Joshua203-byte/Pcb/Guía_del_Estado_del_Arte_Infografía.png

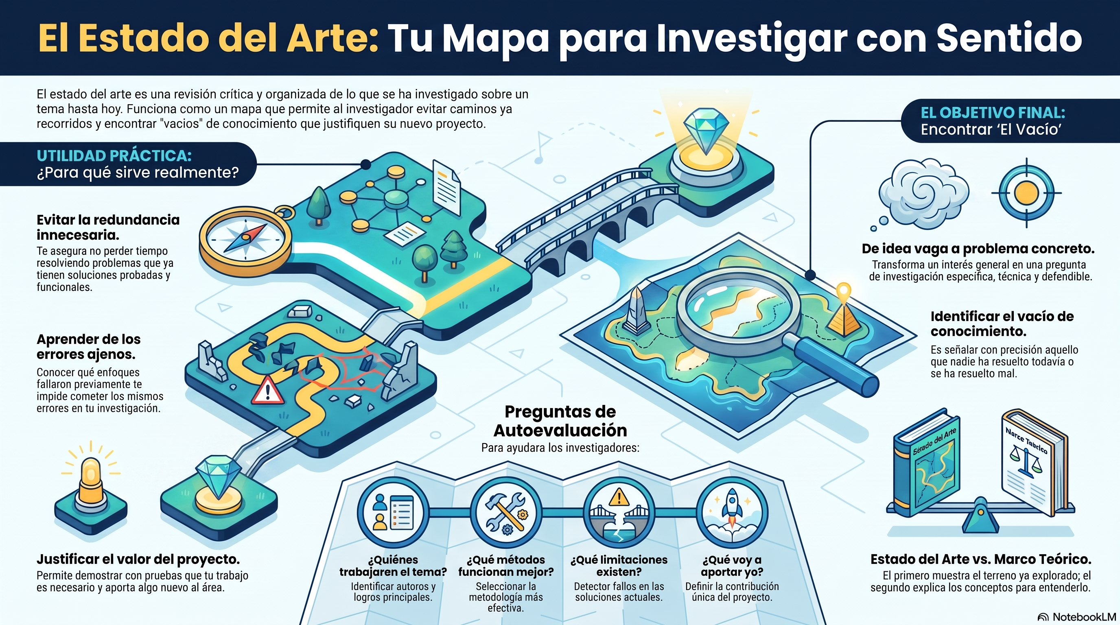
Guía_del_Estado_del_Arte_Infografía.png
