Joshua203-byte/Pcb/Avance2_secciones.pdf

UNIVERSIDAD — ASIGNATURA DE SEMICONDUCTORES Aprendizaje Basado en Proyectos

# Sistema de monitoreo electrónico y modelo predictivo de mantenimiento de un panel solar

Segundo avance del proyecto

Fase 3 — Diseño del circuito de adquisición Secciones: componentes, esquemático, dashboard, muestreo, alimentación, transmisión y montaje

INTEGRANTES

Joshua Garcilazo
Daniel Salguero
Alfredo Cortez

DOCENTE

Karen Pimentel

12 de octubre de 2026

## Índice

I | Introducción | 3
II | Microcontrolador y acondicionamiento de señal | 3
III | Alimentación del circuito | 5
IV | Transmisión y registro de datos | 5
V | Estrategia de muestreo | 7
VI | Decisión de montaje del módulo | 7
VII | Esquemático y lista de componentes | 9
VIII Diseño del dashboard | 9
IX | Simulación o pruebas físicas | 11
X | Limitaciones y ajustes pendientes | 15
Referencias | 16
Anexo A. Esquemático completo (A3) | 18

# Sistema de monitoreo electrónico y modelo predictivo de mantenimiento de un panel solar

Segundo avance — componentes, esquemático, dashboard y simulación

Joshua Garcilazo, Daniel Salguero y Alfredo Cortez Asignatura de Semiconductores — Aprendizaje Basado en Proyectos Docente: Karen Pimentel
12 de octubre de 2026

Resumen—Se presenta el diseño del sistema de adquisición del segundo avance. Con un voltaje de circuito abierto de 9 V, el ESP32 y el ADS1115 se dimensionan con un divisor de 4.3:1 y la escala de ±4.096 V (cuenta de 0.54 mV en el módulo), y la corriente se mide sobre derivaciones de 1 Ω. El circuito se alimenta con una batería externa de 10 000 mAh (consumo medio de 164 mA a 5 V con Wi-Fi, unas 27 h de autonomía) y el ESP32 envía cada barrido por Wi-Fi a un servidor local, que lo guarda en CSV y alimenta un dashboard donde el índice de rendimiento diario, corregido por temperatura, activa una alerta de mantenimiento. Se incluyen el esquemático, la lista de materiales (USD 32.57), la estrategia de muestreo (barrido de

### 23 puntos de unos 2 min, con descarte por irradiancia inestable)

y la decisión de montaje: a partir de la literatura y de una simulación de cielo despejado para el sitio (13.67° N) se adopta un módulo fijo a 30° al sur, que en noviembre y diciembre rinde 9 % más que a 14° y conserva la comparabilidad del índice. La simulación del circuito completo (ngspice) confirma que las lecturas de V, I, temperatura e irradiancia quedan dentro de rango en escenarios de 200 a 1 100 W/m²
y de 15 a 65 °C, con
una diferencia de −0.4 % en la potencia máxima frente a la teoría a 1 000 W/m²

Palabras clave—ADS1115, acondicionamiento de señal, curva I-V, dashboard, índice de rendimiento, Wi-Fi, alimentación por batería, montaje fijo.

I. INTRODUCCIÓN

Este documento presenta el segundo avance del proyecto: la selección de componentes (microcontrolador, acondicionamiento de señal, alimentación y medio de transmisión), el esquemático con su lista de materiales, el diseño del dashboard, la estrategia de muestreo y la decisión de montaje del módulo. Completa el diseño del primer avance [1], que fijó los sensores (ADS1115, derivaciones de 1 Ω, divisor 33 kΩ/10 kΩ, DS18B20), el banco de ocho resistencias conmutadas por relés y el protocolo pulsado de medición. La sección de simulación se integra cuando se reciban sus resultados.
El criterio que gobierna las decisiones es el mismo del primer avance: el sistema debe distinguir entre pérdidas reversibles y degradación permanente, y por eso se prioriza la repetibilidad entre sesiones sobre la ganancia energética absoluta. El cambio más importante respecto del primer avance es el voltaje de circuito abierto del módulo: las pruebas del equipo indican 9 V y no los 6.0 a 6.5 V supuestos, lo que obliga a cambiar la escala del canal de voltaje (sección II).

TABLA 1
ALTERNATIVAS DE MICROCONTROLADOR (DATOS DE LAS HOJAS DE DATOS DE CADA FABRICANTE)
Opción | Lógica | Wi-Fi | GPIO | Decisión
ESP32- WROOM-32 [22] | 3.3 V | 802.11 b/g/n | hasta 32 | Elegido
Arduino | Uno
(ATmega328P)
[23]
5 V | No | 14 digitales
y | 6
analógicas

Descartado:
requiere | adaptar
niveles | y | un
módulo Wi-Fi
Raspberry Pi
Pico W [24]

3.3 V 802.11n (2.4
GHz)
26 | Viable; | se
mantiene el ESP32
por | continuidad
con | el | primer
avance

II. MICROCONTROLADOR Y ACONDICIONAMIENTO DE SEÑAL

A. Microcontrolador
Se mantiene el ESP32-WROOM-32 del primer avance [1]. Cumple los requisitos del diseño: su lógica es de 3.3 V, igual que la del ADS1115 y la de las entradas ópticas del módulo de relés [26]; tiene bus I²C por hardware (SDA en GPIO21 y SCL en GPIO22) y 1-Wire por software (GPIO4); y trae radio Wi-Fi integrada para la transmisión de la sección IV, sin módulos adicionales. Las ocho salidas hacia los relés usan GPIO13, 14, 16, 17, 18, 19, 23 y 25, que evitan los pines de arranque (GPIO0, 2, 12 y 15, entre otros) cuyo nivel al encender condiciona el modo de arranque del chip. El convertidor interno no se usa para medir, así que el ADC2 y el Wi-Fi no entran en conflicto.
La Tabla 1 compara el ESP32 con las otras opciones razonables del curso. El criterio decisivo es que el sistema necesita Wi-Fi, lógica de 3.3 V compatible con el ADS1115 y suficientes salidas digitales, sin módulos extra.
B. Convertidor analógico-digital
La Tabla 2 justifica el uso de un convertidor externo. Con 9 V y unos 0.2 A, la señal útil es pequeña frente al error del ADC interno del ESP32, cuya característica es no lineal y exige calibración por unidad [22]. El ADS1115 ofrece 16 bits, entrada diferencial (necesaria para leer la derivación sin referenciarla a tierra) y amplificador de ganancia programable [15], con el cual la cuenta es de 125 µV en ±4.096V y de 15.6 µV en ±0.512V.

TABLA 2
ALTERNATIVAS DE CONVERSIÓN ANALÓGICA-DIGITAL
Opción | Bits | Cuenta | Observación

ADC interno del
ESP32
12 | 0.8 mV (3.3 V) | No | lineal; | sin
entrada diferencial
MCP3008 [25] | 10 | 3.2 mV (3.3 V) | Pseudodiferencial,
sin | PGA: | la
derivación | (0.2
a 0.3 V) daría pocas
cuentas
ADS1115 [15] | 16 | 125 a 15.6 µV | Elegido: | PGA
y | entradas
diferenciales

TABLA 3
ESCALAS DEL CANAL DE VOLTAJE (DIVISOR 4.3:1, ESCALA DE ±4.096V)
Condición | Módulo (V) | En A0 (V) | Cuentas
Voc de las pruebas | 9.0 | 2.09 | 16 744
Voc con carga (práctica 3) | 9.09 | 2.11 | 16 912
Máximo de diseño | 11 | 2.56 | 20 465
Límite de la escala de ±2.048 V | 8.8 | 2.05 | —
Límite práctico (VDD = 3.3 V) | 14.2 | 3.30 | 26 400
Límite absoluto (VDD +0.3 V) | 15.5 | 3.60 | —
C. Canal de voltaje
El voltaje del módulo se mide en A0 con el divisor R1 = 33 kΩ y R2 = 10 kΩ:

VADC = Vmod

R2
R1 +R2

=

Vmod
4.3
. | (1)

El primer avance supuso un voltaje de circuito abierto de 6.0 a 6.5 V [1]; las pruebas del equipo indican en cambio 9 V (en la práctica 3 se midieron 9.09 V con carga [13], de modo que el valor real es igual o mayor). Con ese dato el divisor entrega 2.09 V, por encima de la escala de ±2.048V del primer avance, que se saturaría desde los 8.8 V del módulo. Por eso el canal se opera en la escala de ±4.096V (Tabla 3), con una cuenta de 125 µV, es decir 0.54 mV en el módulo. Se toma 11 V como máximo de diseño, para dejar margen por irradiancia alta y temperatura baja.
El divisor consume 9 V/43 kΩ ≈ 0.21mA (0.1 % de la corriente nominal), que se descuenta en el cálculo de la corriente. El filtro R3 = 1 kΩ y C1 = 0.1µF (corte de unos 1.6 kHz) limita el ruido sin afectar el asentamiento (sección V). La impedancia de entrada del ADS1115 es de varios megaohmios [15], por lo que el error de carga sobre el divisor (unos 7.7 kΩ equivalentes) es del orden de 0.1 %, y se corrige en la calibración.
D. Canal de corriente
La corriente del módulo se mide como la caída en una derivación de 1 Ω y 1 W, con lectura diferencial entre A2 y A3 (R_sh1 en el esquemático); la corriente de la celda de referencia se mide con otra derivación igual en A1. Con la escala de ±0.512V la cuenta es de 15.6 µV, o 15.6 µA sobre 1 Ω. Con 1.5 W y 9 V la corriente de cortocircuito esperada es de unos 0.21 A (hasta 0.33 A según el primer avance), es decir de 0.21 a 0.33 V sobre la derivación: entre 41 y 64 % de la escala, con un margen de 1.6 veces. La potencia disipada es I

2R ≤ 0.11W, muy por debajo de 1 W. Como el voltaje se toma en los terminales del módulo, la caída en la derivación no sesga la lectura de V; solo desplaza ligeramente el punto de operación.

E. Canal de temperatura
El DS18B20 se lee por 1-Wire en GPIO4, con una resistencia de subida de 4.7 kΩ (R4) a 3.3 V y un capacitor de desacople de 0.1 µF (C3). Su exactitud es de ±0.5

◦C entre −10 ◦C y 85 ◦C y
su resolución de 0.0625 ◦C a 12 bits [16]. Se fija al respaldo del módulo con cinta de aluminio, para que mida la temperatura de la celda y no la del aire.
F. Canal de irradiancia
La irradiancia se mide con una celda de referencia: otro módulo igual (J4) en el mismo plano que el de prueba, en cortocircuito a través de una derivación de 1 Ω (R_sh2, entrada A1, escala de ±0.512 V). La corriente de cortocircuito de una celda de silicio es proporcional a la irradiancia, y al ser del mismo material y de la misma ventana que el módulo medido, tiene su misma respuesta espectral y angular, lo que no ocurre con un fotorresistor (LDR), cuya respuesta es no lineal, lenta y con tolerancias de decenas de por ciento, ni con un fotodiodo suelto. Un piranómetro de termopila sería más exacto, pero cuesta mucho más que todo el proyecto. Con la Isc supuesta de 0.212 A a 1 000 W/m²
la señal es de 42 a 233 mV para 200 a 1 100 W/m²

(resolución de 0.07 W/m² por cuenta, 2.2 veces de margen en el máximo). La relación entre tensión e irradiancia debe calibrarse con una referencia o con los datos de la celda, y por eso la incertidumbre de G (supuesta de 3 a 5 % sin calibrar) domina la del índice de rendimiento.

G. Protección de entradas
Las entradas del ADS1115 admiten de −0.3 V aVDD+0.3 V (3.6 V con 3.3 V) [15]. En A0 el divisor mantiene la entrada bajo ese límite hasta 15.5 V en el módulo, y en caso de una sobretensión (por ejemplo 20 V, que da 4.65 V en A0) los diodos internos de la entrada limitarían con una corriente menor de 0.1 mA, pues la resistencia en serie es de unos 8.7 kΩ (el equivalente del divisor más R3), corriente muy pequeña para los diodos de protección de la entrada (la hoja de datos fija el límite de VDD + 0.3 V); R3 y C1 filtran además los transitorios. En las derivaciones la señal máxima es de 0.23 V, con modo común cercano a tierra (derivación en el lado de baja), de modo que no hay riesgo con el módulo conectado de forma normal. No se agregan diodos TVS ni zener porque el módulo no puede entregar más de unos 10 V y la corriente de cortocircuito es de 0.2 A.
H. Presupuesto de error
La Tabla 4 resume los errores máximos de cada canal, sin calibrar y con la calibración propuesta. Las tolerancias de las resistencias son de 1 % (película metálica), la ganancia del ADS1115 se toma del orden de 0.15 % máximo [15] y la cuantización (125 µV en A0 y 15.6 µV en la derivación) es despreciable frente a las demás (menos de 0.01 % en el punto de máxima potencia). El efecto de carga del ADS1115 sobre el divisor (0.17 %) proviene de la simulación (sección IX).
Los 3.0 % de la potencia sin calibrar son menores que el umbral de 10 % del indicador de mantenimiento, de modo que el

TABLA 4
ERRORES MÁXIMOS ESTIMADOS EN EL PUNTO DE MÁXIMA POTENCIA
Fuente | Sin calibrar | Con calibración
Divisor R1–R2 (1 %) | 1.5 % en V | ajustable
Derivación (1 %) | 1.0 % en I | ajustable
Ganancia del ADS1115 | 0.15 % | —
Carga del ADS1115 | 0.17 % en V | corregible
Cuantización | < 0.01 % | < 0.01 %
Voltaje (suma lineal) | 1.8 % | exactitud | del
| | multímetro
Corriente (suma lineal) | 1.2 % | exactitud | del
| | multímetro
Potencia | ≈ 3.0 % | ≈ la del multímetro
Temperatura (DS18B20) | ±0.5 °C | 0.2 % en la potencia

TABLA 5
PRESUPUESTO DE CONSUMO A 5 V
Elemento | Corriente (mA)
ESP32 (placa, Wi-Fi conectado), valor de diseño | 130
ADS1115, típico [15] | 0.15
DS18B20, activo [16] | 1.5
Reposo (sin relés cerrados) | 131.7
Relé por canal (bobina 71 [26] + optoacoplador 5), supuesto | 76
Ocho canales cerrados (pico del barrido) | 608
Pico total | 740
Promedio de relés con ciclo de trabajo 5.4 % | 32.8
Promedio total | 164

sistema distingue la suciedad sin calibración fina; la calibración contra el multímetro (exactitud típica de 0.5 a 1 %) reduce el error a ese orden y se hará con las pruebas físicas.

III. ALIMENTACIÓN DEL CIRCUITO

A. Presupuesto de consumo
Los ensayos serán de varias horas a la intemperie y sin toma de corriente cercana. El consumo se estimó con los valores de la Tabla 5. El ESP32 se opera con la conexión Wi-Fi activa (sección IV); se toma 130 mA como valor de diseño promedio, entre el reposo de radio (25 a 35 mA) y la transmisión (250 a 280 mA) medidos en una placa de desarrollo [14]. El valor incluye el convertidor USB–UART y el LED de la placa y se verificará con el montaje real. Para los relés se supone una bobina de 5 V y unos 71 mA por canal, más unos 5 mA de optoacoplador y LED; es un supuesto a confirmar con la hoja del módulo adquirido. El ciclo de trabajo de los relés se calcula como

D =

ton

tint

=

0.27 s
5 s = 5.4%, | (2)

donde ton = 0.20 s de asentamiento más unos 0.07 s de lectura (sección V). El promedio de 164 mA a 5 V equivale a 0.82 W y, en una sesión de 6 h, a 4.9 Wh. Los picos de transmisión del Wi-Fi (250 a 280 mA) no coinciden con los de los relés, porque el firmware no transmite mientras haya relés cerrados.

B. Alternativas
Se adopta una batería externa USB (power bank). La Tabla 6 resume la comparación. Con una capacidad nominal de 10 000 mAh a 3.7 V (37 Wh) y un factor de aprovechamiento de 60 % a

TABLA 6
ALTERNATIVAS DE ALIMENTACIÓN
Alternativa | Ventaja | Riesgo o costo
Red de 115 V con adaptador de 5 V y extensión | Sin límite de autonomía | Requiere toma y extensión a la intemperie (riesgo eléctrico y de lluvia); adaptador conmutado
USB de la laptop (todo) | Sin componentes adicionales | Límite de 500 mA en USB 2.0 (900 mA en USB 3.x) frente a un pico de 740 mA

Batería de 9 V con regulador

7805 | — | Descartada en el primer avance: costo recurrente y caída de tensión
Batería externa USB | Independiente de la red; capacidad sobrada; sin cambios en el circuito | Algunos modelos se apagan con corrientes bajas

5 V por las pérdidas de conversión (supuesto), la autonomía es

taut =

ηu Enom

Pprom

=

0.6×37 Wh
0.82 W
≈ 27 h, | (3)

unas 4.5 veces la sesión de 6 h de la prueba de estrés prevista en el plan de trabajo. Tanto el adaptador como la batería incluyen un convertidor conmutado; el ruido de alimentación se mitiga con la referencia interna del ADS1115 y el filtrado descritos en el primer avance [1], y se verificará en las pruebas.

C. Arquitectura adoptada y precauciones
Como se ve en la Fig. 1, la batería externa alimenta al ESP32 (por el pin VIN) y a las bobinas del módulo de relés, y la laptop recibe los datos por Wi-Fi. Se descartó dejar las bobinas solas en la batería porque su consumo medio sería de unos 33 mA y muchas baterías se apagan con corrientes bajas; con el ESP32 en el mismo circuito la carga mínima es de unos 130 mA. Las precauciones son:
- Una sola fuente de 5 V. El cable USB solo se conecta para programar o depurar y con la batería desconectada, para evitar dos fuentes de 5 V en paralelo. Con el Wi-Fi, durante los ensayos no hace falta ningún cable entre la placa y la laptop.
- Picos. El pico de 740 mA ocurre solo con todos los relés cerrados y dura menos de 0.3 s; está dentro de la capacidad de la batería.
- Apagado automático. Se probará la batería elegida con la carga real antes de cada sesión de varias horas.

IV. TRANSMISIÓN Y REGISTRO DE DATOS

A. Medio de transmisión
Los datos se envían del ESP32 a la laptop por Wi-Fi (2.4 GHz) mediante una petición HTTP POST con contenido JSON a un servidor que se ejecuta en la laptop. El ESP32 no puede usar la dirección localhost, que en el ESP32 se refiere a sí mismo; debe usar la dirección IP de la laptop en la red local. La red puede ser la de un enrutador o un punto de acceso creado por la propia laptop o por un teléfono, siempre en 2.4 GHz, que es la única banda del ESP32; con un punto de acceso propio no se depende del alcance de la red doméstica y la dirección de la laptop es fija. Frente al USB, el Wi-Fi elimina el cable entre

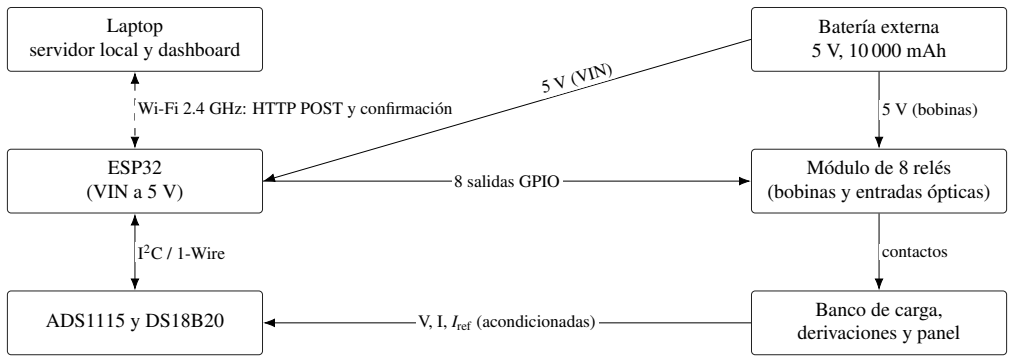
[picture p2: figure]
Laptop servidor local y dashboard; Batería externa 5 V, 10 000 mAh; ESP32 (VIN a 5 V); Módulo de 8 relés (bobinas y entradas ópticas); ADS1115 y DS18B20; Banco de carga,; derivaciones y panel; Wi-Fi 2.4 GHz: HTTP POST y confirmación; 5 V (VIN); 5 V (bobinas); 8 salidas GPIO; 2C / 1-Wire; contactos; V, I, Iref (acondicionadas)

Fig. 1. Arquitectura de alimentación y datos. La batería es la única fuente de 5 V: alimenta al ESP32 y a las bobinas de los relés. La laptop se comunica con el ESP32 solo por Wi-Fi (línea discontinua). La referencia de tierra es común a los bloques conectados por cable.

TABLA 7
ALTERNATIVAS DE MEDIO DE TRANSMISIÓN
Medio | Hardware extra | Ventajas y desventajas
USB serie | Ninguno (cable) | Sin pérdidas, pero ata la placa a
la laptop y mezcla alimentación y datos
Bluetooth LE Ninguno
(integrado)

Bajo consumo; requiere un
puente para el servidor y el alcance es corto
LoRa | Módulos | en
ambos extremos

Alcance innecesario aquí; mayor costo y complejidad
Wi-Fi 2.4
GHz

Ninguno
(integrado)
Elegido: | compatible | con
HTTP/JSON y con el dashboard; mayor consumo

la placa y la laptop y la posible alimentación en paralelo de la placa, y permite ver el dashboard desde otro dispositivo de la misma red.
El costo es energético y de ruido: la transmisión eleva el consumo del ESP32 a unos 250 a 280 mA [14] y es una fuente de radiofrecuencia y de caída de tensión cerca de las entradas analógicas. Por eso el firmware sigue la regla medir, luego transmitir: las lecturas del ADS1115 se hacen siempre fuera de las ráfagas de transmisión, y no se transmite mientras haya relés cerrados. El ESP32 no emplea su convertidor interno, de modo que no hay conflicto con el uso del Wi-Fi. El puerto USB se conserva como respaldo y para depuración, con las mismas líneas CSV.
La Tabla 7 resume por qué se eligió Wi-Fi frente a las otras opciones.
B. Servidor local y confiabilidad
En la laptop se ejecuta un servidor sencillo (Python) con tres funciones: recibir los datos y confirmarlos, guardarlos en un archivo CSV y servir el dashboard. Para no perder datos si la conexión se interrumpe:
- El ESP32 reúne los puntos de un barrido y los envía en una sola petición al terminar (unos 2.5 kB en JSON), y las lecturas ligeras en peticiones breves. Los barridos no confirmados se conservan en la memoria flash y se reenvían.
- Cada barrido lleva su sweep_id; el servidor descarta duplicados y responde con una confirmación que incluye la hora del servidor, con la que el ESP32 sincroniza su reloj sin

necesitar internet.
- Si el servidor no responde, la lectura se marca y se conserva; no se interpola ni se descarta (sección E).
- Los datos de la red (nombre y contraseña) se guardan en un archivo de configuración fuera del repositorio de código.
C. Formato del dato
Cada punto se registra como un objeto JSON en la transmisión y como una línea de un archivo CSV en la laptop, con las columnas de la Tabla 8. Se guardan los conteos crudos del convertidor además de los valores en unidades físicas, de modo que la calibración (valores reales de resistencias, factor del divisor) pueda reaplicarse después sin perder información. Las magnitudes derivadas (potencia, eficiencia, potencia a 25 °C e índice de rendimiento) se calculan en la laptop.
D. Cadencia
Durante una sesión de ensayo (varias horas) la celda de referencia permanece descubierta, y se cubre al terminar, como establece el protocolo del primer avance. Se propone: una lectura ligera cada 30 s (voltaje de circuito abierto, corriente de la celda de referencia y temperatura) y un barrido completo de la curva cada 10 min. Un barrido de 23 puntos genera unos 1.6 kB en CSV, es decir, unos 10 kB por hora; el almacenamiento no es una restricción. Las lecturas ligeras se transmiten tras cada medición y el barrido, al terminar. La cadencia se ajustará con los resultados de las pruebas.
E. Política de datos faltantes
La cantidad de datos faltantes afecta fuertemente la tasa de degradación estimada, y filtrar los datos corruptos mejora la exactitud de todas las técnicas evaluadas [18]; la guía de trabajo del curso resume del mismo estudio desviaciones de 0.07 a 0.2 %/año con 10 % de datos faltantes y de más de 0.6 %/año con 50 % en valores mensuales [19]. En consecuencia: (i) nunca se interpolan datos; una lectura inválida se marca con flag ̸= 0 y se conserva; (ii) se reporta el porcentaje de barridos válidos de cada sesión; y (iii) una sesión con menos de 90 % de barridos válidos se repite. El umbral de 90 % corresponde al nivel de datos faltantes de 10 % del estudio citado.

TABLA 8
FORMATO DEL ARCHIVO CSV
Columna | Unidad | Descripción
timestamp_pc | ISO 8601 | Hora de la laptop (UTC−6) al recibir el dato.
t_ms | ms | Tiempo del ESP32 desde el arranque, para medir intervalos dentro de un barrido.
sweep_id | — | Número consecutivo del barrido.
pt | — | Índice del punto (0 corresponde a circuito abierto, todos los relés abiertos).
mask | hex | Máscara de 8 bits de los relés cerrados.
raw_v, raw_i, raw_ref | cuentas | Lecturas crudas promediadas del ADS1115 (voltaje, corriente del panel, corriente de la celda de referencia).
v_mod | V | Voltaje en los terminales del módulo, con la relación real del divisor.
i_mod | A | Corriente del módulo, con el valor real de la derivación y la corrección de la corriente del divisor.
i_ref | A | Corriente de cortocircuito de la celda de referencia (medida relativa de irradiancia).
t_cell | °C | Temperatura posterior del módulo; se registra al inicio y al final del barrido.
flag | — | 0: válido; 1: irradiancia inestable; 2: error de lectura o saturación.
V. ESTRATEGIA DE MUESTREO
A. Configuración del convertidor
El ADS1115 se opera en modo de disparo único a 475 muestras por segundo (2.1 ms por conversión) [15]. Se leen tres canales por punto: el voltaje en A0 a través del divisor, la corriente del panel de forma diferencial entre A2 y A3 y la corriente de la celda de referencia en A1. En los canales de corriente se usa la escala de ±0.512 V, que da 15.6 µV por cuenta y, sobre la derivación de 1 Ω, 15.6 µA [1]. Tras cada cambio de canal se descarta la primera conversión y se promedian las ocho siguientes; si el ruido aleatorio no está correlacionado, el promedio lo reduce en
√
8 ≈ 2.8 veces. El promedio no corrige errores sistemáticos ni deriva, que son competencia de la calibración. La escala del canal de voltaje es de ±4.096 V (sección II).
B. Secuencia de un punto
Para cada punto de la curva: (1) se cierra la combinación de relés; (2) se esperan 200 ms de asentamiento, que superan por amplio margen al filtro de entrada (la constante del divisor con el filtro RC es de unos 0.87 ms, y asentar a una cuenta de 16 bits requiere unas 11 constantes de tiempo, es decir, unos 10 ms); (3) se leen los tres canales en orden corriente, voltaje y referencia, en unos 70 ms; y (4) se abre la combinación. El desfase entre la corriente y el voltaje de un mismo punto es de unas decenas de milisegundos, frente a los minutos que separaron las dos lecturas en la práctica 3 [13], donde la irradiancia cambiaba entre ambas.
C. Duración del barrido y criterio de validez
Con N = 23 puntos, seleccionados entre las 256 combinaciones siguiendo [17], y un intervalo de tint = 5 s entre puntos, la duración del barrido es

Tb = N tint +2tT ≈ 23×5 s+2×0.75 s ≈ 117 s, (4)

donde tT = 0.75 s es el tiempo máximo de conversión del DS18B20 a 12 bits [16]; la temperatura se lee al inicio y al final y no en cada punto. Si el intervalo se redujera a 2 s, el barrido duraría unos 47 s y el ciclo de trabajo subiría a 13.5 %, con una potencia media de unos 0.19 W en la resistencia de 22 Ω (unos 1.4 W cerrada, según el primer avance), todavía lejos de los 2 W nominales; esa opción se evaluará después de verificar la temperatura de las resistencias en las pruebas.

TABLA 9
PARÁMETROS DE MUESTREO
Parámetro | Valor
Velocidad del ADS1115 | 475 SPS
Muestras promediadas por canal | 8 (más 1 descartada)
Escala de los canales de corriente | ±0.512 V
Asentamiento tras cerrar el relé | 200 ms
Lectura de los tres canales | ≈ 70 ms
Ciclo de trabajo (tint = 5 s) | 5.4 %
Puntos por barrido | 23
Duración del barrido | ≈ 117 s
Umbral de descarte ρmax | 2 % (inicial)
Barridos válidos requeridos por sesión | ≥ 90 %

Como el barrido dura minutos y la irradiancia cambia (práctica 3), la celda de referencia se lee en cada punto. Un barrido se descarta si

ρ =

max(Iref)−min(Iref)

Iref

> ρmax, | (5)

con ρmax = 2% como valor inicial, que se ajustará con la dispersión medida en cielo estable. Los barridos aceptados pueden normalizarse a una irradiancia común escalando la corriente de cada punto con Iref; ese procedimiento debe validarse antes de emplearse en el modelo.

VI. DECISIÓN DE MONTAJE DEL MÓDULO

A. Alternativas consideradas
Se compararon tres configuraciones, todas para el módulo bajo prueba y su celda de referencia, que deben conservar el mismo plano:
1) Montaje fijo: inclinación y orientación constantes, sin actuadores.
2) Giro de base (acimut): eje vertical que gira el conjunto para seguir el acimut del Sol, con inclinación fija.
3) Inclinación variable: eje horizontal orientado norte–sur que inclina el panel de este a oeste siguiendo el recorrido diario del Sol, con la base fija.
B. Evidencia de la literatura
La Tabla 10 resume los estudios consultados. Las cifras provienen de los resúmenes publicados; no se revisaron los

TABLA 10
GANANCIA DE ENERGÍA DE LOS SEGUIDORES FRENTE A UN MONTAJE FIJO
Ref. | Sitio | Resultado
[2] 217 sitios de
| EE. UU. (templados) | Acimut: +29 %; dos ejes: +34 % frente a fijo con inclinación óptima.
[3] | Europa y África | Dos ejes: +17.7 a +31.2 % sobre fijo óptimo;
| | la diferencia entre un eje y dos ejes varía de 0.42 a 23.4 % según la latitud.
[4] | Quito (ecuatorial) | El eje horizontal es la opción más ventajosa; dos ejes superan a un eje solo marginalmente.
[5] Zona tórrida
| latinoamericana | Un eje: hasta +23 %; el segundo eje agrega como máximo 4 %.
[6] | Revisión (PVsyst) | Ganancias de 10 a 50 %; el eje horizontal rinde mejor cerca del ecuador.
[7] Mediterráneo, 15
| días | Un eje: +24.4 %; dos ejes: +32.2 %.
[8] Kocaeli, un año,
| 2.7 kWp | Un eje: +28.7 % anual; LCOE 12.2 % menor.

TABLA 11
ENERGÍA ANUAL INCIDENTE SIMULADA (CIELO DESPEJADO)
Configuración | kWh/m² | vs 14° S (%) | vs 30° S (%)
Fijo, 14° al sur | 2 578 | 0 | +3.7
Fijo, 30° al sur (adoptado) | 2 487 | −3.5 | 0
Fijo, 30° al este o al oeste | 2 280 | −11.6 | −8.3
Fijo, 30° al norte | 1 976 | −23.4 | −20.5
Giro | de | base | (acimut),
inclinación 14°
2 956 | +14.6 | +18.9
Giro | de | base | (acimut),
inclinación 30°
3 267 | +26.7 | +31.3

Inclinación este–oeste (eje
horizontal N–S)
3 339 | +29.5 | +34.2
Dos ejes (referencia) | 3 527 | +36.8 | +41.8

textos completos.
En latitudes medias las ganancias se concentran entre 24 y 34 %. Cerca del ecuador, donde el Sol pasa próximo al cenit, la literatura coincide en que el eje horizontal es la mejor opción de un eje y en que el segundo eje agrega poco [4, 5, 6]. Esto es relevante porque el giro de base conserva una inclinación fija, y a baja latitud el acimut cambia mucho pero la geometría respecto del Sol cambia poco.
C. Simulación para el sitio
Para evaluar las tres alternativas en las condiciones de este proyecto se simuló un año completo de irradiancia en el plano del módulo para Antiguo Cuscatlán (13.67° N, 89.25° O, 920 m
s. n. m.). Se empleó la biblioteca pvlib [10], el modelo de cielo despejado de Ineichen y Perez [11], la transposición de Hay y Davies [12], albedo de 0.2 y paso de 5 min. Los seguidores se modelaron ideales, sin error de seguimiento ni consumo del actuador. La simulación es de cielo despejado y por tanto no incluye nubosidad.
Los resultados (Tabla 11, Fig. 2) son coherentes con la literatura: la inclinación este–oeste (+34 %) supera ligeramente al giro de base con inclinación de 30° (+31 %), y el giro de base con la inclinación igual a la latitud (14°) gana solo 19 %. También muestran que la orientación importa: a 30° de inclinación, un panel al este o al oeste rinde 8.3 % menos que
−20 | 0 | 20 | 40
Energía anual frente al fijo 30° sur (%)

Fijo 30° sur (adoptado)

Giro de base, inclin. 30°

Inclinación este–oeste

Dos ejes (referencia)

Fijo 30° este u oeste

Fijo 30° norte

0 %

+31 %

+34 %

+42 %

-8 %

-21 %

Fig. 2. Energía anual de cada alternativa frente al montaje fijo a 30° al sur (simulación de cielo despejado, 13.67° N).

E | F M A M | J | J | A | S | O N D

160

180

200

220

240
Energía incidente (kWh/m²·mes)

ventana de
ensayos
14° al sur | 30° al sur

Fig. 3. Energía mensual incidente con inclinación de 14° y de 30°, ambas al sur (simulación de cielo despejado). La zona sombreada indica los meses de los ensayos.

uno al sur, y uno al norte, 20.5 % menos.
Respecto de la inclinación fija, 14° (cercana a la latitud) maximiza la energía anual, pero a lo largo del año el óptimo cambia (Fig. 3). En noviembre y diciembre, que son los meses de los ensayos, 30° entrega 9.1 % más que 14° (446 frente a 409 kWh/m²
), mientras que en el año completo entrega 3.5 % menos. Esto concuerda con la regla de la práctica de laboratorio 3 [13], según la cual el ángulo conveniente en diciembre es del orden de ϕ +15◦ ≈ 29◦
D. Energía a escala del módulo y consumo del actuador
Con el área total de 0.01035 m² y la eficiencia aparente de 14.5 % del primer avance [1], el módulo produciría en promedio unos 10.2 Wh/día a 30° al sur en cielo despejado, y la inclinación este–oeste lo elevaría a unos 13.7 Wh/día: una ganancia de unos 3.5 Wh/día. Es una estimación idealizada, pero basta para el argumento de escala.
La ganancia es comparable con el consumo posible del actuador. En un experimento de aficionado con un seguidor pequeño [9], el motor con sus devanados energizados consumía unos 170 mA, es decir, unos 11 Wh/día de operar de forma continua frente a unos 4 Wh/día de ganancia; solo resultaba rentable con un ciclo de trabajo muy bajo (unos 2 s de cada 360 s). La fuente no está revisada por pares y no se presenta como evidencia cuantitativa general, sino como una ilustración del orden de magnitud. En un módulo de 1.5 W, un motor paso a paso de mayor tamaño exigiría además un controlador y una fuente propios, de modo que el seguimiento solo tendría ganancia neta con una gestión cuidadosa de la energía del actuador.
E. Efecto sobre la medición
El objetivo del proyecto es detectar degradación, no maximizar la energía. Un módulo móvil agrega fuentes de variación que el sistema fijo no tiene:
- Ángulo de incidencia variable. El índice de rendimiento (ec. 3 del primer avance) usa la corriente de la celda de referencia como medida de irradiancia; esto solo es válido si ambos módulos comparten plano y ángulo. Con un montaje fijo, esa condición se cumple por construcción.
- Error de seguimiento. En [9] se midió un desalineamiento de 12° a 16° con el seguidor en operación.
- Ruido eléctrico del actuador. Las corrientes de interés son de decenas de miliamperios con resolución de 15.6 µA; un motor y su controlador en la misma alimentación son una fuente de perturbación que habría que caracterizar.
- Cableado móvil y fatiga mecánica. Aumenta el riesgo de contactos intermitentes, que se confundirían con aumento de resistencia serie, el mismo mecanismo que se desea diagnosticar.
Con un montaje fijo, un error geométrico constante se cancela en el índice, que se normaliza contra el estado inicial del propio módulo (ec. 3 de [1]), de modo que la diferencia de 3.5 % anual respecto del óptimo geométrico no afecta la detección de tendencias.
F. Comparación y configuración adoptada
La Tabla 12 resume la comparación. Se adopta el montaje fijo con inclinación de 30° y orientación al sur geográfico (azimut de 180°), por cuatro razones: (i) en la ventana de ensayos rinde 9 % más que a 14° (Fig. 3); (ii) en la práctica 3 la potencia varió menos de 7 % entre 0° y 60° de inclinación y se recomendó 30° con orientación al sur [13]; (iii) preserva la comparabilidad del índice de rendimiento y de la celda de referencia; y (iv) no añade consumo, componentes ni riesgo de plazo. La inclinación y el azimut se fijarán con nivel y brújula y se documentarán fotográficamente. El seguimiento queda como trabajo futuro, con la comparación de este apartado como punto de partida.

VII. ESQUEMÁTICO Y LISTA DE COMPONENTES

A. Esquemático del circuito de adquisición
El esquemático (Fig. 4; completo, en tamaño A3, en el Anexo A) reúne el ESP32 (U1), el ADS1115 (U2), el DS18B20 (U3), el panel de prueba (J1) y el de referencia (J4), las dos derivaciones de 1 Ω (R_sh1 y R_sh2), el divisor R1–R2 con el filtro R3–C1, y el banco de ocho relés (K1 a K8) con sus resistencias de carga RL1 a RL8, gobernados desde el conector J2 del módulo de relés. La hoja incluye también la alimentación (batería externa J5 de 5 V, con el capacitor C4 de 10 µF, hacia VIN del ESP32 y hacia la alimentación del módulo de relés), las resistencias de subida R6 y R7 (4.7 kΩ) del bus I²C, y el modelo del módulo (fuente de corriente V1 de 0.212 A con el diodo D1) usado en la simulación. La Tabla 13 resume las conexiones y la Tabla 14, los componentes y su costo.
B. Lista de componentes y costo
La Tabla 14 reproduce la lista del primer avance [1], con los precios de las cotizaciones de Casa Rivas (CR; con 25 % de descuento estudiantil y IVA) y de Steren (con IVA), y la referencia de cada componente en el esquemático. El total a adquirir es de USD 32.57. La batería externa ya era propiedad del equipo y no se compró para este proyecto; se incluye con un valor de referencia de USD 20.00, de modo que el costo total del proyecto es de USD 52.57.

VIII. DISEÑO DEL DASHBOARD

A. Objetivo y usuario
El dashboard es la interfaz de quien opera la instalación y debe decidir si limpiar o revisar el módulo. Por eso se ordena de lo urgente a lo detallado: arriba, el estado de mantenimiento; después, las magnitudes del último barrido en tarjetas con unidades; luego las curvas I-V y P-V con la curva esperada de un módulo nuevo; y al final, la evolución del día y el histórico de 30 días (Figs. 5 y 6). Es una sola página HTML sin dependencias, que se abre en el navegador de la laptop, con tema claro y oscuro y exportación del barrido a CSV.
B. Datos y funcionamiento
Recibe los datos del servidor local (sección IV) como mensajes JSON por WebSocket o por consulta HTTP: inicio de barrido, puntos de tensión y corriente, y fin de barrido con la temperatura y la irradiancia. De los puntos de cada barrido calcula la potencia máxima, Voc, Isc y el factor de forma, y de ahí las magnitudes derivadas de la Tabla 15. Mientras no esté el hardware, un modo de simulación genera barridos con un modelo de diodo único (15 celdas en serie, Voc = 9 V a 25 °C y 1000 W/m²
, 1.5 W) y
cinco escenarios: panel limpio, suciedad moderada, suciedad severa, nube pasajera y día caluroso. Todas las cifras de las figuras provienen de esa simulación y no son mediciones.
C. Alerta de mantenimiento
El PR diario se calcula como cociente de sumas,

PRd =

∑Pmax
∑Pnom (G/1000)[1+γ(T −25)], | (6)

solo con los barridos de G ≥ 200W/m²
, como en la norma
IEC 61724-1. El estado es normal sobre el umbral, vigilar con uno o dos días seguidos bajo el umbral, y mantenimiento recomendado con tres. Exigir tres días evita alertar por jornadas nubladas aisladas. El umbral inicial es de 90 % y es editable: la degradación permanente descrita en el primer avance es de menos de 1 % al año [1], de modo que una caída de 10 % en pocas semanas apunta a causas reversibles, sobre todo suciedad. La alerta incluye un diagnóstico probable a partir de la última curva: si Isc cae más de 7 % respecto de lo esperado con el factor de forma normal, se sugiere suciedad o sombreado parcial;

TABLA 12
COMPARACIÓN DE LAS ALTERNATIVAS DE MONTAJE
Criterio | Fijo | Giro de base (acimut) | Inclinación este–oeste
Ganancia anual frente al fijo 30° S (simulada) | Referencia | +31 % (inclinación de 30°) | +34 %
Consumo del actuador | Ninguno | Motor y controlador | Motor y controlador
Ganancia neta tras el actuador | — | Positiva solo con ciclo de trabajo muy bajo [9] | Ídem
Elementos adicionales | Ninguno | Motor, controlador, fuente, base giratoria y referencia de posición | Motor, controlador, fuente, eje y referencia de posición
Complejidad mecánica | Baja | Alta (eje vertical con panel inclinado, carga de viento) | Media–alta
Complejidad de firmware | Ninguna | Control de posición y cálculo solar | Ídem
Efecto sobre la medición | Plano y ángulo constantes; referencia coplanar | Ángulo variable, error de seguimiento,
| | cableado móvil, ruido del actuador | Ídem
Fiabilidad a la intemperie | Alta | Media | Media
Riesgo de plazo (prototipo funcional: 26 a 30 de octubre) | Ninguno | Alto | Alto

AB

C

V1

212m

GND

R3
1K

PWR_FLAG GND

C3

100nF + | VSWEEP1
0 | GND

1 DQ 2

VDD 3 U3 DS18B20 R_sh2
1

1
2

# J1 Panel_prueba GND

GND

1
2
J4 PANEL_REFERENCIA | D1 D

C2
100nF

I1
300m

C1
0.1µF

R1
33K

R2

10K | + | V2

3.3 R5
0.1

ADDR 1

ALERT/RDY 2 GND

3

AIN0 4
AIN1 5
AIN2 6
AIN3 7 | VDD

8

SDA 9

# SCL 10 U2

ADS1115IDGS +3.3V

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
# J2MODULO_8_RELES R4

4.7K

R_sh1
1

3V3 1
EN 2 GPIO36 3 GPIO39 4 GPIO34 5 GPIO35 6 GPIO32 7 GPIO33 8 GPIO25 9 GPIO26 10 GPIO27 11 GPIO14 12 GPIO12 13 GND 14 GPIO13 15 GPIO9_/_SO2 16 GPIO10__/_S03 17 GPIO11_/_CMD 18
V5 19 | GPIO6_/_CLK 20 GPIO7__/_SD0 21 GPIO8__/_SD1 22 GPIO15 23 GPIO2 24 GPIO0 25 GPIO4 26 GPIO16 27 GPIO17 28 GPIO5 29 GPIO18 30 GPIO19 31 GND 32 GPIO21 33 GPIO3_/_RXD 34 GPIO1_/_TXD 35 GPIO22 36 GPIO23 37 GND 38 U1

ESP32-WROOM-32 GND

# RELAY_IN4 RELAY_IN2 RELAY_IN3 RELAY_IN1GND

RELAY_IN5

I2C_SDA RELAY_IN5 RELAY_IN4 RELAY_IN6 RELAY_IN3 | +5V
I2C_SCL RELAY_IN8 REF_AIN1 | RELAY_IN7

RELAY_IN7

RELAY_IN8 RELAY_IN6 +5V RELAY_IN2 RELAY_IN1 PWR_FLAG GND

GND

R1
33K

R2
10K

V2
3.3 | U2
| ADS1115IDGS

ADDR 1

ALERT/RDY 2 GND

3

AIN0 4
AIN1 5
AIN2 6
AIN3 7 | VDD

8

SDA 9

SCL 10 +3.3V D1 D GND

J1 Panel_prueba 1

2 | U3 DS18B20 | GND

1 DQ 2

VDD 3 C3

100nF C1
0.1µF GND

Fig. 4. Esquemático del circuito de adquisición (detalle del acondicionamiento de señal, el ESP32 y los sensores; el banco de relés y cargas se muestra completo en el Anexo A). Generado en KiCad.

si el factor de forma cae más de 8 %, resistencia serie alta
o conexiones deterioradas; y en otro caso, pérdida repartida compatible con envejecimiento. Estas reglas y el umbral son valores iniciales, que se calibrarán con la línea base del módulo limpio.
D. Interpretación del prototipo
En el escenario de suciedad moderada, el barrido de las 14:50 (irradiancia de 664 W/m²
, temperatura de celda de 46.3 °C) entrega 0.79 W frente a 0.89 W esperados (−11.2 %). La pérdida se concentra en la corriente (Isc de −11.0 %) y no en el voltaje

(Voc de 0.0 %) ni en la forma de la curva (factor de forma de −0.2 %). La eficiencia es de 11.5 % frente a 14.5 % nominal, el PR diario es de 88.2 % y el histórico lleva seis días bajo el umbral, por lo que se activa la alerta y el diagnóstico apunta a suciedad. Como la degradación del escenario está programada en la simulación, este resultado solo comprueba que los indicadores distinguen la causa; no valida el modelo con datos reales.

E. Alcance actual
El dashboard funciona con datos simulados. Falta conectarlo al servidor local con barridos reales del ESP32 y calibrar las reglas

TABLA 13
CONEXIONES DEL CIRCUITO DE ADQUISICIÓN
Función | Nodo del esquemático | Conexión
Bus I²C | U2: SDA (pin 9), SCL (pin 10) | GPIO21 (SDA) y GPIO22 (SCL); ADDR a GND
Voltaje del módulo | U2: AIN0 | Divisor R1 (33 kΩ) y R2 (10 kΩ), con filtro R3 (1 kΩ) y C1 (0.1 µF)
Corriente de la celda de referencia | U2: AIN1 | Derivación R_sh2 (1 Ω), panel de referencia J4
Corriente del módulo | U2: AIN2–AIN3 (diferencial) | Derivación R_sh1 (1 Ω) en serie con la carga, panel de prueba J1
Temperatura | U3: DQ | GPIO4, con resistencia de subida R4 (4.7 kΩ) a 3.3 V y C3 (0.1 µF)
Control de relés | J2: RELAY_IN1 a IN8 | GPIO13, 14, 16, 17, 18, 19, 23 y 25, respectivamente
Cargas | K1 a K8 con RL1 a RL8 | 2.2, 4.7, 10, 22, 47, 100, 220 y 470 Ω
Desacople | C2 | 0.1 µF en la alimentación (VDD) de U2
Alimentación | J5 (batería 5 V), C4 | +5 V a VIN de U1 y a la alimentación de J2 (pines 9 y 10); +3.3 V del regulador de U1 a U2, R4,
| | R6 y R7
Pull-ups I²C | R6, R7 | 4.7 kΩ de SDA y SCL a +3.3 V

TABLA 14
LISTA DE COMPONENTES Y COSTO
Ref. | Componente | Cant. | P. unit. (USD) | Subtotal (USD) | Fuente
J1, J4 | Módulo fotovoltaico 5 V / 1.5 W, AR-3302PANEL5V (prueba y referencia) | 2 | 6.95 | 13.90 | CR
U2 | Convertidor ADS1115, AR-ADS1115 | 1 | 3.71 | 3.71 | CR
U3 | Sonda DS18B20, AR-DS18B20A | 1 | 2.06 | 2.06 | CR
J2, K1–K8 | Módulo de 8 relés optoacoplado | 1 | 4.50 | 4.50 | Steren
R_sh1, R_sh2 | Derivación 1 Ω / 1 W, película metálica | 2 | 0.60 | 1.20 | Steren
R1 | Resistencia 33 kΩ (divisor) | 1 | 0.30 | 0.30 | Steren
R2 | Resistencia 10 kΩ, KD10N0.5 (divisor) | 1 | 0.15 | 0.15 | CR
R4, R6, R7 | Resistencia 4.7 kΩ (1-Wire y subida de I²C) | 3 | 0.30 | 0.90 | Steren
R3 | Resistencia 1 kΩ (filtro RC) | 1 | 0.30 | 0.30 | Steren
C1–C3 | Capacitor cerámico 0.1 µF | 3 | 0.10 | 0.30 | Steren
C4 | Capacitor 10 µF (alimentación de 5 V) | 1 | 0.25 | 0.25 | CR
RL1–RL6 | Banco de carga 2 W: 2.2, 4.7, 10, 22, 47 y 100 Ω | 6 | 0.40 | 2.40 | Steren
RL7, RL8 | Banco de carga 1/2 W: 220 y 470 Ω | 2 | 0.30 | 0.60 | Steren
— | Cinta de aluminio (fijación térmica) | 1 | 2.00 | 2.00 | Steren
Total a adquirir | | | | 32.57
U1 | ESP32-WROOM-32 | 1 | — | — | Disponible
— | Protoboard, conductores, multímetro y cautín | — | — | — | Disponible
J5 | Batería externa 5 V, 10 000 mAh (sección III); ya era propiedad del equipo, valor
| de referencia | 1 | 20.00 | 20.00 | Disponible
Costo total del proyecto (con el valor de la batería) | 52.57

de alerta con la línea base del módulo limpio.

IX. SIMULACIÓN O PRUEBAS FÍSICAS

Esta sección presenta la simulación del circuito de adquisición. Primero se resumen los valores teóricos de referencia (Tabla 16), que resultan de los divisores y escalas de la sección II, y luego se contrastan con los resultados simulados.

A. Modelo y método
La simulación se ejecutó con ngspice (el motor del simulador de KiCad 10) sobre el circuito de adquisición de la sección VII: el divisor R1 (33 kΩ) y R2 (10 kΩ), el filtro R3 (1 kΩ) y C1 (0.1 µF) hacia A0, la derivación R_sh1 de 1 Ω hacia A2–A3 y el banco de cargas de 2.2 a 470 Ω, con cada relé modelado como un interruptor con resistencia de contacto de 50 mΩ. El módulo se modeló como una fuente de corriente (fotocorriente de 0.212 A) en paralelo con un diodo (corriente de saturación de 3.74 nA y factor N = 19.5, es decir, 15 celdas en serie con factor de idealidad de 1.3), lo que da Voc = 9.0 V, Isc = 0.212 A y Pmax = 1.51 W a 7.6 V y 0.199 A (factor de forma de 0.79). Las entradas del ADS1115 se modelaron como 5 MΩ a tierra (valor supuesto, del orden de lo que indica la hoja de datos [15]). Estos parámetros del módulo son estimaciones coherentes con 1.5 W y con el Voc de 9 V, no mediciones. Las lecturas del ADS1115 se obtuvieron redondeando a la cuenta más cercana (125 µV en A0 y 15.625 µV en A2–A3).
Se simularon cinco cosas: (i) la curva I-V y P-V del módulo; (ii) el barrido de 23 puntos con el circuito completo, con las 255 combinaciones de relés disponibles y la selección descrita abajo; (iii) el transitorio al cerrar un relé; (iv) el mismo barrido con una pérdida de 11 % en la fotocorriente, que emula suciedad; y (v) escenarios de irradiancia y temperatura (subsección siguiente a los resultados).

TABLA 15
INDICADORES DEL DASHBOARD Y SU JUSTIFICACIÓN
Indicador | Cálculo | Por qué se muestra

V, I y P en el punto de
máxima potencia
Del barrido de 23 puntos; P = V I | Variables primarias; muestran el punto de operación y alimentan todo lo demás
Temperatura de celda | DS18B20 sobre el módulo | La potencia cae unos 0.4 %/°C; separa la pérdida térmica reversible de la
degradación
Irradiancia G | Celda de referencia coplanar (corriente de
cortocircuito relativa)

Normaliza la potencia; sin ella no se distingue una nube de suciedad

Eficiencia | real | contra
nominal

η = P/(GA), con A = 0.01035 m² ; nominal 14.5
% (1.5 W en 1000 W/m²
)

Compara el rendimiento del módulo con su placa

Índice de rendimiento (PR) corregido por temperatura

PR = P/[Pnom(G/1000)(1+γ(T −25))] | Índice de la norma IEC 61724-1 independiente del clima; es la señal central del
modelo de degradación
Potencia | a | STC | y
degradación

PSTC = P/[(G/1000)(1 + γ∆T)]; D = (Pnom −
PSTC)/Pnom

Estimación en porcentaje, comparable con la placa

Factor de forma, Voc e Isc contra lo esperado

FF = P/(VocIsc); desviación respecto de la curva de un módulo nuevo en las mismas G y T

La degradación afecta distinto a cada parámetro (en el primer avance, el factor de forma cae más que Isc y casi no cambia Voc) [1]; permite diagnosticar la causa
Curvas I-V y P-V | Puntos medidos y modelo de diodo | Evidencia visual del barrido y del punto de máxima potencia
PR diario (30 días) y umbral | Cociente de sumas diarias, solo con G ≥ 200
W/m²

Tendencia de largo plazo que filtra el ruido de las nubes

Alerta de mantenimiento | Regla de la subsección C | Convierte la tendencia en una acción para el usuario

TABLA 16
VALORES TEÓRICOS DE REFERENCIA PARA LA SIMULACIÓN
Magnitud | Valor | Tensión en el ADC | Cuentas
Voc | 9.0 V | 2.093 V (A0) | 16 744
Vmp | 7.5 V | 1.744 V (A0) | 13 954
Isc | 0.212 A | 0.212 V (A2–A3) | 13 568
Imp | 0.200 A | 0.200 V (A2–A3) | 12 800

Escalas de ±4.096 V (cuenta de 125 µV) en A0 y de ±0.512 V (15.625 µV) en A2–A3. Isc, Vmp e Imp son estimaciones coherentes con 1.5 W.

B. Selección de los 23 puntos
Con las 255 combinaciones de cargas en paralelo se calculó el punto de operación de cada una. Para repartir los puntos de forma pareja a lo largo de la curva se tomó el circuito abierto y, de las demás combinaciones, las 22 más próximas a puntos equidistantes en longitud de arco de la curva I-V normalizada (V/Voc, I/Isc). Las máscaras resultantes (en hexadecimal, con el bit 0 en RL1 y el bit 7 en RL8) son, de menor a mayor voltaje: 01, 3C, A4, 78, E8, C8, 08, F0, 70, B0, 30, D0, 50, 90, 10, E0, 60, A0, 20, C0, 40, 80 y 00 (circuito abierto). Esta selección es una propuesta de la simulación y debe confirmarse con el módulo real, cuya curva puede diferir.
C. Resultados
La Fig. 7 muestra que los 23 puntos caen sobre la curva del módulo y cubren tanto la zona plana como el codo. La Tabla 17 resume algunos puntos. Los resultados son:
- Escalas. En circuito abierto A0 recibe 2.090 V (16 723 cuentas), 0.1 % por debajo de los 2.093 V teóricos de la Tabla 16; la diferencia la explica el efecto de carga de la entrada del ADS1115. Con 11 V (máximo de diseño) serían 2.56 V, lejos de los 4.096 V de la escala. En la derivación, la corriente de cortocircuito produce 0.212 V (13 567 cuentas), 41 % de la escala de 0.512 V, con un margen de 2.4 veces.
- Punto de máxima potencia. El barrido encuentra 1.5075 W con la combinación de 35.8 Ω (máscara D0), frente a 1.512 W de la curva exacta (diferencia de 0.3 %). Tras convertir

TABLA 17
PUNTOS DEL BARRIDO SIMULADO (VALORES DE A0 Y A2–A3 CON SUS CUENTAS)
Req (Ω) | Máscara | V (V) | A0 (V) | Derivación (mV) | P (W)
∞ | 00 | 9.00 | 2.090 (16 723) | 0.0 (0) | 0.000
2.2 | 01 | 0.69 | 0.160 (1 280) | 212.0 (13 567) | 0.146
8.9 | A4 | 2.11 | 0.490 (3 920) | 212.0 (13 565) | 0.447
22.0 | 08 | 4.88 | 1.134 (9 068) | 211.8 (13 557) | 1.034
32.0 | 30 | 6.89 | 1.599 (12 789) | 208.7 (13 354) | 1.437
35.8 | D0 | 7.45 | 1.729 (13 835) | 202.4 (12 952) | 1.507
42.7 | 90 | 8.00 | 1.858 (14 861) | 182.8 (11 700) | 1.463
68.8 | 60 | 8.57 | 1.989 (15 911) | 122.8 (7 858) | 1.052
149.9 | C0 | 8.84 | 2.053 (16 420) | 58.6 (3 750) | 0.518
470.0 | 80 | 8.96 | 2.080 (16 638) | 19.0 (1 217) | 0.170

las cuentas a voltios y amperios, la potencia estimada es de 1.5049 W, un error de −0.17 % que proviene de la carga de la entrada del ADS1115 sobre el divisor y que se corrige con la calibración.
- Corriente del divisor. El divisor consume V/43 kΩ (≈ 0.2 mA en circuito abierto), que no pasa por la derivación; la corriente del módulo es la de la derivación más esa corriente, una diferencia de 0.1 % que el cálculo debe incluir.
- Suciedad. Con 11 % menos de fotocorriente, la potencia máxima del barrido cae a 1.333 W (−11.6 %), la corriente de cortocircuito en la derivación baja de 212 a 189 mV y el voltaje de circuito abierto casi no cambia (8.945 V frente a 9.004 V). Es el patrón que el dashboard usa para sugerir suciedad.
D. Escenarios de irradiancia y temperatura
Para el rubro de escenarios se repitió el barrido de 23 puntos con el circuito completo variando la irradiancia G (200 a 1 100 W/m² a 25 °C) y la temperatura del módulo (15, 45 y 65 °C a 1 000 W/m²
, más dos combinaciones intermedias). La fotocorriente se escaló como Iph = 0.212(G/1000)[1 + 0.0005(T − 25)] (coeficiente de Isc de +0.05 %/°C, valor típico del silicio,

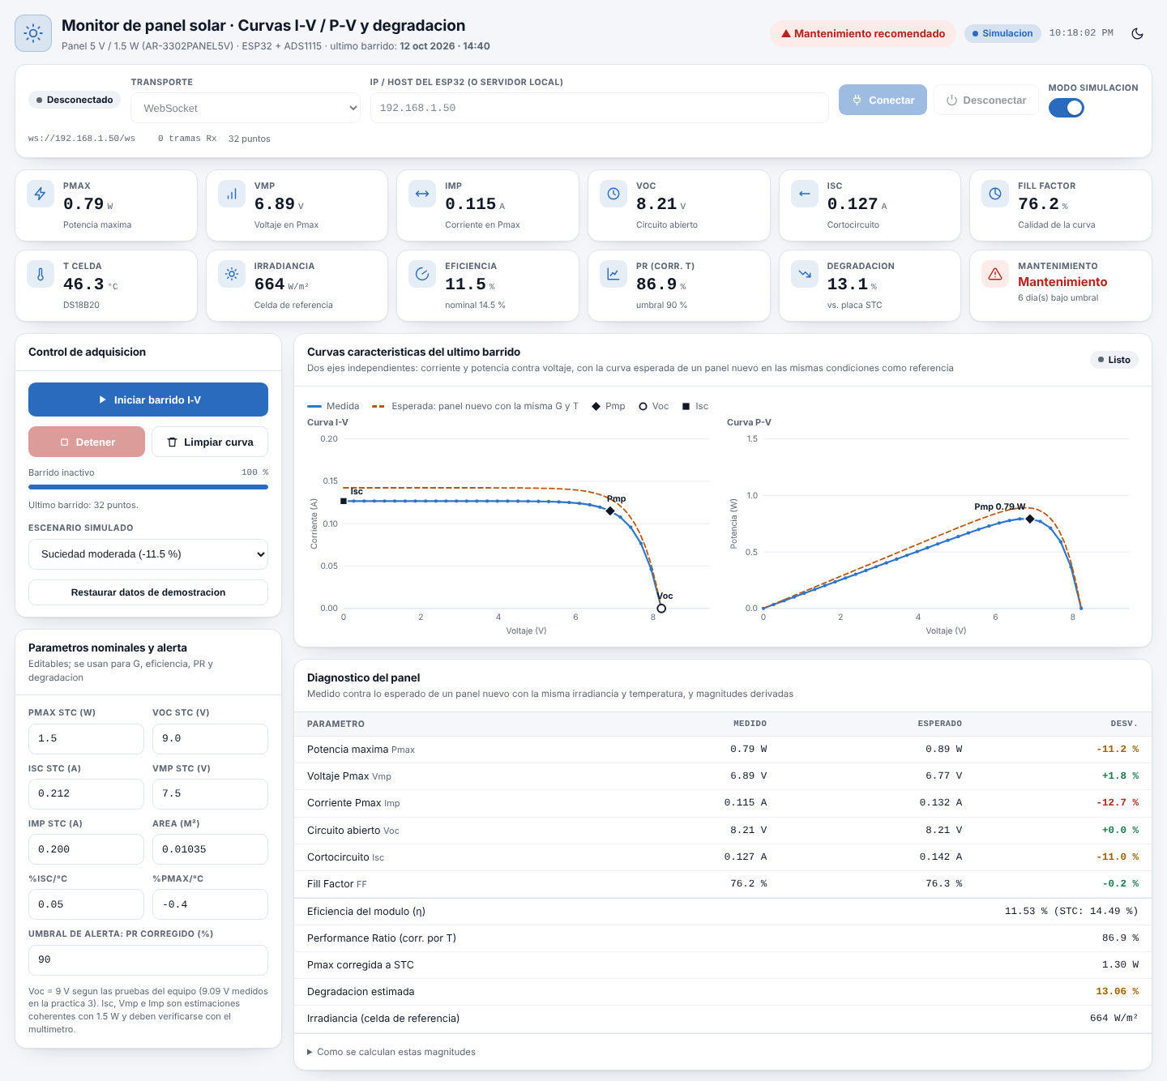
[picture p3: figure]

Fig. 5. Prototipo del dashboard, parte superior: estado de mantenimiento, magnitudes del último barrido, curvas I-V y P-V medidas frente a las esperadas, y diagnóstico del panel. Escenario de suciedad moderada con datos simulados.

supuesto) y la dependencia del diodo con la temperatura la
calcula ngspice con Eg de 15 celdas (16.8 eV); la corriente de saturación se recalibró (3.32 nA a 25 °C) para que Voc sea 9.0 V a 1 000 W/m² y 25 °C. Con ese modelo Pmax cae 0.40 %/°C y Voc unos 30 mV/°C, órdenes de magnitud típicos de un módulo de silicio cristalino, pero siguen siendo supuestos hasta medir el módulo. La Tabla 18 y la Fig. 8 resumen los resultados.
- Rangos. En todos los escenarios A0 queda entre 1.8 y 2.2 V (límite de 4.096 V) y la derivación entre 42 y 233 mV (límite de 0.512 V), es decir, las lecturas de V e I quedan dentro de rango y sin saturar; con 15 °C y 1 100 W/m²
(el caso extremo
del sitio) el máximo de A0 sería de unos 2.2 V.
- Irradiancia. La celda de referencia (A1, derivación de 1 Ω y escala de ±0.512 V) entrega 42 a 233 mV si se supone una celda con la misma Isc que el módulo, con un margen de 2.2 veces en el máximo y una resolución de 15.6 µV, equivalente a 0.07 W/m²
; el valor real depende de la celda que se adquiera y la relación G–tensión debe calibrarse con un piranómetro o con la hoja del fabricante.
- Temperatura. El sensor DS18B20 [16] cubre de −55 a 125 °C, con ±0.5 °C entre −10 y 85 °C, de modo que los 15 a 65 °C simulados quedan dentro de su rango y de su zona de mejor exactitud; con el coeficiente de −0.40 %/°C, un error de 0.5 °C equivale a 0.2 % en la potencia corregida.

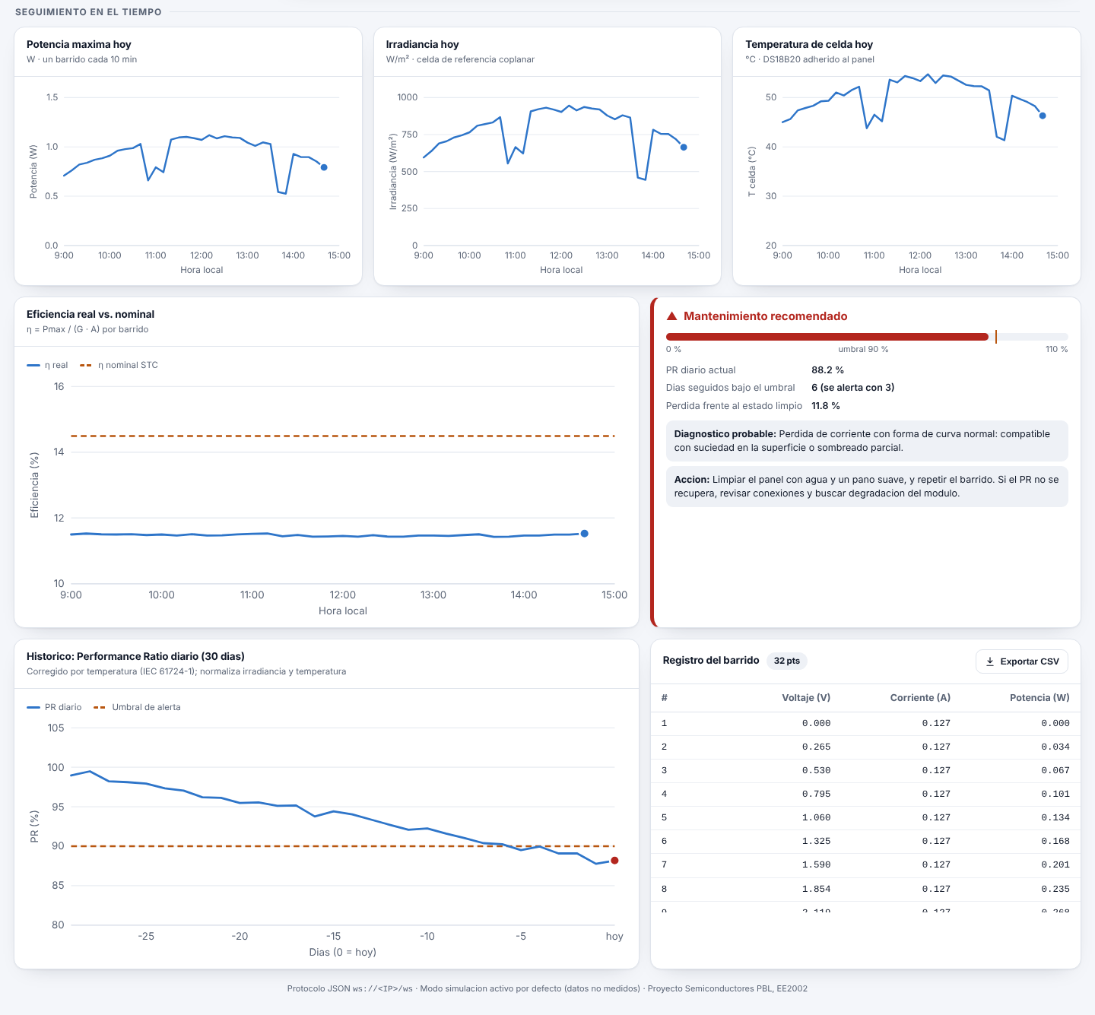
[picture p4: figure]

Fig. 6. Prototipo del dashboard, parte inferior: potencia, irradiancia y temperatura del día; eficiencia real contra nominal; alerta de mantenimiento; PR diario de 30 días con el umbral; y registro del barrido. Datos simulados.

- Contraste con la teoría. A 1 000 W/m²
la potencia del barrido
difiere de la teórica en −0.4 % (25 °C) y −0.3 a −0.6 % (15 a 65 °C), dentro de la incertidumbre esperada; la diferencia crece al bajar la irradiancia, hasta −5 % a 200 W/m²
, porque
los 23 puntos se eligieron para la curva de 1 000 W/m² y con poca luz el codo se desplaza y queda entre dos puntos.
E. Ajustes de diseño derivados de la simulación
- Con 400 W/m² o menos el error del barrido supera 1.5 %; el firmware debe refinar el barrido alrededor del máximo (agregar combinaciones de relés cercanas al punto de mayor potencia) o descartar esas mediciones para el índice de rendimiento. Se adopta lo segundo como regla por defecto: el índice solo se calcula con G ≥ 600 W/m²
- El error de −0.17 % por la carga de la entrada del ADS1115 se corrige con una calibración de la ganancia del divisor medida con el multímetro.
- La derivación de 1 Ω usa solo el 41 % de su escala a 1 000 W/m²
, por lo que se mantiene la escala de ±0.512 V; usar una derivación mayor mejoraría la resolución, pero la caída de 0.2 V sobre ella reduciría la potencia del módulo medida.
- Se mantiene el tiempo de espera de 200 ms por punto, y se agrega una lectura de A1 y de temperatura antes y después de cada barrido para descartar los barridos con irradiancia

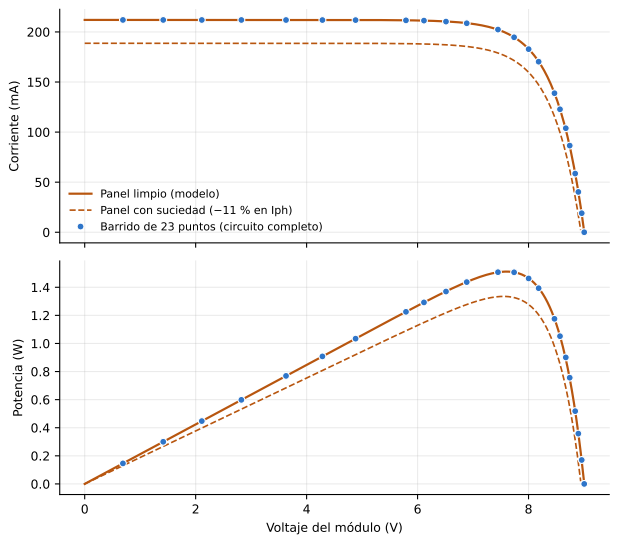
[picture p5: figure]
Corriente (mA); Panel limpio (modelo) Panel con suciedad (−11 % en Iph); Voltaje del módulo (V); Potencia (W)

Barrido de 23 puntos (circuito completo)

Fig. 7. Curvas I-V y P-V simuladas del módulo (línea continua: limpio; discontinua: con 11 % menos de fotocorriente) y los 23 puntos del barrido con el circuito completo (círculos).

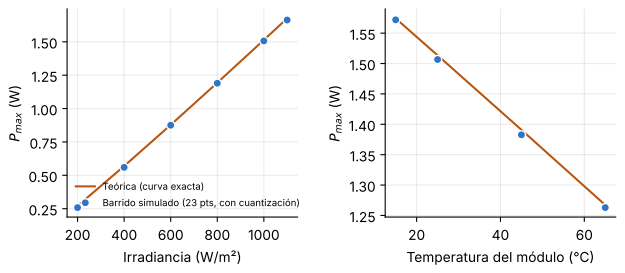
[picture p6: figure]
200 400 600 800 1000 Irradiancia (W/m²); max (W); Teórica (curva exacta); Temperatura del módulo (°C)

Barrido simulado (23 pts, con cuantización)

Fig. 8. Potencia máxima teórica (curva exacta del modelo) y obtenida con el barrido de 23 puntos tras la cuantización, en función de la irradiancia (izquierda, 25 °C) y de la temperatura (derecha, 1 000 W/m²
).

inestable.

F. Asentamiento
Al cerrar el relé de 22 Ω, A0 pasa de 2.090 a 1.134 V y se asienta a una cuenta (125 µV) en unos 6.7 ms (Fig. 9), coherente con la constante de unos 0.87 ms de la sección V. La espera de 200 ms de la secuencia de medición deja un margen de unas 30 veces; ese margen también cubre el rebote del contacto del relé, que la simulación no modela.
G. Alcance y límites
La simulación comprueba que las escalas son adecuadas, que el barrido de 23 puntos recorre toda la curva y que el circuito distingue una pérdida de corriente. No valida la curva real del módulo, el ruido, la activación de los relés con 3.3 V ni la comunicación I²C; esos puntos se cubrirán con las pruebas físicas, que sustituirán los parámetros del modelo del módulo (y los coeficientes de temperatura supuestos) por los medidos. Los archivos de la simulación (lista de conexiones, scripts y los 23 puntos) se entregan junto con este documento.

TABLA 18
ESCENARIOS SIMULADOS: TEORÍA (CURVA EXACTA DEL MODELO) FRENTE AL BARRIDO CON EL CIRCUITO COMPLETO Y LAS LECTURAS MÁXIMAS EN

LOS CANALES

G | T | Voc | Isc | Pteo | Pmed | Dif. A0 máx. Deriv. máx.
(W/m²
) (°C) | (V) (mA) | (W) | (W) (%) | (V) | (mV)
200 | 25 8.20 | 42 0.271 0.258 -4.7 | 1.90 | 42
400 | 25 8.54 | 85 0.569 0.559 -1.7 | 1.98 | 85
600 | 25 8.74 | 127 0.878 0.875 -0.3 | 2.03 | 127
800 | 25 8.89 | 170 1.193 1.190 -0.3 | 2.06 | 170
1000 | 25 9.00 | 212 1.513 1.507 -0.5 | 2.09 | 212
1100 | 25 9.05 | 233 1.675 1.663 -0.7 | 2.10 | 233
1000 | 15 9.30 | 211 1.574 1.572 -0.1 | 2.16 | 211
1000 | 45 8.40 | 214 1.391 1.383 -0.6 | 1.95 | 214

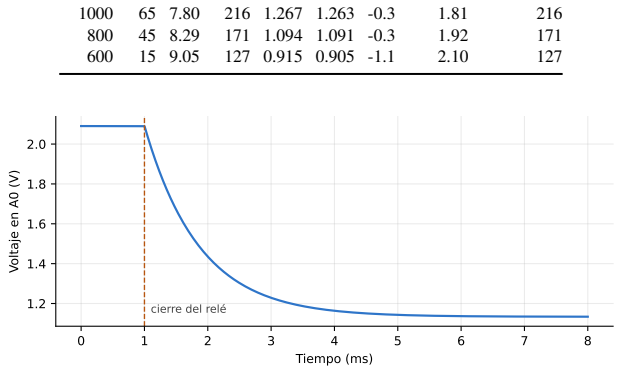
[picture p7: figure]
Tiempo (ms); Voltaje en A0 (V); cierre del relé

Fig. 9. Voltaje en A0 al cerrar el relé de 22 Ω (el panel pasa de circuito abierto a carga). El valor final es 1.134 V.

X. LIMITACIONES Y AJUSTES PENDIENTES
- Voltaje de circuito abierto. El diseño usa 9 V según las pruebas del equipo. En la práctica 3 se midieron 9.09 V con una carga de 220 Ω (relación V/I de 223 Ω), de modo que el valor real es igual o mayor, y se tomó 11 V como máximo de diseño. No se encontró una hoja de datos del módulo AR-3302PANEL5V [20]; un panel análogo de 1.5 W declara 8.2 V y hasta 10 V a pleno sol [21]. Queda pendiente medir el voltaje de circuito abierto y la corriente de cortocircuito con multímetro al sol. Los valores de Isc (0.212 A), Vmp (7.5 V) e Imp (0.200 A) del dashboard son estimaciones coherentes con 1.5 W y difieren de los supuestos del primer avance (Isc de 315 a 330 mA); se corregirán con la medición.
- Práctica 3. Se midió con cielo nublado, con V e I en tandas distintas y sin temperatura; sus datos orientan los rangos pero no representan sol pleno.
- Simulación de montaje. Es de cielo despejado, con seguidores ideales y sin consumo del actuador; con nubosidad la ganancia de un seguidor es menor, lo que refuerza la decisión adoptada.
- Consumo. Los valores de los relés (71 mA y 5 mA por canal) y del ESP32 (130 mA) son supuestos de diseño; se medirán con el montaje real, y se probará el apagado automático de la batería.
- Parámetros del barrido. Los 23 puntos propuestos por la simulación (sección IX), el intervalo de 5 s y el umbral ρmax se validarán con el módulo real.
- Wi-Fi. El alcance, la estabilidad de la conexión y el efecto de la transmisión sobre las lecturas del ADS1115 no se han medido; se verificarán comparando lecturas con el Wi-Fi activo e inactivo. El consumo de 130 mA es un valor de diseño.
- Ajustes pendientes del esquemático. La hoja ya incluye la alimentación (J5, C4), las resistencias de subida del bus I²C (R6 y R7), el modelo del módulo y la derivación R_sh2 de 1 Ω. Quedan por confirmar con el hardware: que las entradas ópticas del módulo de relés se activen con 3.3 V (si no, se usará un transistor por canal), el modelo exacto del relé del módulo, y si el módulo ADS1115 adquirido ya trae resistencias de subida (en ese caso se retiran R6 y R7). Se dibuja un solo filtro RC (R3 y C1) en el canal de voltaje, y los capacitores C2 y C3 son de desacople.
- Dashboard. Funciona con datos simulados y aún no está conectado al servidor local. El umbral de 90 %, la regla de tres días y el filtro de 200 W/m²
son valores iniciales, que se calibrarán con la línea base del módulo limpio.
- Simulación del circuito. Los relés se modelan como interruptores ideales con 50 mΩ de resistencia y sin rebote, y la entrada del ADS1115 como 5 MΩ (supuesto). Los parámetros del módulo (0.212 A, 9 V, diodo con N = 19.5) y los coeficientes de temperatura (0.05 %/°C en Isc, −0.4 %/°C en la potencia) son estimaciones, no mediciones, y se sustituirán con las pruebas físicas. Con menos de 600 W/m² el barrido de 23 puntos, calculado para 1 000 W/m²
| , pierde
precisión (hasta −5 % a 200 W/m²
| ), por lo que el índice solo
usa barridos de 600 W/m² o más, o se refina el barrido en el firmware.
- Montaje. La inclinación y la orientación se verificarán en sitio con nivel y brújula.

REFERENCIAS

[1] J. Garcilazo, D. Salguero y A. Cortez, «Sistema de monitoreo electrónico y modelo predictivo de mantenimiento de un panel solar: primer avance», Semiconductores, 15 de septiembre de 2026.
[2] W. D. Lubitz, «Effect of manual tilt adjustments on incident irradiance on fixed and tracking solar panels», Applied Energy, vol. 88, n.º 5, pp. 1710–1719, 2011.
[3] A. Bahrami, C. O. Okoye y U. Atikol, «The effect of latitude on the performance of different solar trackers in Europe and Africa», Applied Energy, vol. 177, pp. 896–906, 2016. DOI: 10.1016/j.apenergy.2016.05.103.
[4] F. Ordóñez, J. López-Villada, S. Vaca y C. Morales, «Assessment of the energy gain of photovoltaic systems by using solar tracking in equatorial regions», 2018. [En línea]. Disponible: https://redi.cedia.edu.ec/document/60717
[5] G. Serrano Cabarcas, «Análisis del efecto de la aplicación de seguidores solares de uno y dos ejes en sistemas fotovoltaicos dentro de la zona tórrida latinoamericana», Generación Creativa, vol. 5, n.º 5, pp. 168–171, oct. 2016.
[6] A. Mermoud y B. Wittmer, «Simulation of tracking PV installations with PVsyst», 9th PV Performance Modeling and Monitoring Workshop (PVPMC), Weihai, China, 2017.
[7] T. Demirdelen, H. Alici, B. Esenboga y M. Guldurek, «Performance and economic analysis of designed different solar tracking systems for Mediterranean climate», Energies, vol. 16, n.º 10, 2023.
[8] A. Kibar et al., «Comparative performance analysis for solar tracking systems in mid-latitude climates: Insights from a one-year experimental study», Proc. Inst. Mech. Eng. C J. Mech. Eng. Sci., 2026. DOI: 10.1177/09544062261470274.
[9] SwitchDoc Labs, «Sun tracking for solar power – Part 3 – The results», 2016. [En línea]. Disponible: https://www.switchdoc.com/2016/05/sun-tracking-solar-power-part-3-results/
[10] W. F. Holmgren, C. W. Hansen y M. A. Mikofski, «pvlib python: A python package for modeling solar energy systems», J. Open Source Softw., vol. 3, n.º 29, art. 884, 2018.
[11] P. Ineichen y R. Perez, «A new airmass independent formulation for the Linke turbidity coefficient», Solar Energy, vol. 73, n.º 3, pp. 151–157, 2002.
[12] J. E. Hay y J. A. Davies, «Calculation of the solar radiation incident on an inclined surface», en Proc. First Canadian Solar Radiation Data Workshop, 1980, pp. 59–72.
[13] J. Garcilazo, D. Salguero y A. Cortez, «Influencia del ángulo de inclinación y la orientación de un panel solar en la producción de energía», Práctica de laboratorio 3, Semiconductores, oct. 2026.
[14] Hubble, | «ESP32 power consumption: | Datasheet vs.
reality», guía de la comunidad. [En línea]. Disponible: https://hubble.com/community/guides/esp32-power-consumption-datasheet-vs-reality/
[15] Texas Instruments, «ADS1113, ADS1114, ADS1115: Ultra-small, low-power, 16-bit analog-to-digital converter with internal reference», hoja de datos SBAS444.
[16] Analog Devices (Maxim Integrated), «DS18B20: Programmable resolution 1-Wire digital thermometer», hoja de datos 19-7487.
[17] P. L. O. Machado et al., «A low-cost Arduino-based I–V curve tracer with automated load switching for PV panel characterization», Applied Sciences, vol. 15, n.º 15, art. 8186, 2025. DOI: 10.3390/app15158186.
[18] I. Romero-Fiances et al., «Impact of duration and missing data on the long-term photovoltaic degradation rate estimation», Renewable Energy, vol. 181, pp. 738–748, 2022. DOI: 10.1016/j.renene.2021.09.078.
[19] Docente de la asignatura, «Guía de trabajo — Persona B: Electrónica de adquisición de datos», Semiconductores EE2002, 14 de agosto de 2026.
[20] Casa Rivas, S.A. de C.V., etiqueta de producto AR-3302PANEL5V, código interno 32436.
[21] Seeed | Studio, | «1.5W | Solar | Panel | 81X137», | hoja
de | datos, | SKU | 313070002. | [En | línea]. | Disponible:
https://cdn.eicom.ru/media/PDF/5095340.pdf

[22] Espressif Systems, «ESP32-WROOM-32 datasheet». [En línea]. Disponible: https://www.espressif.com/sites/default/files/documentation/esp32-wroom-32_datasheet_en.pdf (https://www.espressif.com/sites/default/files/documentation/esp32-wroom-32_datasheet_en.pdf)
[23] Microchip | Technology, | «ATmega328P: | 8-bit | AVR
microcontroller», hoja de datos.
[24] Raspberry Pi Ltd, «Raspberry Pi Pico W datasheet».
[25] Microchip Technology, «MCP3004/3008: 2.7 V 4-channel/8-channel 10-bit A/D converters with SPI serial interface», hoja de datos.
[26] Ningbo Songle Relay, «SRD-05VDC-SL-C: relé de potencia, bobina de 5 V (70 Ω, 360 mW)», hoja de datos. [En línea]. Disponible: https://www.lcsc.com/datasheet/C35449. pdf (https://www.lcsc.com/datasheet/C35449.pdf)

# J1 Panel_prueba GND

# SCL 10 U2

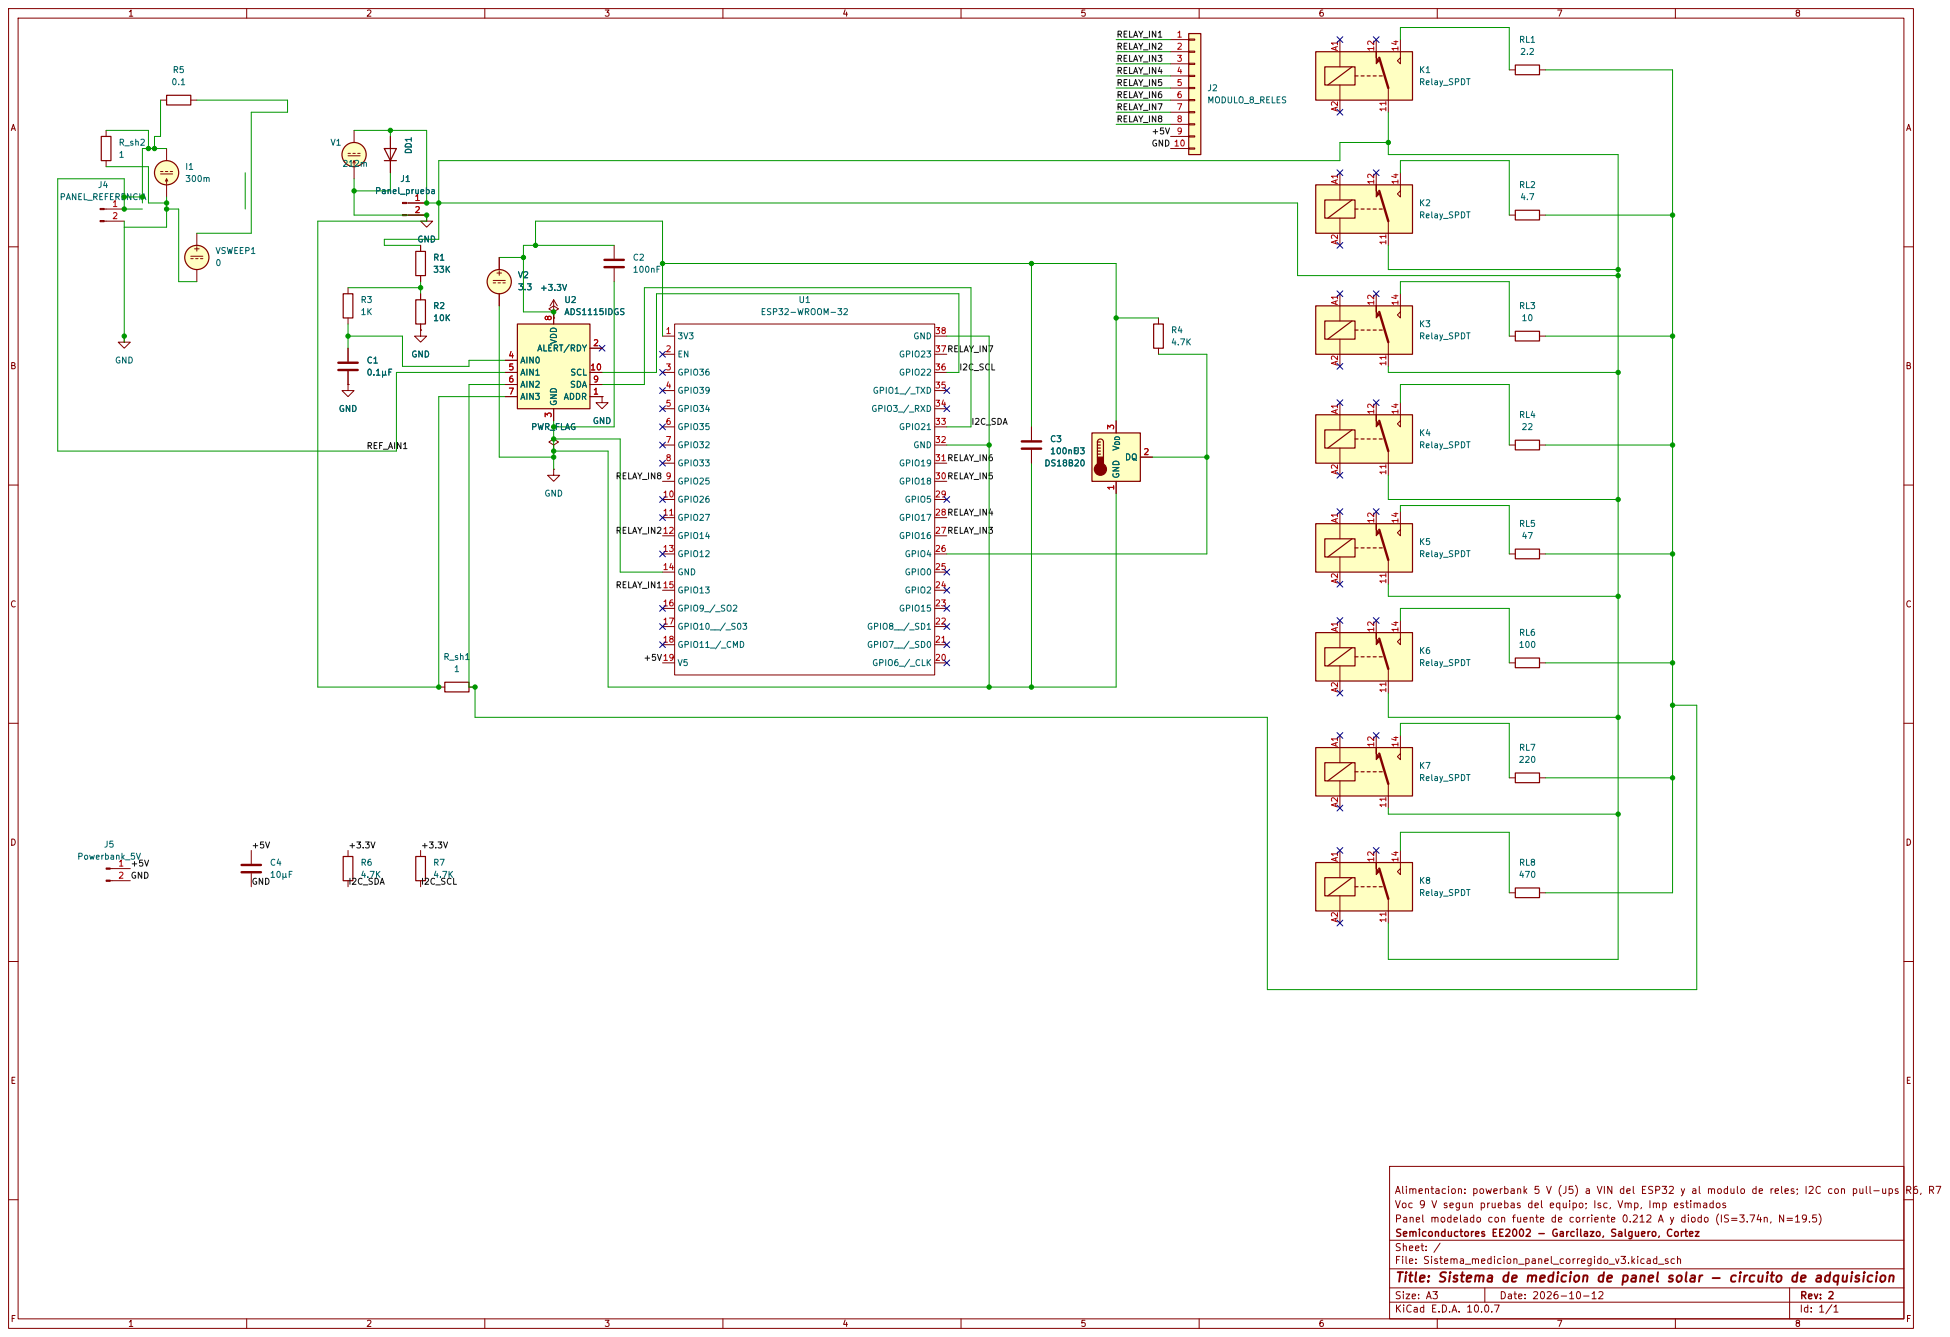
[picture p8: page 18]

Alimentacion: powerbank 5 V (J5) a VIN del ESP32 y al modulo de reles; I2C con pull-ups R6, R7
Voc 9 V segun pruebas del equipo; Isc, Vmp, Imp estimados
Panel modelado con fuente de corriente 0.212 A y diodo (IS=3.74n, N=19.5)
Semiconductores EE2002 - Garcilazo, Salguero, Cortez
Sheet: /
File: Sistema_medicion_panel_corregido_v3.kicad_sch
Title: Sistema de medicion de panel solar - circuito de adquisicion
KiCad E.D.A. 10.0.7
