Joshua203-byte/Pcb/Simulacion/fig_sim_esc.pdf

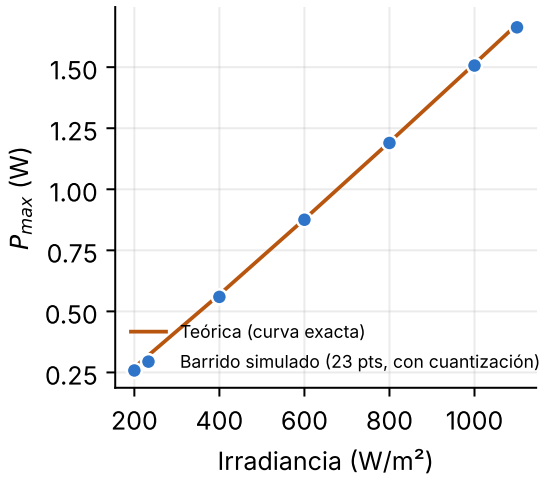
[picture p12: figure]
200 400 600 800 1000 Irradiancia (W/m²); max (W); Teórica (curva exacta)
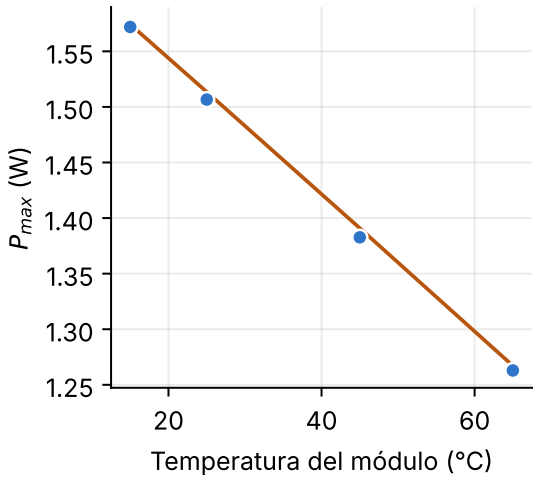
[picture p13: figure]
Temperatura del módulo (°C); max (W)

Barrido simulado (23 pts, con cuantización)
