Joshua203-byte/Pcb/Simulacion/fig_sim_tr.pdf

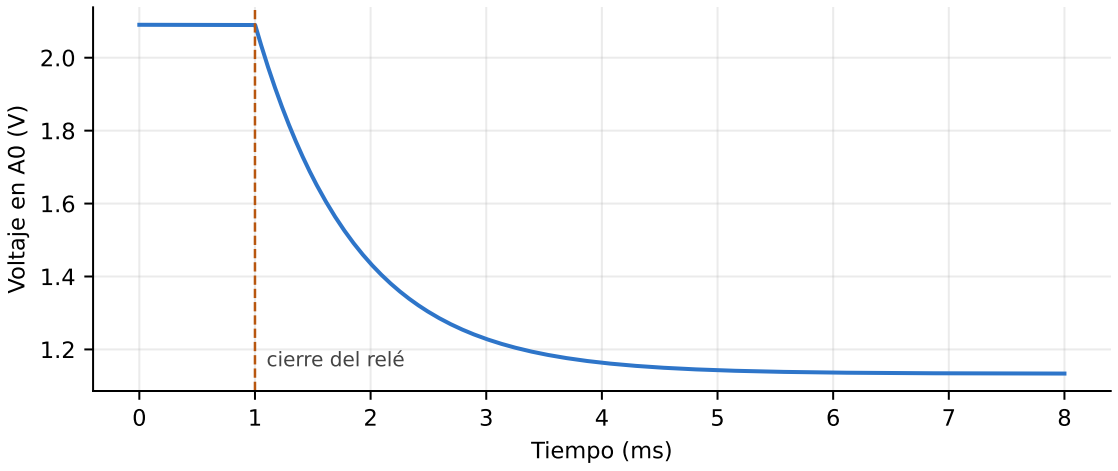
[picture p14: figure]
Tiempo (ms); Voltaje en A0 (V); cierre del relé
