Joshua203-byte/Pcb/Guia_Herramientas_Busqueda_Cientifica.pdf

# GUÍA DE HERRAMIENTAS

## para la búsqueda de artículos y papers científicos

## 1. Introducción

Esta guía reúne las principales herramientas para buscar, filtrar y comprender artículos científicos (papers). El objetivo es que puedas elegir la herramienta correcta según tu necesidad: encontrar bibliografía confiable, revisar el estado del arte de un tema, o comprender rápidamente un artículo técnico.
Las herramientas se organizan en cuatro categorías:
- Bases de datos y buscadores académicos generales
- Bases de datos especializadas / por suscripción institucional
- Asistentes de búsqueda con inteligencia artificial
- Repositorios de acceso abierto y gestores de referencias

## 2. Buscadores académicos generales

Punto de partida recomendado para cualquier búsqueda: son gratuitos, amplios y fáciles de usar.

Herramienta | Tipo | Cobertura / enfoque | Para qué usarla
Google Scholar | Buscador general de literatura académica | Multidisciplinario, incluye citas, patentes y tesis | Primera búsqueda exploratoria; ver quién cita un artículo
Semantic Scholar | Buscador académico con IA (Allen Institute) | Ciencias, con mapas de citación e influencia | Ver relación entre papers y resúmenes generados por IA
BASE (Bielefeld) | Motor de búsqueda de acceso abierto | Más de 300 millones de documentos, multidisciplinario | Encontrar versiones de acceso abierto de un artículo

## 3. Bases de datos especializadas (suscripción institucional)

Suelen requerir acceso mediante la universidad (usuario institucional, VPN o proxy). Ofrecen mayor rigor editorial y métricas de impacto.

Herramienta | Tipo | Cobertura / enfoque | Para qué usarla
IEEE Xplore | Base de datos técnica | Ingeniería eléctrica, electrónica, informática, telecomunicaciones | Buscar papers, estándares y actas de conferencias IEEE

Herramienta | Tipo | Cobertura / enfoque | Para qué usarla
Scopus | Base de datos y de citas (Elsevier) | Multidisciplinario, con métricas de autor y revista | Análisis bibliométrico y revisiones sistemáticas
Web of Science | Base de datos y de citas (Clarivate) | Ciencias, ciencias sociales y humanidades | Índice de citas de alto prestigio académico
ScienceDirect | Editorial (Elsevier) | Ciencia, tecnología y medicina | Acceso a revistas y libros de Elsevier
SpringerLink | Editorial (Springer) | Multidisciplinario | Acceso a revistas, libros y capítulos Springer
ACM Digital Library | Base de datos técnica | Ciencias de la computación | Papers de conferencias y revistas de ACM

Consejo: si tu universidad tiene convenio con alguna de estas plataformas, ingresa desde la biblioteca virtual institucional para tener acceso al texto completo sin costo.

## 4. Asistentes de búsqueda con inteligencia artificial

Estas herramientas usan IA para resumir, explicar y encontrar papers relevantes a partir de preguntas en lenguaje natural. Son un excelente complemento, no un sustituto, de las bases de datos anteriores.

Herramienta | Tipo | Cobertura / enfoque | Para qué usarla
SciSpace (typeset.io) | Asistente de IA para investigación | Más de 280 millones de papers | Chatear con un PDF, generar revisiones de literatura y citas
Consensus | Buscador de IA basado en evidencia | Extrae hallazgos de estudios revisados por pares | Responder preguntas de investigación con evidencia citada
Elicit | Asistente de investigación con IA | Extracción y comparación de datos entre papers | Automatizar parte de una revisión sistemática
Connected Papers | Visualización de relaciones entre papers | Mapas visuales de similitud y citación | Explorar visualmente el árbol bibliográfico de un tema
Scite.ai | Análisis de citas con IA | Indica si una cita apoya, contradice o menciona un estudio | Evaluar la solidez de la evidencia de un artículo

## 5. Repositorios de acceso abierto y gestores de referencias

Herramienta | Tipo | Cobertura / enfoque | Para qué usarla
arXiv | Repositorio de preprints | Física, matemáticas, ciencias de la computación, IA | Artículos recientes aún no publicados formalmente
DOAJ | Directorio de revistas de acceso abierto | Multidisciplinario, revistas revisadas por pares | Verificar si una revista es de acceso abierto legítimo
CORE | Agregador de acceso abierto | Más de 200 millones de documentos | Buscar copias gratuitas de artículos de pago
Zotero / Mendeley | Gestores de referencias bibliográficas | Organización y citación (APA, IEEE, etc.) | Guardar, organizar y citar automáticamente las fuentes

## 6. Cómo elegir la herramienta adecuada

Según la etapa de tu investigación
- Exploración inicial de un tema → Google Scholar, Semantic Scholar o Consensus
- Búsqueda técnica especializada (ingeniería/computación) → IEEE Xplore o ACM Digital Library
- Comprender un artículo difícil → SciSpace (chat con el PDF) o Scholarcy
- Revisión sistemática o comparación de estudios → Elicit, Scopus o Web of Science
- No tienes acceso institucional → BASE, CORE, DOAJ o arXiv (versiones abiertas)
- Organizar y citar tus fuentes → Zotero o Mendeley desde el inicio del trabajo

Buenas prácticas de búsqueda
- Usa palabras clave en inglés además de español: amplía muchísimo los resultados en la mayoría de las bases de datos.
- Combina términos con operadores booleanos (AND, OR, "comillas para frases exactas").
- Filtra por año de publicación para priorizar literatura reciente, salvo que busques un trabajo clásico o fundacional.
- Revisa quién cita al artículo ("cited by") para encontrar investigaciones más recientes sobre el mismo tema.
- Verifica siempre que la revista o conferencia sea revisada por pares (peer-reviewed).

## 7. Uso responsable de la IA en la búsqueda de papers

Las herramientas de IA (SciSpace, Consensus, Elicit, etc.) aceleran la búsqueda, pero pueden cometer errores o generar resúmenes imprecisos. Recomendaciones:

- Verifica siempre la cita original: lee al menos el resumen (abstract) del paper real antes de citarlo en tu trabajo.
- No cites un resumen generado por IA como si fuera el texto original del autor.
- Confirma la referencia bibliográfica completa (autores, año, revista, DOI) en la fuente original o en Google Scholar.
- Consulta el reglamento de tu institución sobre el uso de IA en trabajos académicos.

## 8. Enlaces directos

- Google Scholar (https://scholar.google.com/)
- Semantic Scholar (https://www.semanticscholar.org/)
- IEEE Xplore (https://ieeexplore.ieee.org/)
- Scopus (https://www.scopus.com/)
- Web of Science (https://www.webofscience.com/)
- SciSpace (typeset.io)
- Consensus (https://consensus.app/)
- Elicit (https://elicit.com/)
- Connected Papers (https://www.connectedpapers.com/)
- arXiv (https://arxiv.org/)
- CORE (https://core.ac.uk/)
- DOAJ (https://doaj.org/)
- Zotero (https://www.zotero.org/)
