Joshua203-byte/Pcb/Dashboard_captura.png

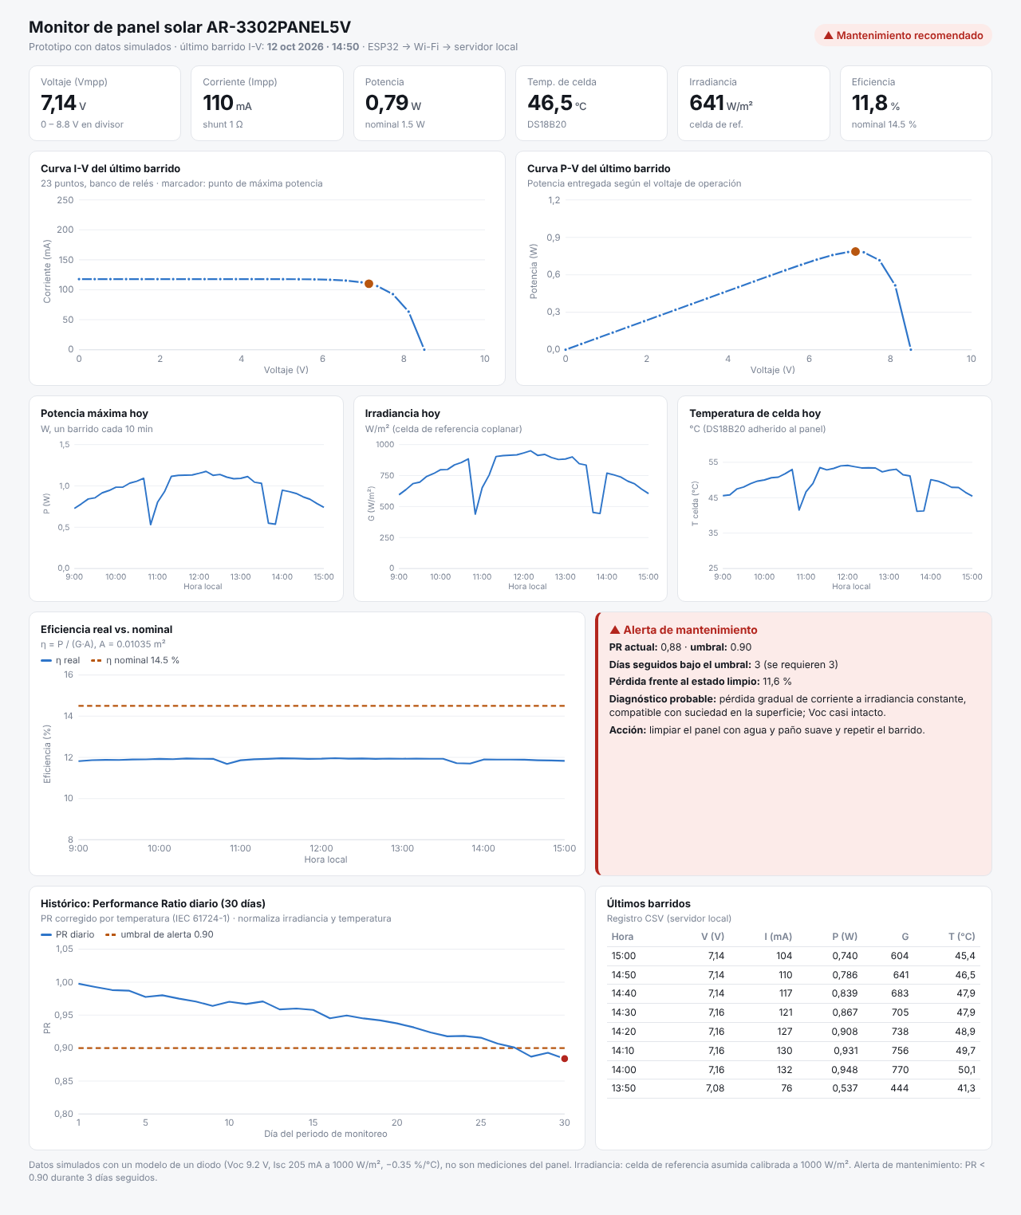
Dashboard_captura.png
