Joshua203-byte/Pcb/Dashboard_v2_captura_claro.png

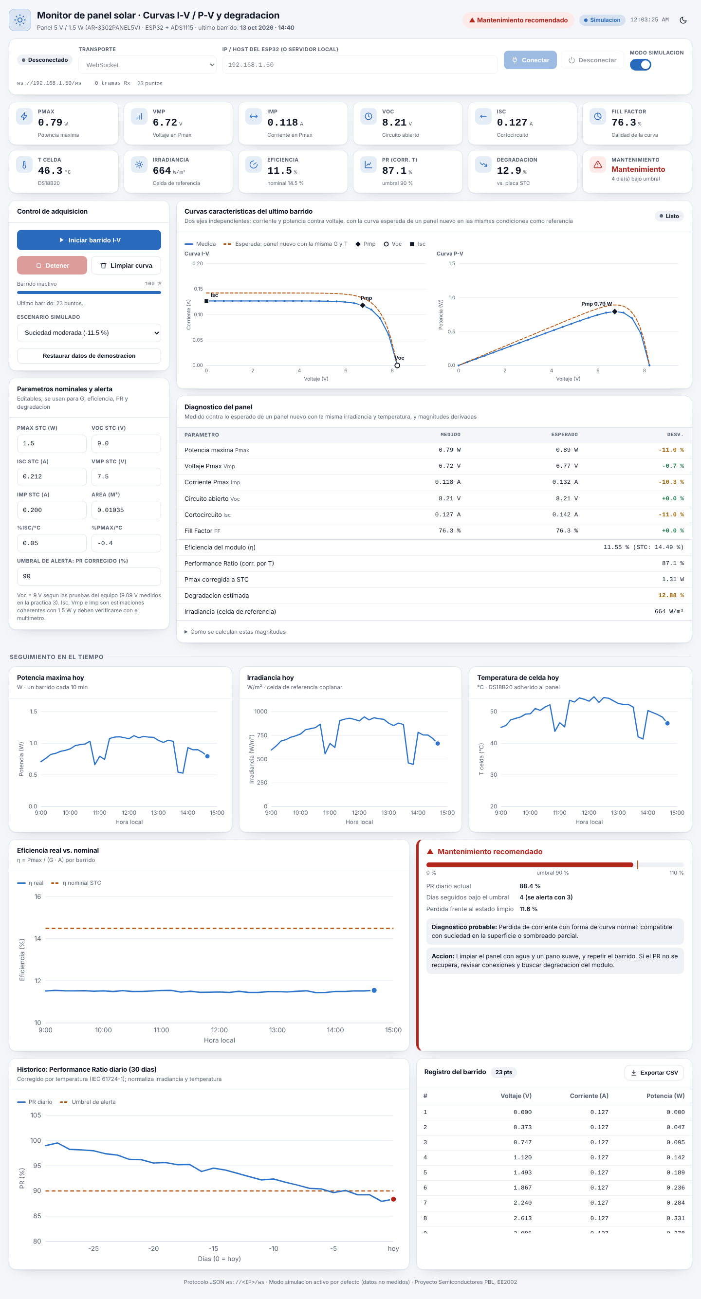
Dashboard_v2_captura_claro.png
