Joshua203-byte/Pcb/Dashboard_v2_captura_oscuro.png

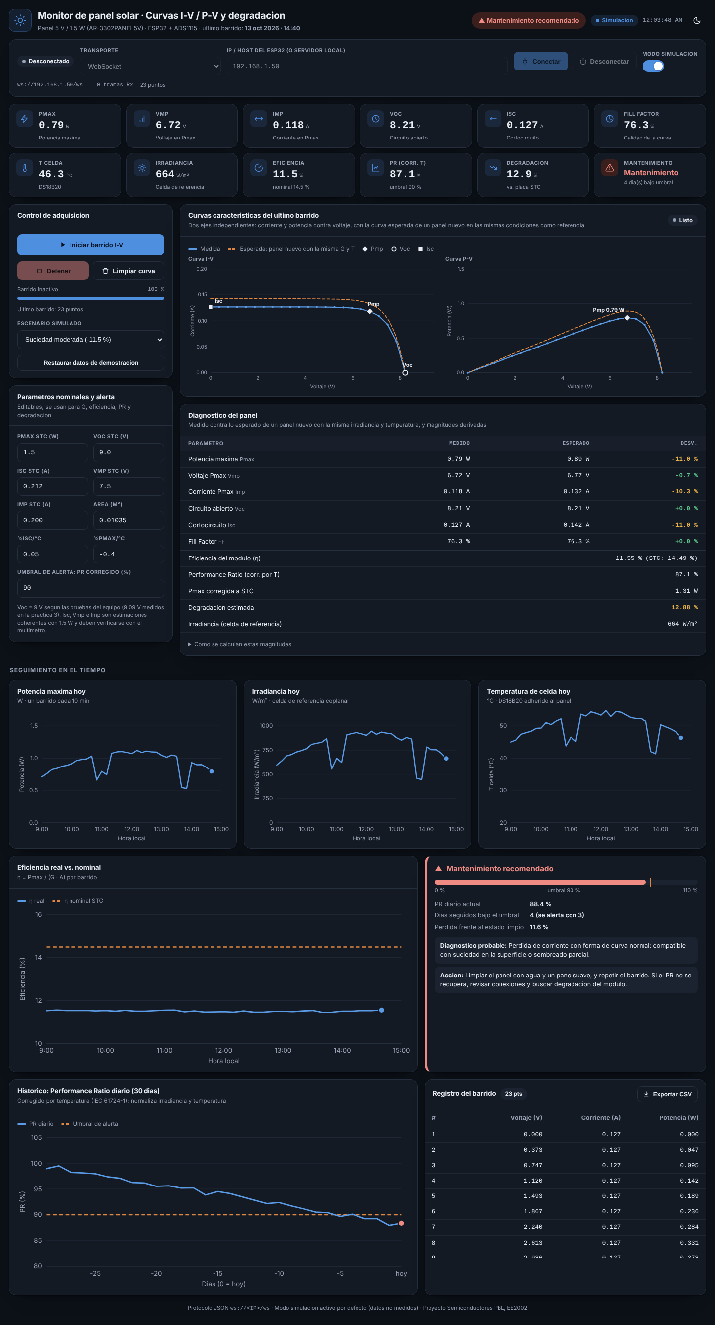
Dashboard_v2_captura_oscuro.png
