Joshua203-byte/Pcb/PCB_ESP32_v4_vista.png

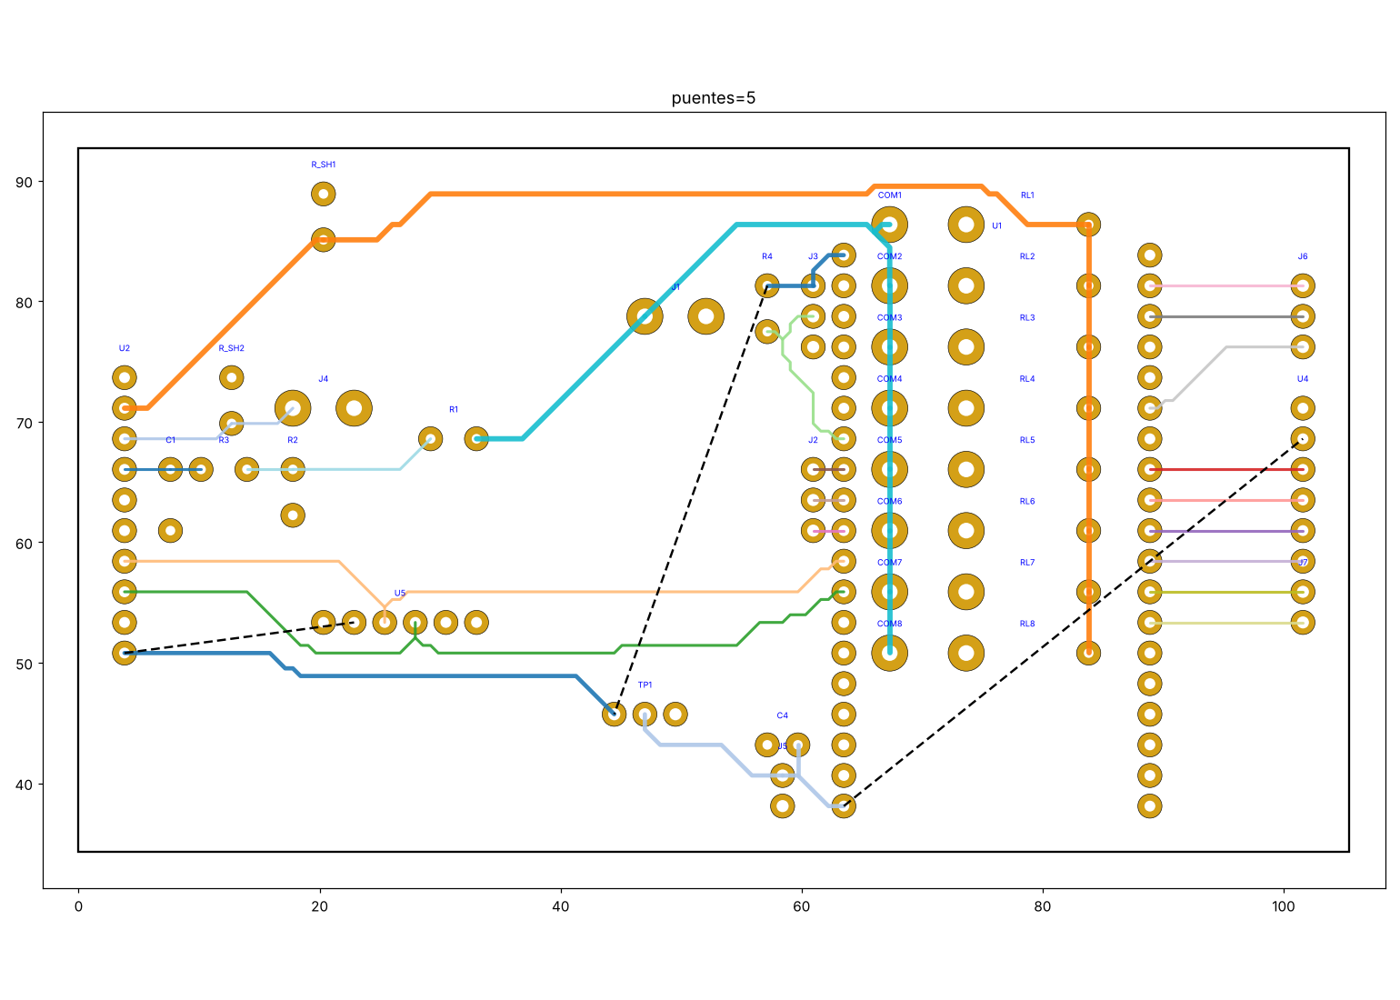
PCB_ESP32_v4_vista.png
