Joshua203-byte/Pcb/PCB_ESP32_v12_vista.png

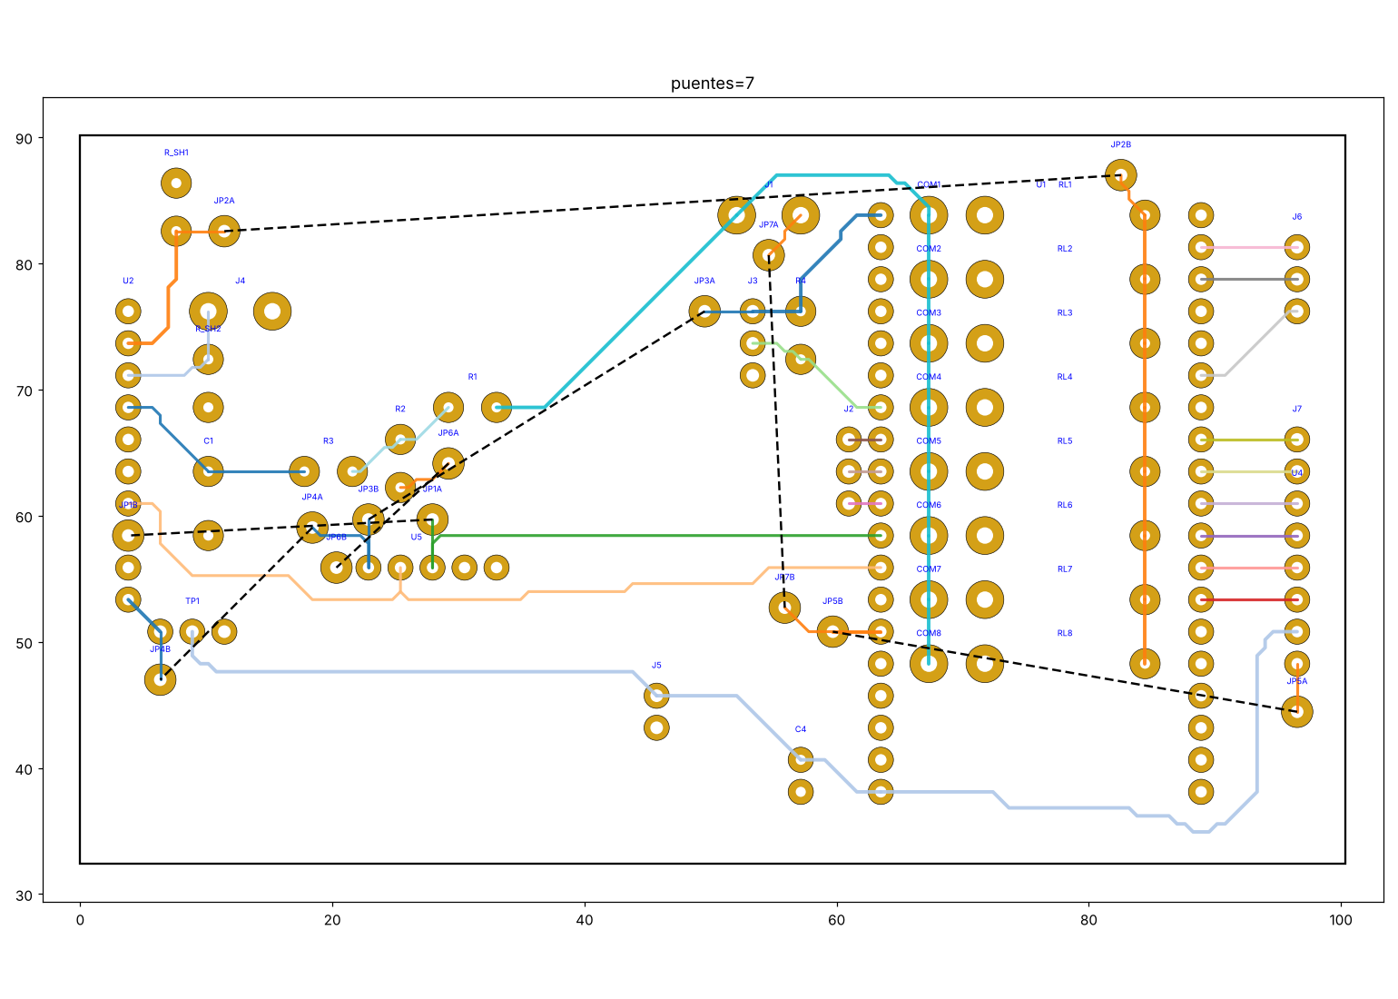
PCB_ESP32_v12_vista.png
