Joshua203-byte/Pcb/PCB_ESP32_v13_vista.png

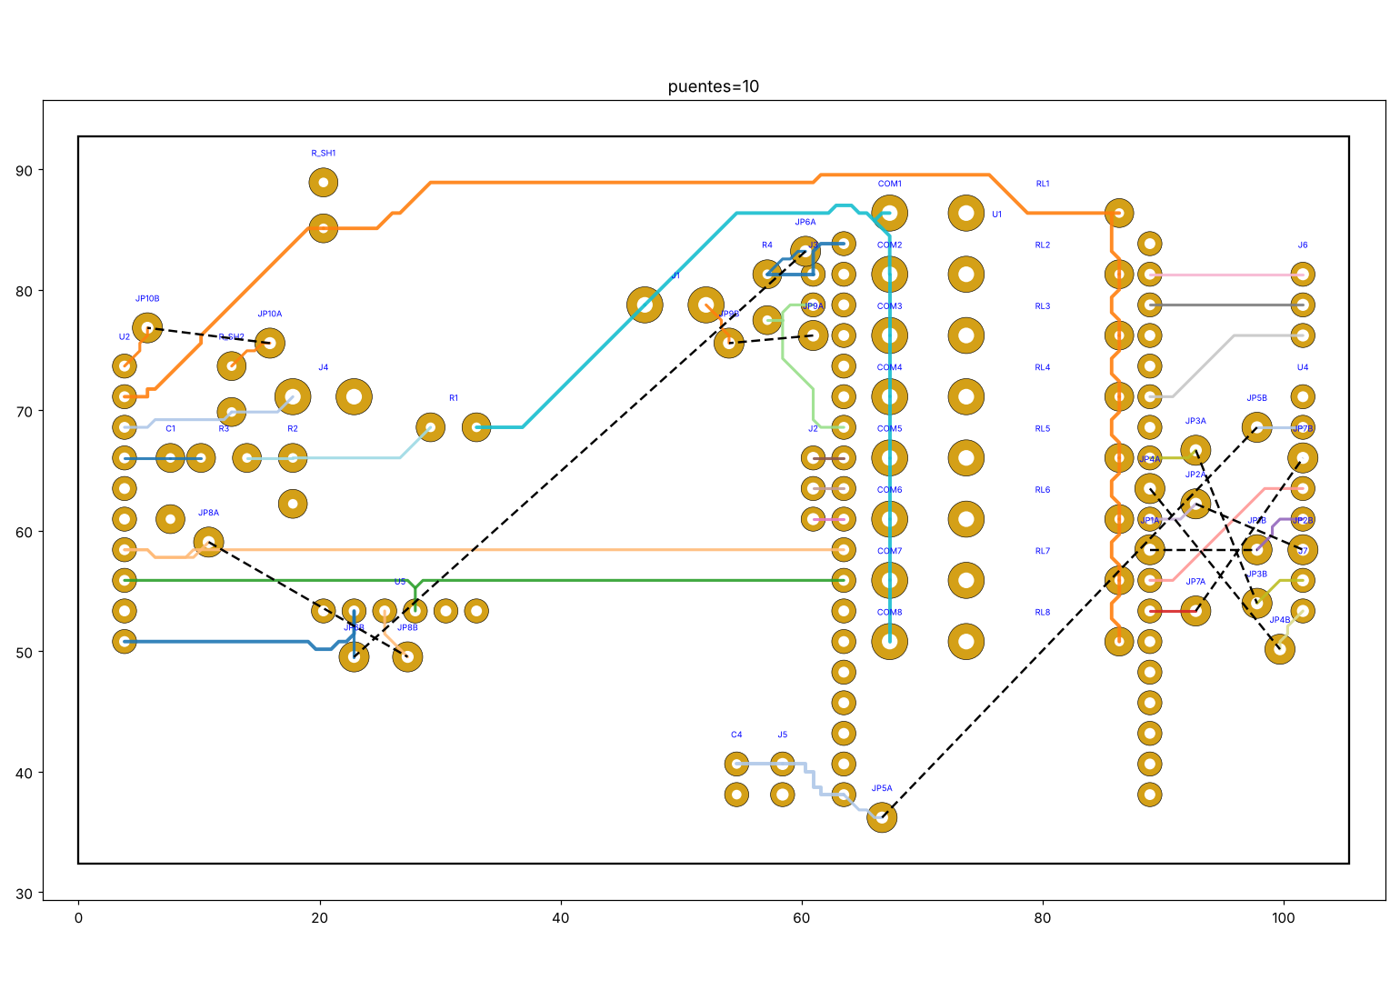
PCB_ESP32_v13_vista.png
