Joshua203-byte/Pcb/PCB_ESP32_v19_paquete/PCB_ESP32_v19_vista.png

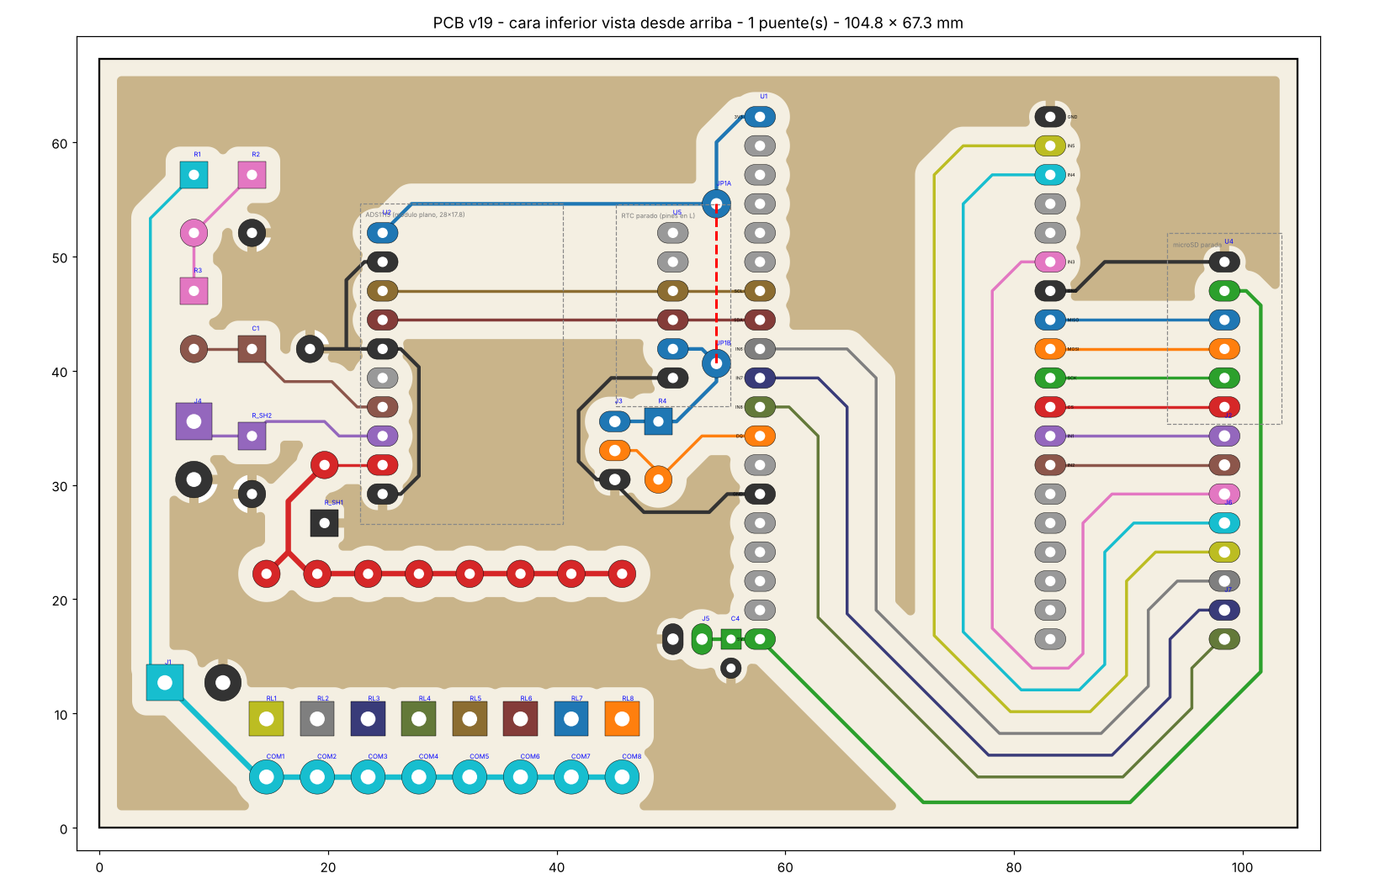
PCB_ESP32_v19_paquete/PCB_ESP32_v19_vista.png
