Joshua203-byte/Pcb/Plan_Accion_Panel_Solar.xlsx

Sheet: Gantt
SISTEMA DE MONITOREO Y MODELO PREDICTIVO DE MANTENIMIENTO DE PANEL SOLAR
Equipo: Joshua Garcilazo · Iván Salguero · Alfredo Cortez | Docente: Karen Pimentel | Curso: Semiconductores
# | Actividad | Responsable | Entregable / Hito | S1 10-14 ago | S2 17-21 ago | S3 24-28 ago | S4 1-4 sep | S5 7-11 sep | S6 14-18 sep | S7 21-25 sep | S8 28 sep-2 oct | S9 5-9 oct | S10 12-16 oct | S11 19-23 oct | S12 26-30 oct
Leyenda: |  | Conjunto (todos) | Alfredo | Joshua | Iván | Completado ✓ | Planificado | Hito ★
FASE 1-2 — INVESTIGACIÓN Y DISEÑO (Semanas 1-6) ✓ COMPLETADAS
1 | Conocer el PBL; redactar párrafo de causas de degradación | Conjunto | Párrafo causas de degradación | ✓
2 | Redacción del estado del arte del proyecto | Conjunto | Estado del arte (borrador) | ✓ | ✓
3 | Entrega Avance 1: párrafo + estado del arte | Iván | 📎 Avance 1 enviado |  | ★
4 | Investigación: materiales, variables y sensores del modelo predictivo | Conjunto | Lista de variables y sensores |  |  | ✓
5 | Investigación: arquitectura de adquisición (ESP32, ADS1115, etc.) | Conjunto | Documento de arquitectura |  |  |  | ✓
6 | Entrega Avance 2 (redacción conjunta) | Iván | 📎 Avance 2 enviado |  |  |  |  | ★
7 | Diseño del circuito de adquisición (Fase 3 — presentación hoy) | Conjunto | 📎 Presentación Fase 3 entregada |  |  |  |  |  | ★
FASE 3 — CONSTRUCCIÓN DEL PROTOTIPO (Semanas 7-12)
8 | Adquisición de componentes (Casa Rivas / Steren) | Joshua | Componentes en mano (lista OK) |  |  |  |  |  |  | ▓
9 | Montaje inicial en protoboard: ESP32 + ADS1115 + DS18B20 | Alfredo | Protoboard con conexiones básicas |  |  |  |  |  |  | ▓
10 | Prueba de comunicación I²C (ESP32 ↔ ADS1115) y 1-Wire (DS18B20) | Alfredo | Lectura de datos por Serial OK |  |  |  |  |  |  | ▓
11 | Ensamblar banco de 8 resistencias + relés optoacoplados | Joshua | Banco de carga funcional |  |  |  |  |  |  |  | ▓
12 | Integrar banco de carga con ESP32 (control GPIO) | Iván | Ciclo de conmutación verificado |  |  |  |  |  |  |  | ▓
13 | Firmware v1: barrido I-V básico (256 combinaciones) | Alfredo | Script Python recibe datos por USB |  |  |  |  |  |  |  | ▓
14 | Montar celda de referencia (módulo en cortocircuito) | Joshua | Isc_ref legible en ADS1115 |  |  |  |  |  |  |  |  | ▓
15 | Calibrar divisor resistivo 33kΩ/10kΩ para Voc | Iván | Error < 1% vs. multímetro |  |  |  |  |  |  |  |  | ▓
16 | Caracterización experimental Voc, Isc, coef. térmicos del módulo | Conjunto | Tabla de parámetros del módulo |  |  |  |  |  |  |  |  | ▓
17 | Firmware v2: corrección térmica P25 y cálculo de η | Alfredo | Fórmulas implementadas y testeadas |  |  |  |  |  |  |  |  |  | ▓
18 | Validación hipótesis: ensuciamiento vs. resistencia serie (ΔIsc vs. ΔVoc) | Conjunto | Gráfica I-V comparativa OK |  |  |  |  |  |  |  |  |  | ▓
19 | Prueba de ciclo de duty del 4% (pulsado 200 ms) | Iván | Sin autocalentamiento confirmado |  |  |  |  |  |  |  |  |  | ▓
20 | Montaje final (no protoboard): soldadura y cableado permanente | Joshua | PCB/placa limpia y documentada |  |  |  |  |  |  |  |  |  |  | ▓
21 | Firmware v3 final: PR(t) según IEC 61724-1 | Alfredo | Índice de rendimiento calculado |  |  |  |  |  |  |  |  |  |  | ▓
22 | Prueba de estrés: 6 h continuas de adquisición de datos | Conjunto | Log CSV sin errores, 6 h OK |  |  |  |  |  |  |  |  |  |  | ▓
23 | Corrección de errores finales y revisión docente | Conjunto | Visto bueno docente |  |  |  |  |  |  |  |  |  |  |  | ▓
24 | Dispositivo 100% funcional — HITO DE CIERRE | Conjunto | ★ Dispositivo funcional (S12) |  |  |  |  |  |  |  |  |  |  |  | ★
SEGUIMIENTO Y EVIDENCIAS (continuo Semanas 7-12)
25 | Actualización semanal de tareas en herramienta de gestión | Iván | Capturas de pantalla semanales |  |  |  |  |  |  | ▓ | ▓ | ▓ | ▓ | ▓ | ▓
26 | Registro fotográfico de avance de construcción | Joshua | Fotos por etapa (Drive/repo) |  |  |  |  |  |  | ▓ | ▓ | ▓ | ▓ | ▓ | ▓
27 | Repositorio GitHub: commits semanales de firmware | Alfredo | Historial de commits visible |  |  |  |  |  |  | ▓ | ▓ | ▓ | ▓ | ▓ | ▓
28 | Revisiones con docente (al menos 1 por semana, S7-S12) | Conjunto | Minuta de revisión |  |  |  |  |  |  | ▓ | ▓ | ▓ | ▓ | ▓ | ▓

Sheet: Riesgos y Contingencias
RIESGOS Y PLAN DE CONTINGENCIA — Panel Solar
# | Riesgo | Probabilidad | Impacto | Acción de mitigación | Holgura/Semana
1 | Componentes no disponibles en Casa Rivas / Steren | Alta | Alto | Pedir en Semana 6 (actual). Alternativas: ACS712 para corriente, DHT22 para temperatura. Proveedor online como fallback. | S7 — Margen: 3 días
2 | Fallo del ADS1115 (componente activo crítico) | Media | Alto | Comprar 2 unidades. Si falla 1, la segunda cubre sin retrasar el cronograma. | S8 — Margen: 2 días
3 | Error de firmware: desbordamiento en barrido I-V o ciclo de relés | Media | Medio | Pruebas unitarias en S8 antes de integrar al banco completo. Versiones de firmware tageadas en GitHub. | S9 — Margen: 1 semana
4 | Panel solar disponible solo en exterior → variabilidad climática | Alta | Medio | Realizar caracterizaciones en ventana 10h-14h. Registrar irradiancia relativa (Isc_ref) para normalizar. | S9-S10 — Margen: 2 días
5 | Retraso en adquisición experimental de coeficientes térmicos (sin hoja técnica) | Media | Medio | Usar valor bibliográfico γ ≈ −0.4 %/°C como provisional. Medir experimentalmente en S9 con horno o placa caliente. | S10 — Margen: 3 días
6 | Pérdida de datos (CSV corrupto o pérdida de historial) | Baja | Alto | Backup automático en Google Drive desde PC cada 24h. Repositorio GitHub con datos de calibración. | Continuo — Sin holgura
7 | Integrante no disponible por fuerza mayor | Baja | Medio | Roles documentados en GitHub README. Cualquier integrante puede retomar la tarea. Revisión semanal con docente. | Continuo — Reorganizar en 1 día
8 | Dispositivo no funcional al cierre de S11 (buffer antes de S12) | Baja | Crítico | Semana 11 tiene prueba de estrés anticipada. S12 es buffer de corrección. Si falla S11, S12 es recuperación completa. | S12 = buffer oficial

Sheet: Roles y Seguimiento
ROLES, SEGUIMIENTO Y EVIDENCIAS
Integrante | Rol principal | Actividades clave (S7-S12) | Cómo evidencia su avance
Alfredo Cortez | Lead Firmware & Electrónica | Montaje protoboard, firmware ESP32 (v1-v3), implementación de fórmulas η, P25, PR(t), pruebas I²C/1-Wire | Commits semanales en GitHub con tag de versión; capturas de Serial Monitor
Joshua Garcilazo | Hardware & Ensamble | Adquisición de componentes, construcción banco de carga, soldadura y montaje final, registro fotográfico | Fotos por etapa subidas a carpeta compartida (Drive); checklist de componentes firmada
Iván Salguero | Integración, Docs & PM | Control GPIO banco de relés, calibración divisor resistivo, envío de avances, actualización herramienta de gestión, minutas de reunión con docente | Capturas de pantalla de herramienta (Trello/Notion) actualizadas cada semana; minutas en Drive
MECANISMO DE SEGUIMIENTO SEMANAL
Herramienta de gestión | Trello / Notion (a elección del equipo) | Actualizar estado de tareas cada viernes antes del cierre de jornada
Repositorio de código | GitHub (commits con mensaje descriptivo) | Al menos 1 commit por sesión de trabajo; rama main protegida
Evidencias físicas | Google Drive compartido con docente | Fotos del ensamble + CSV de datos de calibración por semana
Revisión con docente | Karen Pimentel — 1 sesión/semana | Minuta firmada; pendientes resueltos antes de la siguiente sesión
Puntos de control (gates) | S7, S9, S11 = revisiones de avance | Si no pasa el gate S9, activar contingencia de S10 inmediatamente
