Joshua203-byte/Pcb/Plantilla Estado del arte_alumno (1).xlsx

Sheet: Instrucciones
ARCHIVO DE APOYO PARA ESTADO DEL ARTE
Estructura del archivo y cómo usarlo
HOJA | PARA QUÉ SIRVE | CÓMO LLENARLA
Matriz Literatura | Registro de cada documento revisado: autor, año, método, hallazgo y limitación. | Una fila por documento. Use el ID (L-001, L-002...) para citarlo desde la matriz del proyecto. Escriba la limitación con las palabras del autor y el vacío con las suyas.
Matriz Proyecto | Registro de cada mecanismo de pérdida: descripción, mecanismo físico, pérdida en % y fuente. | Una fila por fenómeno o componente. Toda pérdida debe tener fuente y, si existe, el ID del documento de la Matriz Literatura.
Síntesis y Vacíos | Tablero automático: cobertura temporal, métodos, tipos de fuente y campos incompletos. | No se escribe nada aquí. Se actualiza sola al llenar las matrices.
Listas | Catálogos de las listas desplegables. | Edite o agregue opciones si su tema requiere otras categorías.
Guía del Alumno | Versión para estudiantes: pasos, palabras clave, operadores de búsqueda y criterios de calidad.
CÓMO IDENTIFICAR LOS VACÍOS (lectura de la matriz)
1. Vacío temporal | Si casi toda la literatura es anterior a los últimos 5 años, el tema está desactualizado: ahí hay oportunidad.
2. Vacío metodológico | Si domina un solo método (p. ej. todo simulación y nada experimental), el vacío es de validación.
3. Vacío de contexto | Compare la columna País/Contexto: si nadie estudió su región o tipo de instalación, ese es su aporte.
4. Vacío de evidencia | Mecanismos de pérdida sin fuente, con confianza baja o con rangos muy amplios (mín vs máx) = dato débil por confirmar.
5. Limitaciones repetidas | Si la misma limitación aparece en varios autores, deja de ser una limitación aislada y se vuelve el problema de investigación.
Regla de oro: cada dato numérico registrado debe poder rastrearse hasta su fuente (DOI o URL). Sin fuente, el dato no entra al estado del arte.
PREGUNTA DE INVESTIGACIÓN DEL PBL
¿Cómo podemos predecir el momento óptimo de mantenimiento de un panel solar mediante un sistema de monitoreo electrónico y un modelo matemático de degradación de eficiencia?
Sub-pregunta | Qué buscar en la literatura | Categoría temática a usar en la matriz
¿Qué hace perder eficiencia al panel? | Mecanismos físicos de pérdida y su magnitud típica en % (soiling, PID, LID, hot spot, térmicas...) | Degradación de módulos FV / Ensuciamiento
¿Cómo se mide esa pérdida en campo? | Variables medibles (V, I, irradiancia, temperatura), sensores, frecuencia de muestreo, norma IEC 61724-1 | Monitoreo electrónico / sensores / IoT
¿Cómo se modela la degradación? | Modelos lineal, exponencial, YoY, regresión del Performance Ratio, machine learning; error reportado del modelo | Modelos matemáticos de degradación
¿Cómo se decide el momento óptimo? | Umbrales de intervención, criterios costo-beneficio de limpieza, intervalos óptimos, mantenimiento predictivo vs. preventivo | Mantenimiento predictivo y programación / Análisis económico
¿Qué tan válido es fuera de su contexto? | Clima del estudio, tecnología de celda y años de datos; contraste con las condiciones locales del proyecto | Efectos climáticos y ambientales

Sheet: Guia del Alumno
GUÍA DEL ALUMNO — CÓMO CONSTRUIR EL ESTADO DEL ARTE
Pregunta del PBL: ¿Cómo podemos predecir el momento óptimo de mantenimiento de un panel solar mediante un sistema de monitoreo electrónico y un modelo matemático de degradación de eficiencia?
PASO | QUÉ HACER | DÓNDE SE REGISTRA
1. Explorar | Antes de leer, hagan una lluvia de ideas por ámbito: óptico, térmico, eléctrico, mecánico, ambiental y de sistema. Anoten los factores que creen que hacen perder eficiencia al panel. | Matriz Proyecto, columna "Factor identificado"
2. Buscar | Busquen artículos que confirmen, corrijan o cuantifiquen cada factor. Usen las palabras clave y operadores de abajo. | Matriz Literatura, una fila por documento
3. Explicar la física | Para cada factor respondan POR QUÉ ocurre en términos físicos (óptica, temperatura y semiconductores, resistencia, recombinación). No basta con nombrarlo. | Matriz Proyecto, columna "Mecanismo físico"
4. Cuantificar | Anoten la pérdida en % con su rango y SIEMPRE con la fuente. Un dato sin fuente no entra al estado del arte. | Matriz Proyecto, columnas de % y Fuente
5. Detectar vacíos | Revisen limitaciones repetidas entre autores, ámbitos sin registros y datos sin respaldo. Ahí está su aporte. | Hoja Síntesis y Vacíos (automática)
6. Redactar | Escriban el estado del arte siguiendo el orden de las matrices: qué se sabe, cómo se ha medido, qué se ha modelado y qué falta. | Documento del PBL
PALABRAS CLAVE SUGERIDAS (busquen también en inglés: la mayoría de la evidencia está en inglés)
Español | Inglés | Para qué sub-pregunta sirve
degradación de módulos fotovoltaicos | photovoltaic module degradation rate | ¿Qué hace perder eficiencia?
ensuciamiento de paneles solares | soiling losses PV | ¿Qué hace perder eficiencia?
monitoreo de sistemas fotovoltaicos | PV monitoring system IoT sensors | ¿Cómo se mide en campo?
razón de desempeño fotovoltaico | performance ratio IEC 61724 | ¿Cómo se mide en campo?
modelo de degradación de eficiencia | degradation rate estimation year-over-year | ¿Cómo se modela?
detección de fallas en paneles solares | PV fault detection machine learning | ¿Cómo se modela / diagnostica?
mantenimiento predictivo solar | predictive maintenance photovoltaic optimal cleaning schedule | ¿Cuándo es el momento óptimo?
OPERADORES DE BÚSQUEDA
AND / OR / NOT | soiling AND ("cleaning schedule" OR maintenance) NOT thermal — combina o excluye conceptos
Comillas " " | "performance ratio" — busca la frase exacta
Asterisco * | degrad* — recupera degradation, degraded, degrading
Dónde buscar | Google Scholar, ScienceDirect, IEEE Xplore, MDPI, SciELO, repositorios institucionales y normas IEC. Filtren por año ≥ últimos 5-10 años.
CRITERIOS DE CALIDAD — REVÍSENLOS ANTES DE ENTREGAR
Criterio | Se cumple cuando... | ✓
Cobertura | Hay al menos un factor identificado en cada uno de los 6 ámbitos de la matriz del proyecto.
Profundidad física | Cada factor explica el mecanismo físico, no solo el nombre del fenómeno.
Evidencia | Toda pérdida en % tiene fuente verificable (DOI o URL) y año.
Trazabilidad | Cada factor cuantificado está ligado a un ID de la Matriz Literatura.
Actualidad | Al menos el 60 % de la literatura es de los últimos 5 años (ver hoja Síntesis).
Diversidad metodológica | La revisión incluye trabajos experimentales y de modelado, no un solo método.
Vacío declarado | El equipo enuncia en una frase el vacío que su proyecto viene a llenar.
Regla de oro: si no pueden decir de dónde salió un número, ese número no existe para el estado del arte.

Sheet: Matriz Literatura
MATRIZ DE LITERATURA — ESTADO DEL ARTE
Una fila por documento revisado. Complete todos los campos; los vacíos en la columna "Vacío identificado" alimentan la hoja Síntesis y Vacíos.
ID | Autor(es) | Año | Título | Tipo de fuente | Revista / Editorial | País / Contexto | Categoría temática | Método | Muestra / Datos | Hallazgo principal | Resultado cuantitativo | Limitación | Vacío identificado | Relevancia | Fuente (DOI / URL) | Notas
L-001 | Jordan, D. C.; Kurtz, S. R.; VanSant, K.; Newmiller, J. | 2016 | Compendium of photovoltaic degradation rates | Artículo de revista (indexado) | Progress in Photovoltaics: Research and Applications, 24(7), pp. 978-989 | 40 países (metaanálisis global) | Degradación de módulos FV (largo plazo) | Revisión sistemática | >11 000 tasas de degradación publicadas en ~200 estudios | La degradación del silicio cristalino tiene una mediana de 0,5-0,6 %/año y una media de 0,8-0,9 %/año | Mediana x-Si 0,5-0,6 %/año; media 0,8-0,9 %/año | Agrega tecnologías, climas y metodologías heterogéneas; no atribuye la pérdida a mecanismos físicos concretos | Falta desagregar la tasa global por mecanismo y por clima tropical húmedo | Alta | https://doi.org/10.1002/pip.2744 | Fuente de referencia para fijar la magnitud del fenómeno a detectar
L-002 | Jordan, D. C.; Silverman, T. J.; Wohlgemuth, J. H.; Kurtz, S. R.; VanSant, K. T. | 2017 | Photovoltaic failure and degradation modes | Artículo de revista (indexado) | Progress in Photovoltaics: Research and Applications, 25(4), pp. 318-326 | EE. UU. (inventario multiclima) | Degradación de módulos FV (largo plazo) | Revisión sistemática | Inventario de modos de fallo reportados en literatura de campo | Los puntos calientes son la mayor preocupación en sistemas instalados en la última década; la decoloración domina en los antiguos | Hot spots 11,7 % de módulos (clima moderado post-2000); decoloración 50,5-100 % pre-2000; celdas fracturadas 1,2-47,5 % | Reporta frecuencia de aparición, no pérdida de potencia; sesgo hacia sistemas que alguien decidió inspeccionar | No vincula frecuencia de fallo con magnitud de pérdida eléctrica medible | Alta | https://doi.org/10.1002/pip.2866 | Cifras tomadas del manuscrito aceptado depositado en OSTI
L-003 | Aghaei, M.; Fairbrother, A.; Gok, A.; Ahmad, S.; Kazim, S.; Lobato, K.; Oreski, G.; Reinders, A.; Schmitz, J.; Theelen, M.; Yilmaz, P.; Kettle, J. | 2022 | Review of degradation and failure phenomena in photovoltaic modules | Artículo de revista (indexado) | Renewable and Sustainable Energy Reviews, 159, art. 112160 | Europa (consorcio multinacional) | Degradación de módulos FV (largo plazo) | Revisión sistemática | Revisión de mecanismos de degradación por componente del módulo | Sistematiza los fenómenos de degradación y fallo por capa del laminado y por factor de estrés ambiental | Marco cualitativo de clasificación (sin una cifra única de pérdida) | Revisión de alcance muy amplio; poca profundidad cuantitativa por mecanismo individual | Falta un marco que traduzca cada mecanismo a una firma eléctrica medible en campo | Alta | https://doi.org/10.1016/j.rser.2022.112160 | Aportado por el equipo; base conceptual del capítulo de degradación
L-004 | Yang, H.; Yin, Y.; Abu-Siada, A. | 2025 | A comprehensive review of solar panel performance degradation and adaptive mitigation strategies | Artículo de revista (indexado) | IET Control Theory & Applications, 19, art. e70040 | Australia (revisión global) | Degradación de módulos FV (largo plazo) | Revisión sistemática | Revisión de factores de degradación y estrategias adaptativas de mitigación | Los módulos nuevos declaran 0,40-0,50 %/año durante 30 años, pero la pérdida acumulada compromete la rentabilidad del proyecto | 0,40-0,50 %/año declarado; caso real 430 W -> 389 W = 0,48 %/año; ~8 % de pérdida acumulada en 20 años; PID hasta 30 % o más | Revisión sin datos experimentales propios; el marco normativo que propone es IEC 61850, no IEC 61724 | No propone un umbral operativo de intervención ni valida las estrategias adaptativas que recomienda | Alta | https://doi.org/10.1049/cth2.70040 | Aportado por el equipo; acceso abierto
L-005 | Al Mahdi, H.; Leahy, P. G.; Alghoul, M.; Morrison, A. P. | 2024 | A review of photovoltaic module failure and degradation mechanisms: causes and detection techniques | Artículo de revista (indexado) | Solar, 4(1), pp. 43-82 | Irlanda / Arabia Saudita (revisión global) | Detección de fallas y diagnóstico | Revisión sistemática | Revisión por componente, desde el vidrio protector hasta la caja de conexiones | Cada componente del módulo es susceptible a fallos específicos; algunos se degradan solos y otros arrastran componentes vecinos | Snail track: hasta 40 % de pérdida de potencia nominal; delaminación: Rsh 50 % menor y Rs 61 % mayor; celdas fisuradas: >10 % de pérdida a 6 años; decoloración detectada en 10-14 % de los módulos inspeccionados | Describe fallos y causas pero no explora acciones correctivas ni propone soluciones validadas | Faltan estudios que conecten la detección temprana con una decisión de mantenimiento accionable | Alta | https://doi.org/10.3390/solar4010003 | Aportado por el equipo; acceso abierto; muy útil para la relación fallo -> parámetro I-V
L-006 | Tsanakas, J. A.; Babics, M.; Mezzasalma, F.; Mignonac, A.; Colin, H.; Sicot, L.; Marechal, P.; Capron, G.; Rakotoniaina, J.-P.; Aimé, J. | 2026 | Long-term field degradation of crystalline-silicon PV modules: insights from fifteen years of monitoring and forensic analysis | Artículo de revista (indexado) | EPJ Photovoltaics, 17, art. 14 | Francia (planta en campo) | Degradación de módulos FV (largo plazo) | Monitoreo de campo | 15 años de monitoreo + análisis forense de laboratorio (flash test, EL, termografía) | El colapso del factor de forma por corrosión de interconexiones domina sobre la pérdida óptica por amarillamiento del EVA | Poli-Si 2,56 %/año; mono-Si 0,86 %/año; Isc -7 a -36 %; FF -27 a -54 %; Rs hasta x2,6; Rsh hasta 5,4 veces menor; Pmax -33 a -70 % | Estudio retrospectivo de un solo emplazamiento; no propone umbrales prospectivos de alerta | No existe validación de umbrales que permitan anticipar el cruce del límite crítico antes de que ocurra | Alta | https://doi.org/10.1051/epjpv/2026006 | Fuente clave para la firma eléctrica diferenciada de cada mecanismo
L-007 | de Oliveira, M. C. C.; Diniz Cardoso, A. S. A.; Viana, M. M.; Lins, V. F. C. | 2018 | The causes and effects of degradation of encapsulant ethylene vinyl acetate copolymer (EVA) in crystalline silicon photovoltaic modules: a review | Artículo de revista (indexado) | Renewable and Sustainable Energy Reviews, 81(Parte 2), pp. 2299-2317 | Brasil (revisión) | Degradación de módulos FV (largo plazo) | Revisión sistemática | Revisión de degradación del encapsulante EVA | La fotodegradación, la humedad, la delaminación, la formación de burbujas y el PID están encadenados a las propiedades del EVA | Marco cualitativo de mecanismos (sin cifra única de pérdida) | Revisión centrada en el material; no cuantifica la pérdida eléctrica asociada a cada grado de degradación | Falta correlacionar el grado de amarillamiento con la caída medible de Isc en campo | Alta | https://doi.org/10.1016/j.rser.2017.06.039 | Aportado por el equipo (enlace); metadatos verificados en RePEc
L-008 | Ilse, K.; Micheli, L.; Figgis, B. W.; Lange, K.; Daßler, D.; Hanifi, H.; Wolfertstetter, F.; Naumann, V.; Hagendorf, C.; Gottschalg, R.; Bagdahn, J. | 2019 | Techno-economic assessment of soiling losses and mitigation strategies for solar power generation | Artículo de revista (indexado) | Joule, 3(10), pp. 2303-2321 | Global (evaluación tecno-económica) | Ensuciamiento (soiling) y limpieza | Revisión sistemática | Estimación global de pérdidas por ensuciamiento y estrategias de mitigación | El ensuciamiento redujo la producción fotovoltaica mundial al menos 3-4 % en 2018, con proyección de 4-7 % | 3-4 % de la producción mundial (2018); 3 000-5 000 M EUR de pérdida de ingresos; >1 %/día en sitios áridos | Escala global; la tasa local de ensuciamiento es fuertemente específica del sitio y no extrapolable | No hay tasas de ensuciamiento publicadas para clima tropical con estación seca marcada | Alta | https://doi.org/10.1016/j.joule.2019.08.019 | Referencia obligada para dimensionar el problema del soiling
L-009 | Diazgranados-Garzón, J. D.; Romero-Bravo, J. C.; Navarro-Estrada, L. I.; Castillo-Sierra, R. de J.; Soto-Ortiz, J. D.; Pardo-González, M. | 2020 | Análisis del efecto de ensuciamiento sobre la eficiencia de paneles solares en el Caribe Colombiano | Artículo de revista (indexado) | Revista Facultad de Ingeniería Universidad de Antioquia, n.º 97, pp. 22-29 | Colombia (Caribe, clima tropical costero) | Ensuciamiento (soiling) y limpieza | Experimental | Dos paneles gemelos (uno limpio, uno expuesto); ANOVA multifactorial sobre curvas I-V | La pérdida por ensuciamiento es más pronunciada en la transición de limpio a ligeramente sucio y se atenúa al densificarse el depósito | Reducción máxima de eficiencia de aproximadamente 6 % en las horas de mayor radiación | Periodo de exposición corto y un solo emplazamiento costero | No se modela el óptimo económico de limpieza a partir de la curva de acumulación observada | Alta | https://doi.org/10.17533/udea.redin.20191156 | En español; el contexto climático más cercano al de El Salvador que se pudo documentar
L-010 | Takeuchi, R. de O. A.; Cremasco, N. P.; Leludak, J. A.; Urbanetz Junior, J. | 2022 | Avaliação físico-química da sujidade depositada sobre módulos fotovoltaicos instalados em zonas climáticas do Paraná, Brasil | Artículo de revista (indexado) | Revista Brasileira de Energia Solar, 13(1), pp. 83-91 | Brasil (4 zonas climáticas de Paraná) | Ensuciamiento (soiling) y limpieza | Experimental | Microscopía electrónica de barrido (SEM) y espectroscopía de energía dispersiva (EDS) del depósito natural | El polvo depositado es mineral y de granulometría fina, lo que explica su carácter absorbente y difusor | Partículas de 1 a 58 µm; oxígeno dominante, seguido de hierro, silicio, aluminio y calcio | Caracteriza el depósito pero no cuantifica la pérdida eléctrica asociada | Falta ligar la composición y granulometría del polvo con la caída medida de Isc | Media | https://doi.org/10.59627/rbens.2022v13i1.385 | En portugués; complementa el mecanismo óptico del soiling
L-011 | de Souza, T. L. S.; Lima, R. L. F. A.; de Lima Júnior, C. | 2022 | Dirt on photovoltaic modules and efficient energy generation in the Brazilian semiarid | Artículo de revista (indexado) | Revista Brasileira de Engenharia Agrícola e Ambiental, 26(5), pp. 321-326 | Brasil (semiárido) | Ensuciamiento (soiling) y limpieza | Experimental | Estudio de campo en clima semiárido | Documenta el efecto de la suciedad sobre la generación en el semiárido brasileño | Sin dato extraído: no se obtuvo acceso al texto completo | No se pudo consultar el texto completo; solo se verificaron los metadatos | Registro incluido como evidencia de existencia de literatura regional, no como fuente de datos | Baja | https://doi.org/10.1590/1807-1929/agriambi.v26n5p321-326 | SIN DATO NUMÉRICO ASIGNADO — pendiente de conseguir el texto completo
L-012 | Kumari, N.; Singh, S. K.; Kumar, S.; Jadoun, V. K. | 2024 | Performance analysis of partially shaded high-efficiency mono PERC/mono crystalline PV module under indoor and environmental conditions | Artículo de revista (indexado) | Scientific Reports, 14, art. 21587 | India (interior y exterior) | Degradación de módulos FV (largo plazo) | Mixto (exp. + num.) | Un módulo mono PERC con sombreado artificial controlado, interior y exterior | La relación entre área sombreada y pérdida de potencia es fuertemente no lineal y genera puntos calientes | 20 % de sombra -> 11,6 % de pérdida; 40 % -> 30,4 %; 60 % -> 36,18 %; máximo exterior 42 %; punto caliente 85,5-90,1 °C | Un solo módulo y sombras artificiales geométricas, distintas de las sombras reales | Falta caracterizar sombras reales (vegetación, nubes) con patrón horario repetible | Alta | https://doi.org/10.1038/s41598-024-72502-z | Base cuantitativa del factor de sombreado parcial
L-013 | Trejos Grisales, A.; Osorio Giraldo, A.; González Montoya, D.; Durango Flórez, M.; Rodríguez Bastidas, J. D. | 2020 | Análisis del comportamiento de arreglos fotovoltaicos con degradación operando bajo condiciones de sombreado parcial | Artículo de revista (indexado) | Revista EIA, 17(33) | Colombia (simulación) | Modelos matemáticos de degradación | Numérico / Simulación | Modelo de un diodo y simulación en MATLAB de arreglos de 2x2 hasta 20x5 módulos | El factor de forma por sí solo NO es fiable para detectar degradación bajo sombreado parcial, porque la degradación puede afectar a un máximo local y no al global | Rs de 3 a 5 ohm reduce el GMPP de 444,5 W a 387,3 W; error MAPE de validación 0,40-1,02 % | Trabajo puramente de simulación, con validación experimental limitada | Falta validar experimentalmente el criterio de diagnóstico bajo sombreado en módulos reales degradados | Alta | https://doi.org/10.24050/reia.v17i33.1376 | En español; ADVERTENCIA METODOLÓGICA clave para el algoritmo de alerta
L-014 | Ge, Q.; Li, Z.; Sun, Z.; Xu, J.; Long, H.; Sun, T. | 2022 | Low resistance hot-spot diagnosis and suppression of photovoltaic module based on I-U characteristic analysis | Artículo de revista (indexado) | Energies, 15(11), art. 3950 | China (laboratorio) | Detección de fallas y diagnóstico | Mixto (exp. + num.) | Modelo de baja resistencia y ensayo de la característica I-U en polarización inversa | Un punto caliente de baja resistencia produce una recta inclinada identificable en la curva I-U en inversa; el módulo sano da una curva horizontal | Diferencia de 6-10 °C en módulo aislado y >100 °C en configuración de cadena; P = (I - beta*Isc)^2 * R_LR | Requiere polarizar el módulo en inversa, lo que no es trivial durante la operación normal | Falta un método de detección de punto caliente que no exija polarización inversa | Alta | https://doi.org/10.3390/en15113950 | Define si el hardware del prototipo necesita capacidad de polarización inversa
L-015 | Gao, C.; Liang, P.; Ren, H.; Han, P. | 2018 | Experimental research on the relationship between bypass diode configuration of photovoltaic module and hot spot generation | Artículo de revista (indexado) | Journal of Semiconductors, 39(12), art. 124014 | China (Academia China de Ciencias) | Detección de fallas y diagnóstico | Experimental | Cinco módulos policristalinos comerciales con 0, 1, 3, 15 y 60 diodos de bypass; termografía IR | La condición necesaria del punto caliente es que la celda sombreada quede a tensión de terminal negativa con el diodo de bypass en corte | Celda sombreada a 64,6 °C con 6 cm2 de sombra (38,1 °C con sombra total); probabilidad de hot spot de 99,18 % a 0,41 % según la densidad de diodos | Módulos policristalinos de una sola gama y sombreado artificial | No se evalúa el efecto de un diodo de bypass ya degradado o en falla | Alta | https://doi.org/10.1088/1674-4926/39/12/124014 | Revista china con texto en inglés; argumento de diseño cuantificado sobre diodos de bypass
L-016 | Luo, W.; Khoo, Y. S.; Hacke, P.; Naumann, V.; Lausch, D.; Harvey, S. P.; Singh, J. P.; Chai, J.; Wang, Y.; Aberle, A. G.; Ramakrishna, S. | 2017 | Potential-induced degradation in photovoltaic modules: a critical review | Artículo de revista (indexado) | Energy & Environmental Science, 10(1), pp. 43-68 | Singapur / EE. UU. / Alemania | Degradación de módulos FV (largo plazo) | Revisión sistemática | Revisión crítica de mecanismos de PID | En el PID-s, iones de sodio del vidrio migran a las fallas de apilamiento y derivan parcialmente la unión P-N | Marco de mecanismos; el PID puede reducir la potencia de planta hasta 30 % o más (ver Yang, 2025) | Revisión sin datos experimentales propios; anterior a la generalización de TOPCon | Falta cuantificar el PID en tecnologías de contacto pasivado actuales | Alta | https://doi.org/10.1039/C6EE02271E | Referencia canónica del mecanismo de PID
L-017 | Mahmood, A.; dos Reis Benatto, G. A.; Thorsteinsson, S.; Poulsen, P. B.; Spataru, S. V. | 2026 | Modeling the electrical mismatch caused by potential-induced degradation in crystalline silicon photovoltaic modules and strings | Artículo de revista (indexado) | EPJ Photovoltaics, 17, art. 5 | Dinamarca (modelado + validación) | Modelos matemáticos de degradación | Mixto (exp. + num.) | Modelo de dos diodos y simulación de desajuste en cadenas con PID | El PID deja una firma inconfundible en la curva I-V: Rsh se desploma y aparece un escalón junto al MPP | PID-p 5,25 % de pérdida en STC (4,84 % anual); PID-s ~10 %; mismatch de cadena +0,72 % y +2,35 %; Rsh de 1000 ohm a 0,1 ohm; n2 de 2 a 9 | Resultados de simulación con validación experimental limitada a pocos módulos | Falta validar la firma en instalaciones reales con datos de monitoreo continuo | Alta | https://doi.org/10.1051/epjpv/2025028 | Define la resolución necesaria cerca del MPP para no perder el escalón
L-018 | Jony, J. A.; Yousuf, H.; Zahid, M. A.; Sanyal, S.; Khokhar, M. Q.; Madara, P. C.; Hu, Y.; Chu, M.; Kim, Y.; Dhungel, S. K.; Yi, J. | 2024 | The mechanics of light elevated temperature induced degradation (LeTID) on PERC module: a review | Artículo de revista (indexado) | Transactions on Electrical and Electronic Materials, 25(3), pp. 247-254 | Corea del Sur (revisión) | Degradación de módulos FV (largo plazo) | Revisión sistemática | Revisión de mecanismos de LeTID en módulos PERC | La inyección excesiva de hidrógeno durante la fabricación origina defectos atómicos responsables del LeTID | PERC hasta 10 % (16 % en casos extremos); mono-Si 2-3,6 %; multi-Si 3,8-7,5 %; c-Si general ~5 % | Mecanismo aún en debate; los valores dependen fuertemente del fabricante y del proceso | Falta separar en campo la degradación inicial que satura de la deriva lineal de largo plazo | Alta | https://doi.org/10.1007/s42341-024-00526-3 | Obliga a que el modelo predictivo no extrapole la pendiente inicial
L-019 | Gebhardt, P.; Rivera, M.; Fokuhl, E.; Reise, C.; Schnabel, E.; Hädrich, I.; Pander, M. | 2026 | UV-induced degradation: comparative analysis of PV module testing and stabilization procedures against outdoor behavior | Artículo de revista (indexado) | EPJ Photovoltaics, 17, art. 15 | Alemania (Fraunhofer ISE y CSP) | Degradación de módulos FV (largo plazo) | Mixto (exp. + num.) | Módulos TOPCon; ensayo UV de laboratorio (44 kWh/m2, <=365 nm) contra un año de exposición exterior | La degradación por UV se origina en la celda, por ruptura de enlaces Si-H en la capa de pasivación | -2,2 % en Pmpp y -1,6 % en Voc en laboratorio; -1,4 a -2,3 % en Pmpp tras un año exterior; el almacenamiento en oscuridad infla la medida ~6,5 % sin estabilización | Centrado en TOPCon; no cubre módulos c-Si convencionales antiguos | Falta protocolo de estabilización de bajo costo aplicable a medición de campo | Alta | https://doi.org/10.1051/epjpv/2026007 | ADVERTENCIA de protocolo: estabilizar por light soaking antes de medir
L-020 | Hudișteanu, V.-S.; Cherecheș, N.-C.; Țurcanu, F.-E.; Hudișteanu, I.; Romila, C. | 2024 | Impact of temperature on the efficiency of monocrystalline and polycrystalline photovoltaic panels: a comprehensive experimental analysis for sustainable energy solutions | Artículo de revista (indexado) | Sustainability, 16(23), art. 10566 | Rumanía (laboratorio) | Efectos climáticos y ambientales | Experimental | Paneles mono y policristalinos en el rango 20-75 °C | La eficiencia cae linealmente con la temperatura; Voc domina la pérdida mientras Isc sube ligeramente | -0,52 %/°C en eficiencia; -0,48 %/°C en Voc; +0,10 %/°C en Isc; -27,4 % de eficiencia y -24,0 % de Voc entre 25 y 75 °C | Condiciones de laboratorio y número reducido de módulos; sin envejecimiento | No se evalúa cómo cambian estos coeficientes en módulos ya degradados | Alta | https://doi.org/10.3390/su162310566 | Coeficiente de temperatura medido, base de la corrección a STC
L-021 | Afonso, D.; Mesbahi, O.; Bouich, A.; Tlemçani, M. | 2025 | Influence of long-term and short-term solar radiation and temperature exposure on the material properties and performance of photovoltaic panels: a comprehensive review | Artículo de revista (indexado) | Energies, 18(19), art. 5072 | Portugal (revisión) | Efectos climáticos y ambientales | Revisión sistemática | Revisión de efectos de radiación y temperatura sobre materiales y desempeño | El silicio cristalino es la tecnología con mayor sensibilidad térmica de todas las comparadas | c-Si: -0,44 a -0,50 %/°C; a-Si: -0,20 a -0,23; HJT: -0,26 a -0,32; CdTe: -0,23 a -0,28; perovskita: -0,08 a -0,17 | Revisión sin datos experimentales propios | Falta comparar el comportamiento térmico bajo humedad relativa alta sostenida | Alta | https://doi.org/10.3390/en18195072 | Confirma el rango del coeficiente térmico por tecnología
L-022 | Shaker, L. M.; Al-Amiery, A. A.; Hanoon, M. M.; Al-Azzawi, W. K.; Kadhum, A. A. H. | 2024 | Examining the influence of thermal effects on solar cells: a comprehensive review | Artículo de revista (indexado) | Sustainable Energy Research, 11, art. 6 | Irak / Malasia (revisión) | Efectos climáticos y ambientales | Revisión sistemática | Revisión de efectos térmicos a nivel de celda | El aumento de temperatura estrecha la banda prohibida y eleva la concentración intrínseca de portadores, intensificando la recombinación Auger y SRH | Descripción cualitativa del mecanismo (sin coeficientes numéricos propios) | No aporta valores cuantitativos de coeficientes de temperatura | Falta unir el mecanismo microscópico con el coeficiente macroscópico medible en campo | Media | https://doi.org/10.1186/s40807-024-00100-8 | Se cita solo por el mecanismo físico, no por cifras
L-023 | Piliougine, M.; Oukaja, A.; Sidrach-de-Cardona, M.; Spagnuolo, G. | 2021 | Temperature coefficients of degraded crystalline silicon photovoltaic modules at outdoor conditions | Artículo de revista (indexado) | Progress in Photovoltaics: Research and Applications, 29(5), pp. 558-570 | España / Italia (exterior) | Efectos climáticos y ambientales | Monitoreo de campo | Medición de coeficientes de temperatura en módulos c-Si envejecidos en exterior | Los coeficientes de temperatura cambian en módulos degradados respecto al valor de ficha técnica | Solo se cita la conclusión del resumen; no se accedió al texto completo | Texto completo tras muro de pago; no se extrajeron valores numéricos | El firmware de corrección no puede usar un coeficiente constante de ficha técnica | Alta | https://doi.org/10.1002/pip.3396 | Implicación directa para el diseño del algoritmo de corrección a STC
L-024 | Gasparin, F. P.; Kipper, F. D.; de Oliveira, F. S.; Krenzinger, A. | 2022 | Assessment on the variation of temperature coefficients of photovoltaic modules with solar irradiance | Artículo de revista (indexado) | Solar Energy, 244, pp. 126-133 | Brasil (laboratorio) | Efectos climáticos y ambientales | Experimental | Medición de coeficientes de temperatura a distintos niveles de irradiancia | Los coeficientes de temperatura varían de forma medible con el nivel de irradiancia | Solo se cita la conclusión del título y resumen; no se accedió al texto completo | Texto completo tras muro de pago; no se extrajeron valores numéricos | La corrección a STC debe depender de las condiciones y no de una constante única | Alta | https://doi.org/10.1016/j.solener.2022.08.052 | Segunda razón para no usar un coeficiente fijo
L-025 | Mavromatakis, F.; Vignola, F.; Marion, B. | 2017 | Low irradiance losses of photovoltaic modules | Artículo de revista (indexado) | Solar Energy, 157, pp. 496-506 | Grecia / EE. UU. | Métricas de desempeño (PR, tasa YoY) | Experimental | Análisis de pérdidas de módulos a baja irradiancia | A baja irradiancia la fuga por Rsh representa una fracción mayor de la corriente fotogenerada y hunde el factor de forma | SIN DATO EXTRAÍDO: texto completo no accesible | Texto completo tras muro de pago; no se pudo extraer ningún porcentaje citable | Falta cuantificar la pérdida anual por operación a baja irradiancia en clima nuboso tropical | Media | https://doi.org/10.1016/j.solener.2017.08.062 | SIN DATO NUMÉRICO ASIGNADO — solicitar por biblioteca institucional
L-026 | Mamun, M. A. A.; Islam, M. M.; Hasanuzzaman, M.; Selvaraj, J. | 2022 | Effect of tilt angle on the performance and electrical parameters of a PV module: comparative indoor and outdoor experimental investigation | Artículo de revista (indexado) | Energy and Built Environment, 3(3), pp. 278-290 | Malasia (clima tropical, interior y exterior) | Efectos climáticos y ambientales | Experimental | Un módulo con seguidor de un eje; inclinación de 0 a 80 grados a irradiancia constante de 750 W/m2 | La potencia y la eficiencia caen al aumentar la inclinación respecto al óptimo; el ángulo óptimo en condiciones malasias es 15 grados | Cada 5 grados de inclinación: -2,09 W (interior) y -3,45 W (exterior); eficiencia -0,54 % (int.) y -0,76 % (ext.); Isc -0,2025 A; temperatura de celda -3,62 °C (int.) y -2,70 °C (ext.); +100 W/m2 -> +7,52 °C (int.) y +5,67 °C (ext.) | Un solo módulo y un solo emplazamiento; irradiancia fija de 750 W/m2 en el ensayo principal | Falta determinar el ángulo óptimo y su penalización para latitudes centroamericanas (13-14 grados N) | Alta | https://doi.org/10.1016/j.enbenv.2021.02.001 | Aportado por el equipo; acceso abierto; base cuantitativa del factor ángulo/inclinación
L-027 | Hassan, A. A. M.; Elbaset, A. A.; Hasouna, A. T.; Emad, A. | 2015 | Design of a solar tracking system for improving solar photovoltaic efficiency | Congreso / Conferencia | 17th International Middle East Power Systems Conference (MEPCON), Mansoura University, Egipto | Egipto (28° N, exterior) | Monitoreo electrónico / sensores / IoT | Mixto (exp. + num.) | Dos montajes gemelos: panel fijo a 28° y panel con seguidor solar basado en LDR y microcontrolador Arduino | Seguir la trayectoria solar aumenta significativamente la energía captada frente a un montaje fijo | +23,15 % de potencia neta con seguidor de un eje; +29 % con seguidor de dos ejes | Publicación de congreso de 2015, fuera de la ventana de 10 años; un solo emplazamiento y periodo corto | No evalúa el consumo ni el mantenimiento del propio seguidor frente a la ganancia obtenida | Media | https://ieeexplore.ieee.org/document/7401346 | Aportado por el equipo; ANTIGÜEDAD >10 años: usar solo como contexto, no como dato principal
L-028 | Prasad, S. V. G. V. A. | 2021 | Solar panels and their diverse characteristics: an all-inclusive study | Artículo de revista (indexado) | Revista GEINTEC (ISSN 2237-0722), 11(4) | India (revisión) | Degradación de módulos FV (largo plazo) | Revisión sistemática | Revisión comparativa de tipos de panel, eficiencia, coeficiente de temperatura y clasificaciones de fuego y granizo | El coeficiente de temperatura diferencia claramente la aptitud de cada tecnología para climas cálidos | Mono y policristalino: -0,3 a -0,5 %/°C; capa delgada: 0,2 %/°C | Revisión divulgativa en revista de bajo factor de impacto; sin datos experimentales propios ni trazabilidad de las cifras | Las cifras citadas no se pueden rastrear a una medición primaria | Baja | https://doi.org/10.47059/revistageintec.v11i4.2465 | Aportado por el equipo; SOLO CORROBORA el rango; no usar como fuente principal
L-029 | Diaz Ganillo, R. A.; Mendoza Puruncajas, Á. J. | 2024 | Análisis técnico para la viabilidad de implementación a futuro de paneles fotovoltaicos en el sector de Turubamba Bajo | Artículo de revista (indexado) | LATAM Revista Latinoamericana de Ciencias Sociales y Humanidades, 5(1) | Ecuador (Quito, latitud ecuatorial) | Análisis económico del mantenimiento | Estudio de caso | Medición de radiación solar durante un año e inventario de infraestructura del sector | La implementación es técnicamente viable; la orientación, inclinación y sombreado son los factores de diseño determinantes | Eficiencias comerciales citadas de 14-20 %; inclinación de referencia 23,5 grados por el solsticio; criterio de estabilización: pérdida >5 % reprueba el módulo | Estudio de viabilidad, no de degradación; varias cifras provienen de fuentes divulgativas y no de literatura arbitrada | La literatura latinoamericana disponible es de viabilidad y no de monitoreo de degradación de largo plazo | Baja | https://doi.org/10.56712/latam.v5i1.1742 | Aportado por el equipo; en español; EVIDENCIA DEL VACÍO REGIONAL
L-030 | Rojas-Hernández, I.; Lizana Moreno, F. | 2018 | Tiempo de recuperación de la energía para sistemas fotovoltaicos basados en silicio cristalino en Costa Rica | Artículo de revista (indexado) | Ingeniería Energética, 39(3), pp. 195-202 | Costa Rica (5 emplazamientos) | Análisis económico del mantenimiento | Analítico | Análisis de ciclo de vida en cinco emplazamientos | El tiempo de retorno energético del silicio cristalino en Costa Rica es de 2,7 a 3 años | TRE de 2,7 a 3 años; se asume vida útil de 25 años | No aborda degradación de módulos ni monitoreo de largo plazo; asume 25 años sin examinar tasas | Confirma que la literatura centroamericana disponible no cubre degradación ni monitoreo | Media | https://www.redalyc.org/journal/3291/329158816007/html/ | En español; EVIDENCIA DIRECTA DEL VACÍO nº 5
L-031 | Shen, J.; Lee, H.-D.; Tae, D.-H.; Rho, D.-S. | 2021 | Estudio sobre el fenómeno de degradación basado en un equipo de ensayo para el diagnóstico de envejecimiento de módulos fotovoltaicos | Artículo de revista (indexado) | Journal of the Korea Academia-Industrial Cooperation Society, 22(6), pp. 27-35 | Corea del Sur (19 años de operación) | Degradación de módulos FV (largo plazo) | Monitoreo de campo | Banco de ensayo con registro cada minuto y filtrado Savitzky-Golay sobre 19 años de datos | La degradación acumulada en clima cálido y húmedo supera con holgura la mediana mundial, con fuerte estacionalidad | 25,73 % de pérdida total en 19 años = 1,55 %/año; reducción media de salida: verano 50,53 %, primavera 28,25 %, invierno 20,01 %, otoño 5,24 % | Un solo emplazamiento; la comparación estacional mezcla efectos de temperatura y de irradiancia | Falta separar la contribución estacional reversible de la degradación permanente acumulada | Alta | https://doi.org/10.5762/KAIS.2021.22.6.27 | En coreano; único estudio localizado con desglose estacional a 19 años
L-032 | Masuda, A. | 2021 | Fenómenos de degradación de los módulos fotovoltaicos y directrices para mejorar su fiabilidad | Artículo de revista (indexado) | Oyo Buturi (Applied Physics, Japón), 90(6), pp. 339-345 | Japón (revisión) | Degradación de módulos FV (largo plazo) | Revisión sistemática | Revisión conceptual de fenómenos de degradación | Organiza la degradación en tres factores primarios: sombreado, pérdida de capacidad de colección de corriente y caída de la tensión fotogenerada | Marco de clasificación en tres factores (sin cifras propias) | Revisión conceptual sin datos experimentales propios | Falta traducir el marco de tres factores a umbrales medibles | Media | https://doi.org/10.11470/oubutsu.90.6_339 | En japonés; su marco coincide de forma independiente con el de este estado del arte
L-033 | Fonseca, J. E. F.; Oliveira, F. S.; Prieb, C. W. M.; Krenzinger, A. | 2020 | Análise da degradação em duas instalações fotovoltaicas, localizadas em Porto Alegre, Brasil | Congreso / Conferencia | XVII Congresso Ibérico e XIII Congresso Ibero-Americano de Energia Solar (CIES2020) | Brasil (Porto Alegre, subtropical húmedo) | Degradación de módulos FV (largo plazo) | Monitoreo de campo | Curvas I-V, electroluminiscencia, termografía e inspección visual en dos plantas | El amarillamiento del encapsulante y la delaminación son los modos dominantes en clima subtropical húmedo | 0,7 %/año en la instalación de 15 años y 0,85 %/año en la de 3 años | Comunicación de congreso; muestra reducida y un solo emplazamiento | Falta serie continua de monitoreo eléctrico que permita anticipar el cruce del umbral | Media | https://repositorio.lneg.pt/handle/10400.9/3766 | En portugués; congreso arbitrado, menor peso que un artículo de revista
L-034 | Herrera Casanova, R.; García Tamayo, J. G.; Bello García, B.; León Viltres, L.; Herrera Fernández, F. B. | 2022 | Propuesta de modelo predictivo inteligente para una planta fotovoltaica | Artículo de revista (indexado) | Revista Cubana de Ciencias Informáticas, 16(1), pp. 144-162 | Cuba (clima tropical caribeño) | Modelos matemáticos de degradación | Numérico / Simulación | Modelos LSTM (64 y 32 neuronas) y CNN (Conv1D 64 filtros); 112 horas históricas para predecir 14 horas | El modelo LSTM supera al CNN en la predicción directa de la potencia generada usando irradiancia, temperatura ambiente, temperatura de módulo y potencia histórica | RMSE normalizado de aproximadamente 1,9 % en la curva de aproximación del comportamiento de potencia | Predice generación a corto plazo, no degradación de largo plazo; validado en un solo emplazamiento y dos periodos estacionales | No existe un modelo regional que prediga degradación de largo plazo, solo generación a corto plazo | Alta | https://www.redalyc.org/journal/3783/378370413010/html/ | Aportado por el equipo; en español; modelo regional más cercano a nuestro objetivo
L-035 | Ahmed, A. M.; Li, L.; Khalilpour, K. | 2025 | Predictive maintenance of solar photovoltaic systems: a comprehensive review | Artículo de revista (indexado) | IET Renewable Power Generation, 19(1), art. e70152 | Australia (revisión) | Mantenimiento predictivo y programación | Revisión sistemática | Revisión comparativa de modelos de aprendizaje automático y profundo para mantenimiento predictivo | El estado real del equipo es de medición indirecta, lo que complica la predicción de fallos; la comparación entre modelos aún no converge | Sin cifra única; comparación cualitativa de desempeño entre familias de modelos | Revisión de métodos, sin validación experimental propia ni datos de campo nuevos | Los conjuntos de datos disponibles están dominados por fallos simulados y hardware de gama alta | Alta | https://doi.org/10.1049/rpg2.70152 | Justifica generar un conjunto de datos propio con hardware de bajo costo
L-036 | Romero-Fiances, I.; Livera, A.; Theristis, M.; Makrides, G.; Stein, J. S.; Nofuentes, G.; de la Casa, J.; Georghiou, G. E. | 2022 | Impact of duration and missing data on the long-term photovoltaic degradation rate estimation | Artículo de revista (indexado) | Renewable Energy, 181, pp. 738-748 | Chipre / España / EE. UU. | Modelos matemáticos de degradación | Numérico / Simulación | Comparación de técnicas de estimación (YoY, STL, CSD, OLS, ARIMA, RPCA) con datos sintéticos y reales | La exactitud de la mayoría de técnicas converge dentro de +-0,2 %/año recién a los 5 años; los métodos de descomposición y YoY convergen en 3 años | Convergencia a +-0,2 %/año tras 5 años; con 10 % de datos faltantes la desviación es 0,07-0,2 %/año; con 50 % faltantes todas sobrestiman en más de 0,6 %/año | Estudio metodológico; no propone umbrales de intervención de mantenimiento | Falta un criterio que traduzca la incertidumbre de la estimación en una decisión de mantenimiento | Alta | https://doi.org/10.1016/j.renene.2021.09.078 | Define cuántos meses de datos necesita el modelo antes de poder afirmar algo
L-037 | International Electrotechnical Commission (IEC) | 2021 | IEC 61724-1 Ed. 2.0: Photovoltaic system performance - Part 1: Monitoring | Norma / Estándar | International Electrotechnical Commission, Ginebra | Internacional (norma) | Monitoreo electrónico / sensores / IoT | Analítico | Norma internacional; define clases de sistema de monitoreo y requisitos por variable | Establece la terminología, el equipamiento y los métodos para el monitoreo y análisis de desempeño de sistemas fotovoltaicos | Define clases de exactitud del sistema de monitoreo (la 2.ª edición elimina la Clase C y actualiza los requisitos de sensor de irradiancia) | Documento de pago; no se consultó el texto completo, solo la designación y el alcance publicados | Norma de referencia: su aplicación en prototipos de bajo costo está poco documentada | Alta | https://webstore.ansi.org/standards/iec/iec61724ed2021 | Referencia normativa obligada para justificar la selección de sensores
L-038 | Li, B.; Diallo, D.; Migan-Dubois, A.; Delpha, C. | 2023 | Performance evaluation of IEC 60891:2021 procedures for correcting I-V curves of photovoltaic modules under healthy and faulty conditions | Artículo de revista (indexado) | Progress in Photovoltaics: Research and Applications, 31(5), pp. 474-493 | Francia (evaluación de procedimientos) | Métricas de desempeño (PR, tasa YoY) | Numérico / Simulación | Evaluación comparativa de los procedimientos de traslación de curvas I-V de la IEC 60891:2021 | Evalúa el desempeño de los procedimientos de corrección incluyendo el caso de módulos defectuosos, no solo sanos | Solo metadatos verificados; no se accedió al texto completo | Texto completo tras muro de pago; no se extrajeron valores numéricos | La corrección normalizada a STC está poco validada para módulos ya degradados | Alta | https://doi.org/10.1002/pip.3652 | Territorio compartido entre Persona A y Persona B
L-039 | Machado, P. L. O.; Fachini, L. V. G.; Tiuman, E. T.; Barchi, T. M.; Stevan Jr., S. L.; Siqueira, H. V.; Szmoski, R. M.; Antonini Alves, T. | 2025 | A low-cost Arduino-based I-V curve tracer with automated load switching for PV panel characterization | Artículo de revista (indexado) | Applied Sciences, 15(15), art. 8186 | Brasil (prototipo de laboratorio) | Monitoreo electrónico / sensores / IoT | Experimental | Arduino Mega 2560, ACS712 de 5 A, divisor resistivo de 5 resistencias, 8 resistencias de potencia conmutadas por relés | Es viable trazar la curva I-V completa con hardware de bajo costo calibrado contra multímetro | 256 combinaciones posibles de las que se usan 23 puntos; barrido completo en 45 s; incertidumbre igual a la del multímetro patrón (±2 % en corriente, ±0,5 % en tensión) | ADC de 10 bits y sensor de efecto Hall limitan la resolución; barrido lento frente a la variabilidad de la irradiancia | Falta un trazador de bajo costo con barrido rápido que tolere cambios de irradiancia durante la medición | Alta | https://doi.org/10.3390/app15158186 | Plano de referencia del prototipo de la Fase 3
L-040 | de Melo, G. C. G.; Torres, I. C.; de Araújo, Í. B. Q.; Brito, D. B.; Barboza, E. de A. | 2021 | A low-cost IoT system for real-time monitoring of climatic variables and photovoltaic generation for smart grid application | Artículo de revista (indexado) | Sensors, 21(9), art. 3293 | Brasil (planta real) | Monitoreo electrónico / sensores / IoT | Experimental | ESP32 (Heltec Wi-Fi LoRa 32 V2), ADS1115 y ADS8668 de 16 bits, NTC 10k, SHT20 y piranómetro de bajo costo; validado contra datalogger CR1000 | Un sistema IoT de bajo costo puede monitorear en tiempo real, pero con errores muy superiores a la señal de degradación anual | WAPE: 5,37-7,29 % en corrientes de cadena; 6,6 % en potencia AC; 13,54 % en irradiancia; 17,56 % en temperatura de módulo; costo total 1 142,55 USD | Los errores en irradiancia y temperatura de módulo son un orden de magnitud mayores que la degradación anual esperada | Falta una cadena de bajo costo cuya incertidumbre sea menor que la señal de degradación que se quiere detectar | Alta | https://doi.org/10.3390/s21093293 | Calibra las expectativas de exactitud del prototipo
L-041 | García-López, C.; Álvarez-Tey, G. | 2022 | Evaluation of the uncertainty of surface temperature measurements in photovoltaic modules in outdoor operation | Artículo de revista (indexado) | Sensors, 22(15), art. 5685 | España (exterior) | Monitoreo electrónico / sensores / IoT | Experimental | Termopares tipo K con cinta de aluminio en la cara posterior frente a cámara termográfica FLIR ThermaCAM S60 | La medición por contacto en la cara posterior es sensiblemente más exacta que la termografía, pero no mide la temperatura real de la celda | Incertidumbre expandida: ±2-3 °C por contacto y ±5,7-8 °C por infrarrojo; diferencia frontal-posterior de 6,4 °C (poli) y 8,3 °C (mono) | No mide directamente la temperatura de la unión; el salto térmico depende de la construcción del módulo | Falta un método de bajo costo para estimar la temperatura de celda a partir de la de la cara posterior | Alta | https://doi.org/10.3390/s22155685 | Con -0,5 %/°C, un error de 3 °C equivale a 1,5 % en potencia corregida
L-042 | Abe, C. F.; Dias, J. B.; Notton, G.; Faggianelli, G. A. | 2020 | Experimental application of methods to compute solar irradiance and cell temperature of photovoltaic modules | Artículo de revista (indexado) | Sensors, 20(9), art. 2490 | Brasil / Francia | Monitoreo electrónico / sensores / IoT | Experimental | Estimación de irradiancia a partir de Impp y de temperatura de celda a partir de Voc, Vmpp y Pmpp | Es posible estimar irradiancia y temperatura de celda usando el propio módulo como sensor, sin instrumentos dedicados | Irradiancia: nMAE 3,5-3,9 % y nRMSE 4,2-4,7 %; temperatura de celda: nMAE 3,4-8,2 % y nRMSE 4,3-10,7 % | El método falla bajo sombreado parcial y exige módulos razonablemente mantenidos | No se ha validado el método en módulos con degradación avanzada, donde los parámetros de referencia ya cambiaron | Alta | https://doi.org/10.3390/s20092490 | Alternativa de respaldo y validación cruzada de los sensores dedicados
L-043 | Sadeghi, R.; Memme, S.; Morchio, S.; Fossa, M.; Parenti, M. | 2026 | Infrared thermography in photovoltaic systems: a review for maximizing energy yield and long-term reliability | Artículo de revista (indexado) | Energies, 19(6), art. 1570 | Italia (revisión) | Detección de fallas y diagnóstico | Revisión sistemática | Revisión de protocolos de termografía infrarroja, inspección con drones e IA aplicada al diagnóstico | Las anomalías térmicas degradan progresivamente el desempeño y son detectables por termografía con un umbral prudente | Cada subcadena con anomalía reduce la salida de cadena 1,16 %; pérdidas de cadena típicas 2-4 % (>5 % en algunos casos); hasta 3 %/año de degradación asociada; umbral de 5 °C para evitar falsos positivos; -4 a -5 % de potencia por cada 10 °C | Revisión de métodos; la termografía requiere equipo específico y condiciones de inspección controladas | Falta un método eléctrico de bajo costo equivalente a la termografía para detección continua | Alta | https://doi.org/10.3390/en19061570 | Cuantifica el impacto de los puntos calientes a nivel de cadena

Sheet: Matriz Proyecto
MATRIZ DEL PROYECTO — FACTORES QUE AFECTAN LA EFICIENCIA DEL PANEL
Complete una fila por cada factor que ustedes identifiquen. La columna "Ámbito" ya indica dónde buscar; el factor, el porqué físico y el % con su fuente los aportan ustedes.
ID | Ámbito de la pérdida | Factor identificado (¿qué es?) | Descripción (¿dónde y cuándo ocurre?) | Mecanismo físico (¿por qué ocurre?) | Variable que lo gobierna | Condición de operación | Pérdida reportada (%) | Rango mín (%) | Rango máx (%) | Base de cálculo | Método de medición | Referencia (Autor, Año) | ID literatura | Fuente (DOI / URL) | Nivel de confianza | Aplicabilidad al proyecto
P-01 | 1. Óptico | Soiling (polvo/partículas) | Acumulación de polvo, sales, polen y contaminación sobre el vidrio frontal. Aparece de forma continua y se acentúa en estación seca; se revierte con lluvia o limpieza. | Pérdida óptica ANTES de la unión P-N: las partículas absorben y retrodispersan los fotones incidentes, de modo que se generan menos pares electrón-hueco y cae la corriente fotogenerada IL. Si el depósito es no uniforme añade desajuste entre celdas. | Tasa de deposición y días sin lluvia | Operación normal, exterior, sin limpieza | 600.0% | 300.0% | 700.0% | Reducción máxima de eficiencia medida en el Caribe colombiano (6 %); rango global de 3-4 % (2018) con proyección de 4-7 % de la producción anual | Soiling ratio: Isc de celda de referencia limpia vs. celda expuesta, a igual irradiancia | Diazgranados-Garzón et al., 2020; Ilse et al., 2019; Takeuchi et al., 2022 | L-009, L-008, L-010 | https://doi.org/10.17533/udea.redin.20191156 | Alto (medido, fuente primaria) | Directa
P-02 | 1. Óptico | Sombreado parcial | Sombra de vegetación, estructuras o cableado sobre una fracción del módulo. Tiene patrón horario repetible si el obstáculo es fijo. | Las celdas están en serie: la menos iluminada limita la corriente de toda la cadena y entra en polarización inversa, disipando potencia en lugar de generarla. Los diodos de bypass derivan la corriente e introducen escalones y máximos locales en la curva P-V. | Fracción de área sombreada | Exterior, sol directo con obstáculo | 3040.0% | 1160.0% | 4200.0% | Ensayo controlado sobre mono PERC: 20 % de sombra = 11,6 %; 40 % = 30,4 %; 60 % = 36,18 %; máximo exterior 42 % | Trazado de curva I-V completa: escalones y más de un máximo local en la curva P-V | Kumari et al., 2024; Trejos Grisales et al., 2020 | L-012, L-013 | https://doi.org/10.1038/s41598-024-72502-z | Alto (medido, fuente primaria) | Directa
P-03 | 1. Óptico | Reflexión óptica / ángulo de incidencia | Pérdida de luz útil cuando el rayo solar no incide perpendicular al vidrio. Es máxima al amanecer y al atardecer y en módulos mal orientados. | Dos efectos superpuestos: pérdida por coseno (la irradiancia efectiva escala con el coseno del ángulo respecto a la normal) y reflexión de Fresnel en la interfaz aire-vidrio, que crece rápidamente a ángulos rasantes. Ambos reducen IL sin dañar el semiconductor. | Ángulo de incidencia solar | Exterior, todo el día; crítico en horas extremas | 76.0% | 54.0% | 76.0% | Caída de eficiencia por cada 5 grados de desviación respecto al óptimo: 0,54 % en interior y 0,76 % en exterior (irradiancia constante de 750 W/m2) | Comparar potencia normalizada por irradiancia de plano de arreglo contra irradiancia global; seguimiento solar como contraste | Mamun et al., 2022; Hassan et al., 2015 | L-026, L-027 | https://doi.org/10.1016/j.enbenv.2021.02.001 | Alto (medido, fuente primaria) | Parcial (requiere ajuste)
P-04 | 2. Térmico | Pérdida térmica (coeficiente de temperatura) | Caída de eficiencia al subir la temperatura de la celda por encima de los 25 °C de referencia. Actúa en todo momento de operación y es el factor que más deteriora el rendimiento instantáneo. | Al subir T se estrecha la banda prohibida y crece exponencialmente la concentración intrínseca ni; como I0 depende de ni^2, se dispara la corriente de saturación y se hunde Voc = (nkT/q)·ln(IL/I0+1). Se intensifican la recombinación Auger y la SRH. Isc sube levemente pero el efecto neto es negativo. | Temperatura de celda | Irradiancia alta, poca ventilación | 52.0% | 30.0% | 52.0% | Coeficiente de eficiencia medido de -0,52 %/°C (rango de revisión: -0,30 a -0,50 %/°C); entre 25 y 75 °C la eficiencia cae 27,4 % | Sensor en cara posterior (DS18B20, NTC o termopar K) + corrección a STC según IEC 60891 | Hudișteanu et al., 2024; Afonso et al., 2025; Prasad, 2021 | L-020, L-021, L-028 | https://doi.org/10.3390/su162310566 | Alto (medido, fuente primaria) | Directa
P-05 | 2. Térmico | Punto caliente (hot spot) | Zona que opera muy por encima de la temperatura del resto porque una celda disipa potencia en polarización inversa. Es el modo de fallo de mayor preocupación en instalaciones de la última década. | Una celda con defecto local tiene resistencia paralelo anormalmente baja (decenas de ohm frente a miles), que abre un camino de fuga. La potencia disipada sigue P = (I - beta·Isc)^2 · R_LR, es decir crece cuadráticamente con la corriente. El calor degrada el encapsulante y puede perforar el laminado. | Resistencia paralelo local y corriente inversa | Sombreado o defecto local con diodo de bypass en corte | 300.0% | 116.0% | 500.0% | Cada subcadena con anomalía térmica reduce la salida de cadena 1,16 %; pérdidas de cadena típicas 2-4 % y hasta >5 %; degradación asociada de hasta 3 %/año | Termografía IR con umbral de 5 °C; eléctricamente, recta inclinada en la curva I-U en polarización inversa | Sadeghi et al., 2026; Ge et al., 2022; Gao et al., 2018 | L-043, L-014, L-015 | https://doi.org/10.3390/en19061570 | Alto (medido, fuente primaria) | Directa
P-06 | 2. Térmico | Ciclado térmico y fatiga de interconexiones | Dilatación y contracción diferencial entre silicio, cintas de cobre y encapsulante por los ciclos día-noche y estacionales, a lo largo de años de operación. | El desajuste de coeficientes de dilatación fatiga las uniones soldadas y las cintas; cada punto degradado añade resistencia serie. Como Rs penaliza la potencia de forma cuadrática con la corriente, el daño se manifiesta con más fuerza a irradiancia alta. | Amplitud y número de ciclos térmicos | Intemperie, operación de largo plazo (>5 años) | 4600.0% | 3500.0% | 4600.0% | Al iniciarse la falla de la unión soldada la potencia cae ~35 %; al progresar, ~46 % | Pendiente de la curva I-V cerca de Voc para estimar Rs; electroluminiscencia y termografía como confirmación | Al Mahdi et al., 2024; Tsanakas et al., 2026 | L-005, L-006 | https://doi.org/10.3390/solar4010003 | Medio (estimado / modelado) | Parcial (requiere ajuste)
P-07 | 3. Eléctrico (interno del módulo) | Degradación inducida por potencial (PID) | Aparece cuando las celdas quedan a alto potencial respecto al marco puesto a tierra, típicamente en los extremos de cadenas de alta tensión. Se acelera con humedad y temperatura altas. | En el PID-s, iones de sodio (Na+) del vidrio migran bajo el campo eléctrico y penetran en las fallas de apilamiento del silicio, provocando recombinación en la región de deplexión y derivando parcialmente la unión P-N. En el PID-p, una redistribución de carga en la capa antirreflectante induce recombinación superficial. | Potencial respecto a tierra, humedad y temperatura | Cadenas de alta tensión, clima húmedo y cálido | 1000.0% | 525.0% | 3000.0% | PID-p 5,25 % en STC (4,84 % de energía anual); PID-s ~10 %; a nivel de planta se han reportado caídas de hasta 30 % o más | Rsh de la pendiente cerca de Isc; escalón pronunciado junto al MPP; corriente de fuga a tierra del marco | Mahmood et al., 2026; Luo et al., 2017; Yang et al., 2025 | L-017, L-016, L-004 | https://doi.org/10.1051/epjpv/2025028 | Alto (medido, fuente primaria) | Directa
P-08 | 3. Eléctrico (interno del módulo) | Degradación inducida por luz (LID / LeTID) | Caída de potencia en las primeras horas o días (LID por complejo boro-oxígeno) o tras cientos de horas a más de 50 °C (LeTID en celdas PERC). Puede tardar años en saturar. | Se crean centros de recombinación en el volumen del silicio: complejo boro-oxígeno en obleas Cz dopadas con boro, y defectos ligados a inyección excesiva de hidrógeno en el LeTID. El tiempo de vida de los portadores minoritarios se desploma, sube la recombinación SRH y caen Voc e Isc. | Dosis de irradiación acumulada y temperatura | Primeras semanas o meses; PERC a más de 50 °C | 500.0% | 200.0% | 1600.0% | PERC hasta 10 % (16 % en casos extremos); mono-Si 2-3,6 %; multi-Si 3,8-7,5 %; ~5 % de referencia en c-Si | Caída de Pmax normalizada a STC en los primeros meses, correlacionada con dosis acumulada e historial térmico | Jony et al., 2024 | L-018 | https://doi.org/10.1007/s42341-024-00526-3 | Alto (medido, fuente primaria) | Parcial (requiere ajuste)
P-09 | 3. Eléctrico (interno del módulo) | Degradación inducida por ultravioleta (UVID) | Pérdida específica por la fracción ultravioleta del espectro, distinta de LID y LeTID. Relevante en celdas de contacto pasivado (TOPCon, PERC) que dominan el mercado actual. | Los fotones UV de longitud de onda menor o igual a 365 nm rompen enlaces Si-H en las capas de pasivación; la difusión del hidrógeno liberado degrada la pasivación superficial. Al subir la recombinación en superficie cae principalmente Voc. | Dosis UV acumulada (kWh/m2) | Exterior, primeras semanas a primer año | 220.0% | 140.0% | 230.0% | -2,2 % en Pmpp y -1,6 % en Voc con 44 kWh/m2 de UV en laboratorio; -1,4 a -2,3 % en Pmpp tras un año exterior | Caída temprana de Voc a STC correlacionada con la dosis UV; requiere estabilización por light soaking antes de medir | Gebhardt et al., 2026 | L-019 | https://doi.org/10.1051/epjpv/2026007 | Alto (medido, fuente primaria) | Parcial (requiere ajuste)
P-10 | 4. Mecánico / estructural | Microfisuras en celdas (y snail tracks) | Fisuras del silicio por cargas mecánicas, transporte, granizo o ciclado térmico. Suelen ser invisibles a simple vista y se asocian a los llamados snail tracks. | Las fisuras aíslan eléctricamente fracciones de celda y crean zonas de alta densidad de corriente que realimentan la formación de puntos calientes. Reducen el área activa efectiva y elevan la resistencia serie local. | Carga mecánica y ciclado térmico | Transporte, instalación, granizo, viento y nieve | 1000.0% | 120.0% | 4000.0% | Módulos con celdas fisuradas: más de 10 % de pérdida a 6 años; un módulo con snail track llegó a 40 % de la potencia nominal; prevalencia de 1,2 a 47,5 % de módulos según clima y antigüedad | Electroluminiscencia (referencia); indirectamente, caída de FF y aumento de Rs en la curva I-V | Al Mahdi et al., 2024; Jordan et al., 2017 | L-005, L-002 | https://doi.org/10.3390/solar4010003 | Alto (medido, fuente primaria) | Parcial (requiere ajuste)
P-11 | 4. Mecánico / estructural | Decoloración / delaminación del encapsulante | Amarillamiento y pérdida de adhesión del etilvinilacetato (EVA) por radiación ultravioleta, temperatura y humedad a lo largo de los años. Es el modo dominante en módulos de más de una década. | La fotooxidación del EVA forma polienos conjugados y especies carbonílicas que absorben selectivamente en el azul y reducen la transmitancia del laminado de forma uniforme. Menos fotones útiles llegan a la unión P-N y cae IL. La delaminación añade pérdida de acoplamiento óptico e ingreso de humedad. | Dosis UV, temperatura y humedad acumuladas | Intemperie, operación de largo plazo (>10 años) | 2000.0% | 700.0% | 3600.0% | Reducción de Isc de 7 a 36 % tras 15 años en campo, con Voc notablemente estable; decoloración presente en 50,5-100 % de módulos pre-2000 | Caída de Isc normalizada con Voc estable y SIN recuperación tras la limpieza (contraste con el soiling) | Tsanakas et al., 2026; de Oliveira et al., 2018; Fonseca et al., 2020 | L-006, L-007, L-033 | https://doi.org/10.1051/epjpv/2026006 | Alto (medido, fuente primaria) | Directa
P-12 | 4. Mecánico / estructural | Corrosión de contactos y cintas | Corrosión de barras colectoras y uniones soldadas por el ácido acético que genera la hidrólisis del EVA y queda atrapado en el laminado. Es el mecanismo que más potencia destruye a largo plazo. | El ácido acético ataca localmente los contactos metálicos; cada punto degradado añade resistencia serie. Rs penaliza la potencia de forma cuadrática con la corriente, de modo que la pérdida relativa crece con la irradiancia. La delaminación asociada reduce además la resistencia paralelo. | Humedad relativa y temperatura acumuladas | Clima cálido y húmedo, operación de largo plazo | 4000.0% | 2700.0% | 5400.0% | Colapso del factor de forma de 27 a 54 % a 15 años (el % registrado es la caída de FF). Datos asociados NO sumables: Rs hasta 2,6 veces su valor inicial; un módulo delaminado mostró Rsh 50 % menor y Rs 61 % mayor. | Rs de la pendiente de la curva I-V cerca de Voc y Rsh cerca de Isc; la pérdida relativa crece con la irradiancia | Tsanakas et al., 2026; Al Mahdi et al., 2024; Shen et al., 2021 | L-006, L-005, L-031 | https://doi.org/10.1051/epjpv/2026006 | Alto (medido, fuente primaria) | Directa
P-13 | 5. Ambiental / operativo | Montaje fijo sin seguimiento solar | Estructura fija frente a un montaje con seguidor. La energía no captada es una pérdida de diseño permanente, distinta de la pérdida instantánea por ángulo de incidencia del factor P-03. | Un montaje fijo solo alcanza incidencia perpendicular unas pocas horas al día; el resto del tiempo acumula pérdida por coseno y por reflexión de Fresnel. El seguidor mantiene el ángulo de incidencia cercano a cero y por tanto la irradiancia efectiva cercana a la máxima disponible. | Trayectoria solar diaria y estacional | Todo el día, todo el año; máxima en horas extremas | 2315.0% | 2315.0% | 2900.0% | Energía adicional medida por un montaje con seguidor frente a uno fijo a 28 grados: +23,15 % con seguidor de un eje y +29 % con seguidor de dos ejes. El % registrado es la energía NO captada por el montaje fijo respecto al de seguimiento. | Dos montajes gemelos, uno fijo y uno con seguidor, midiendo energía diaria en paralelo | Hassan et al., 2015; Mamun et al., 2022 | L-027, L-026 | https://ieeexplore.ieee.org/document/7401346 | Medio (estimado / modelado) | Referencial
P-14 | 5. Ambiental / operativo | Baja irradiancia, nubosidad y estacionalidad | Operación bajo irradiancia reducida en amaneceres, atardeceres, días nublados y estación lluviosa. No daña el módulo pero determina una parte importante de la energía anual. | IL es casi proporcional a la irradiancia G mientras Voc crece solo con el logaritmo de G. A G baja, la corriente que se fuga por Rsh representa una fracción mucho mayor de IL, de modo que el factor de forma y la eficiencia caen. | Irradiancia incidente G | Amanecer, atardecer, nubosidad y estación lluviosa |  |  |  | SIN DATO VERIFICADO: la fuente de referencia sobre pérdidas a baja irradiancia no fue accesible en texto completo. El estudio coreano muestra reducción estacional de salida de 5,24 % (otoño) a 50,53 % (verano), pero mezcla efectos de irradiancia y temperatura. | Normalizar la potencia por G (cociente de rendimiento, IEC 61724-1) y comparar entre franjas de irradiancia | Mavromatakis et al., 2017; Shen et al., 2021 | L-025, L-031 | https://doi.org/10.1016/j.solener.2017.08.062 | Bajo (dato secundario) | Parcial (requiere ajuste)
P-15 | 5. Ambiental / operativo | Clima cálido y húmedo (aceleración de la degradación) | Combinación de irradiancia alta, temperatura elevada y humedad relativa alta sostenida, característica del clima tropical del proyecto. Actúa como multiplicador de los demás mecanismos. | La humedad penetra por delaminación e hidroliza el EVA generando ácido acético que corroe los contactos; la temperatura acelera la cinética de todas las reacciones de degradación y favorece el PID. No es un mecanismo aislado sino un acelerador de los mecanismos 11 y 12. | Temperatura y humedad relativa acumuladas | Clima tropical húmedo, operación de largo plazo | 155.0% | 86.0% | 256.0% | Tasas medidas en clima cálido y húmedo: 1,55 %/año en 19 años (Corea) y hasta 2,56 %/año en policristalino (Francia, 15 años), frente a la mediana mundial de 0,5-0,6 %/año | Regresión de la potencia normalizada a STC contra el tiempo (año sobre año o descomposición de series) | Shen et al., 2021; Tsanakas et al., 2026; Jordan et al., 2016 | L-031, L-006, L-001 | https://doi.org/10.5762/KAIS.2021.22.6.27 | Alto (medido, fuente primaria) | Directa
P-16 | 6. Sistema (cableado, inversor, control) | Pérdidas de cableado (DC/AC) | Caída óhmica en los conductores entre módulos, cadena e inversor. Depende del calibre, la longitud y la temperatura del conductor. | Disipación por efecto Joule: P = I^2·R en el conductor. Crece cuadráticamente con la corriente y linealmente con la temperatura del cable, por lo que es máxima en las horas de mayor irradiancia. | Sección, longitud y temperatura del conductor | Operación normal; máxima a irradiancia alta |  |  |  | SIN DATO VERIFICADO: ninguna de las fuentes revisadas reporta un porcentaje de pérdida de cableado trazable. PENDIENTE de conseguir fuente (norma de instalación o estudio de planta). | Comparar potencia medida en bornes del módulo contra la medida en la entrada del inversor | PENDIENTE | PENDIENTE | PENDIENTE | Bajo (dato secundario) | Referencial
P-17 | 6. Sistema (cableado, inversor, control) | Pérdidas de conversión y MPPT anclado en máximo local | Ineficiencia del inversor o del convertidor y, sobre todo, error del seguidor del punto de máxima potencia cuando la curva P-V presenta varios máximos. | Bajo sombreado parcial los diodos de bypass generan máximos locales múltiples en la curva P-V. Un algoritmo MPPT convencional puede converger a un máximo local y quedarse ahí, entregando mucha menos potencia de la disponible sin que ningún componente esté dañado. | Forma de la curva P-V y algoritmo de seguimiento | Sombreado parcial o desajuste entre módulos |  |  |  | SIN DATO VERIFICADO para el porcentaje atribuible al MPPT. La literatura consultada documenta el mecanismo (aparición de máximos locales) pero no aísla su costo energético. PENDIENTE. | Comparar el punto de operación real del inversor contra el máximo global de la curva I-V trazada | Kumari et al., 2024; Trejos Grisales et al., 2020 | L-012, L-013 | https://doi.org/10.24050/reia.v17i33.1376 | Bajo (dato secundario) | Parcial (requiere ajuste)
P-18 | 6. Sistema (cableado, inversor, control) | Diodo de bypass en falla | Diodo de derivación en cortocircuito o en circuito abierto dentro de la caja de conexiones. En circuito abierto deja de proteger; en cortocircuito anula la subcadena. | El diodo en corte con la celda sombreada a tensión de terminal negativa es la condición necesaria para que se forme un punto caliente. Aumentar la densidad de diodos reparte la corriente inversa y reduce drásticamente la probabilidad de daño. | Configuración y estado de los diodos de bypass | Sombreado parcial o mismatch; agravado por calor en la caja de conexiones |  |  |  | SIN % DE PÉRDIDA ASIGNADO A PROPÓSITO: lo publicado es la PROBABILIDAD de aparición de punto caliente en cortocircuito, que cae de 99,18 % (protección mínima) a 0,41 % (un diodo por celda). No es un porcentaje de pérdida de potencia y no debe sumarse con los demás factores; la pérdida asociada se contabiliza en el factor P-05. | Curva I-V en inversa y termografía de la caja de conexiones; comprobación de continuidad del diodo | Gao et al., 2018; Al Mahdi et al., 2024 | L-015, L-005 | https://doi.org/10.1088/1674-4926/39/12/124014 | Alto (medido, fuente primaria) | Parcial (requiere ajuste)

Sheet: Sintesis y Vacios
SÍNTESIS Y DETECCIÓN DE VACÍOS
Todos los valores se calculan solos a partir de las dos matrices. No escriba números aquí.
1. PANORAMA DE LA LITERATURA
Documentos registrados
Año más antiguo
Año más reciente
Año promedio de publicación
Publicados en los últimos 5 años
% de literatura reciente
2. DISTRIBUCIÓN POR MÉTODO (¿qué enfoque está sobre/sub representado?)
Método | N° docs | % del total
3. DISTRIBUCIÓN POR TIPO DE FUENTE
Tipo de fuente | N° docs | % del total
4. RELEVANCIA DECLARADA
Relevancia | N° docs | % del total
5. CONTROL DE CALIDAD Y VACÍOS DE LA REVISIÓN
Registros sin limitación anotada
Registros sin vacío identificado
Registros sin fuente (DOI / URL)
Registros sin resultado cuantitativo
Registros sin método declarado
Semáforo de completitud
6. PÉRDIDAS DEL PROYECTO
Factores identificados por los alumnos
Pérdida promedio reportada
Pérdida mínima reportada
Pérdida máxima reportada
Pérdida acumulada (suma de mecanismos)
Mecanismos sin fuente citada
Mecanismos sin vínculo a la literatura
Mecanismos con confianza baja
Mecanismos de aplicación directa al proyecto
7. AVANCE POR ÁMBITO (¿qué zona del sistema aún no exploran?)
Ámbito | Factores hallados | Con % y fuente
Campos por completar en la matriz del proyecto
Semáforo del equipo
8. LECTURA AUTOMÁTICA DE LOS CINCO VACÍOS (criterios de la hoja Instrucciones)
Criterio | Veredicto | Indicador que lo sustenta
1. Vacío temporal — ¿la literatura está desactualizada?
2. Vacío metodológico — ¿domina un solo método?
3. Vacío de contexto — ¿alguien estudió nuestra región?
4. Vacío de evidencia — ¿hay datos sin respaldo o débiles?
5. Limitaciones repetidas — ¿el mismo límite en varios autores?
9. QUÉ SIGNIFICA CADA VACÍO — LECTURA DEL EQUIPO
1. TEMPORAL — no hay vacío, y eso cambia lo que hay que justificar. El 70 % de los registros es de los últimos cinco años, así que el tema está vivo y actualizado. La consecuencia práctica es la inversa de la esperada: cada fuente anterior a 2021 (L-027 de 2015, L-001 de 2016, L-016 y L-025 de 2017, L-007 y L-030 de 2018) hay que justificarla por su valor fundacional o por ser la única disponible, no por falta de alternativas recientes.
2. METODOLÓGICO — hay diversidad, pero con dependencia de fuentes secundarias. Las revisiones sistemáticas son el grupo más numeroso (15 de 43), frente a 12 trabajos experimentales, 4 de monitoreo de campo y 4 de simulación. Ninguna categoría supera el 50 %, así que formalmente no hay vacío metodológico. El riesgo real es otro: buena parte de los porcentajes que citamos vienen de revisiones, es decir, de segunda mano. Regla de trabajo: al leer, rastrear cada cifra hasta el estudio primario que la midió.
3. DE CONTEXTO — este es nuestro vacío principal y el que justifica el proyecto. Sí existe producción latinoamericana revisada por pares: Colombia (L-009 soiling en el Caribe, L-013 arreglos degradados), Brasil (L-010, L-011, L-033), Cuba (L-034 modelos LSTM/CNN) y Ecuador (L-029). Pero de Centroamérica el único registro es Costa Rica (L-030), y es un análisis de tiempo de retorno energético que explícitamente NO examina tasas de degradación: asume 25 años de vida útil sin medirla. No se localizó ninguna serie de monitoreo eléctrico continuo publicada para El Salvador.
4. DE EVIDENCIA — siete señales sobre cuatro mecanismos, ninguna inventada. Tres mecanismos llevan nivel de confianza declarado BAJO (P-14 baja irradiancia, P-16 pérdidas de cableado y P-17 MPPT anclado en máximo local) y cuatro quedan sin porcentaje registrado: esos tres más P-18. En P-18 (diodo de bypass) lo publicado es la PROBABILIDAD de que aparezca un punto caliente (de 99,18 % a 0,41 % según la densidad de diodos), que no es un porcentaje de pérdida de potencia y por eso no se registró como tal. Además, cuatro fuentes (L-011, L-023, L-024, L-038) quedaron con solo metadatos verificados por muro de pago. Todo esto está declarado, no rellenado.
5. LIMITACIONES REPETIDAS — el patrón que se vuelve problema de investigación. Ocho estudios independientes declaran la misma restricción: «un solo emplazamiento» o «un solo módulo». A eso se suman cinco revisiones sin datos experimentales propios. Cuando la misma limitación aparece en ocho autores que no se conocen entre sí, deja de ser un defecto de cada estudio y pasa a ser el estado del arte: falta evidencia multi-sitio, con instrumentación comparable y trazabilidad de incertidumbre. Ese es exactamente el hueco al que nuestro prototipo puede contribuir.
10. VACÍO DECLARADO DEL PROYECTO (criterio de la Guía del Alumno)
No existe una serie de monitoreo eléctrico continuo, levantada con instrumentación de bajo costo y con trazabilidad declarada de su incertidumbre, que permita estimar de forma PROSPECTIVA la tasa de degradación de un panel fotovoltaico en clima tropical centroamericano y traducirla en un umbral accionable de mantenimiento preventivo.
Sustento numérico del vacío: las tasas medidas en climas cálidos y húmedos —1,55 %/año en 19 años de operación (L-031) y hasta 2,56 %/año en policristalino a 15 años (L-006)— duplican o cuadruplican la mediana mundial de 0,5–0,6 %/año (L-001). Un umbral de alerta calibrado con la literatura agregada llegaría tarde en nuestro emplazamiento. Sustento metodológico: la mayoría de las técnicas de estimación converge a ±0,2 %/año recién a los 5 años de datos, y con 50 % de datos faltantes todas sobrestiman la degradación en más de 0,6 %/año (L-036).
11. PENDIENTES DE EVIDENCIA — LO QUE FALTA DOCUMENTAR
Punto pendiente | Dónde está | Acción concreta
P-14 · Baja irradiancia sin porcentaje | Matriz Proyecto, fila 18 | Solicitar por biblioteca institucional el texto completo de L-025 (Mavromatakis et al., 2017, Solar Energy)
P-16 · Pérdidas de cableado DC/AC sin fuente | Matriz Proyecto, fila 20 | Buscar norma de instalación o estudio de planta que reporte el % de pérdida óhmica de conductores
P-17 · Costo energético del MPPT anclado en máximo local | Matriz Proyecto, fila 21 | Buscar un estudio que aísle esa pérdida; la literatura consultada documenta el mecanismo pero no lo cuantifica
L-011, L-023, L-024, L-038 · solo metadatos verificados | Matriz Literatura | Pedir los textos completos antes de la entrega de la semana 4; hoy no se les atribuye ninguna cifra
Recordatorio de la regla de oro de esta plantilla: si no se puede decir de dónde salió un número, ese número no existe para el estado del arte. Las celdas vacías de esta hoja y de la Matriz Proyecto son deliberadas y están explicadas; no son campos olvidados.
