Joshua203-byte/Pcb/PCB_ESP32_v19_paquete/PCB_ESP32_v19_componentes_1a1.pdf

## PBL Semiconductores - Monitor I-V v19

## JP1A

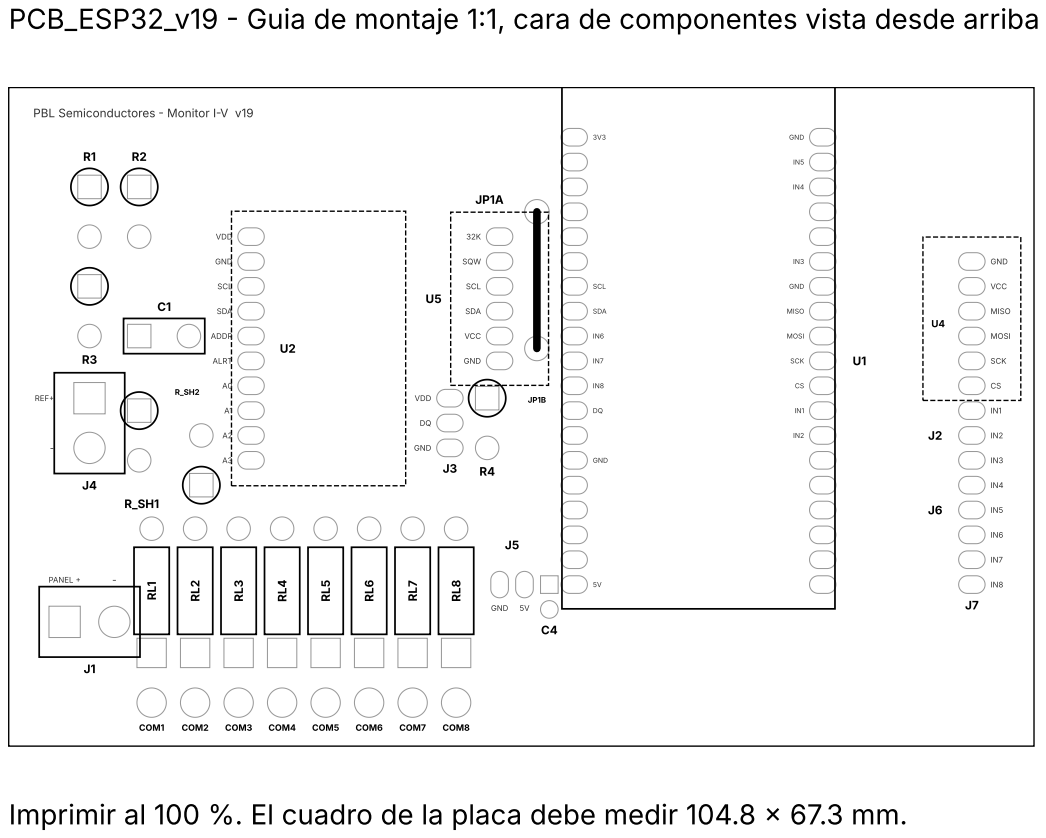
[picture p33: page 1]

PCB_ESP32_v19 - Guia de montaje 1:1, cara de componentes vista desde arriba

Imprimir al 100 %. El cuadro de la placa debe medir 104.8 x 67.3 mm.

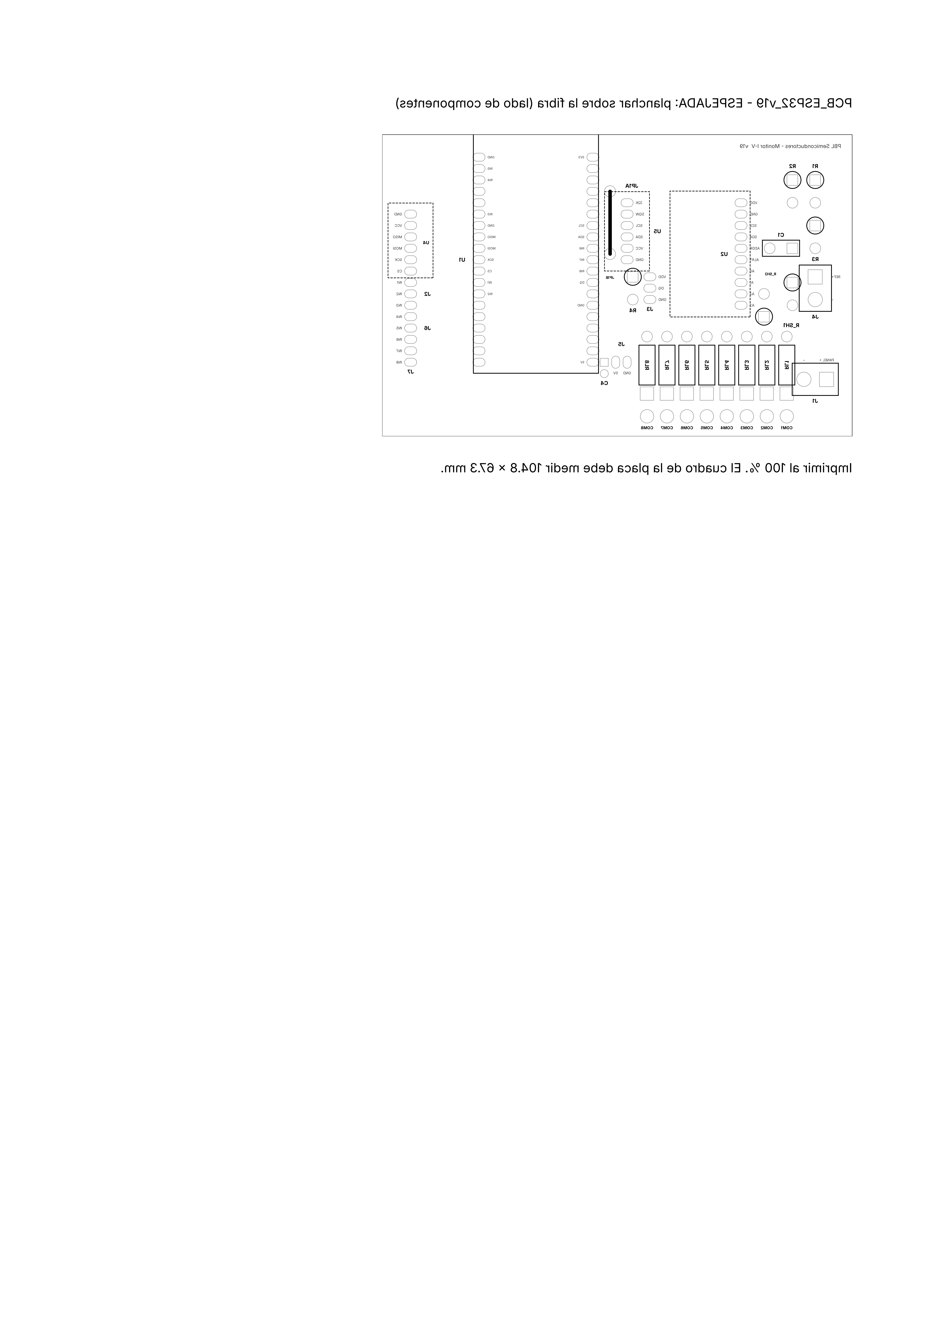
[picture p34: page 2]
