Joshua203-byte/Pcb/Sistema_medicion_panel.pdf

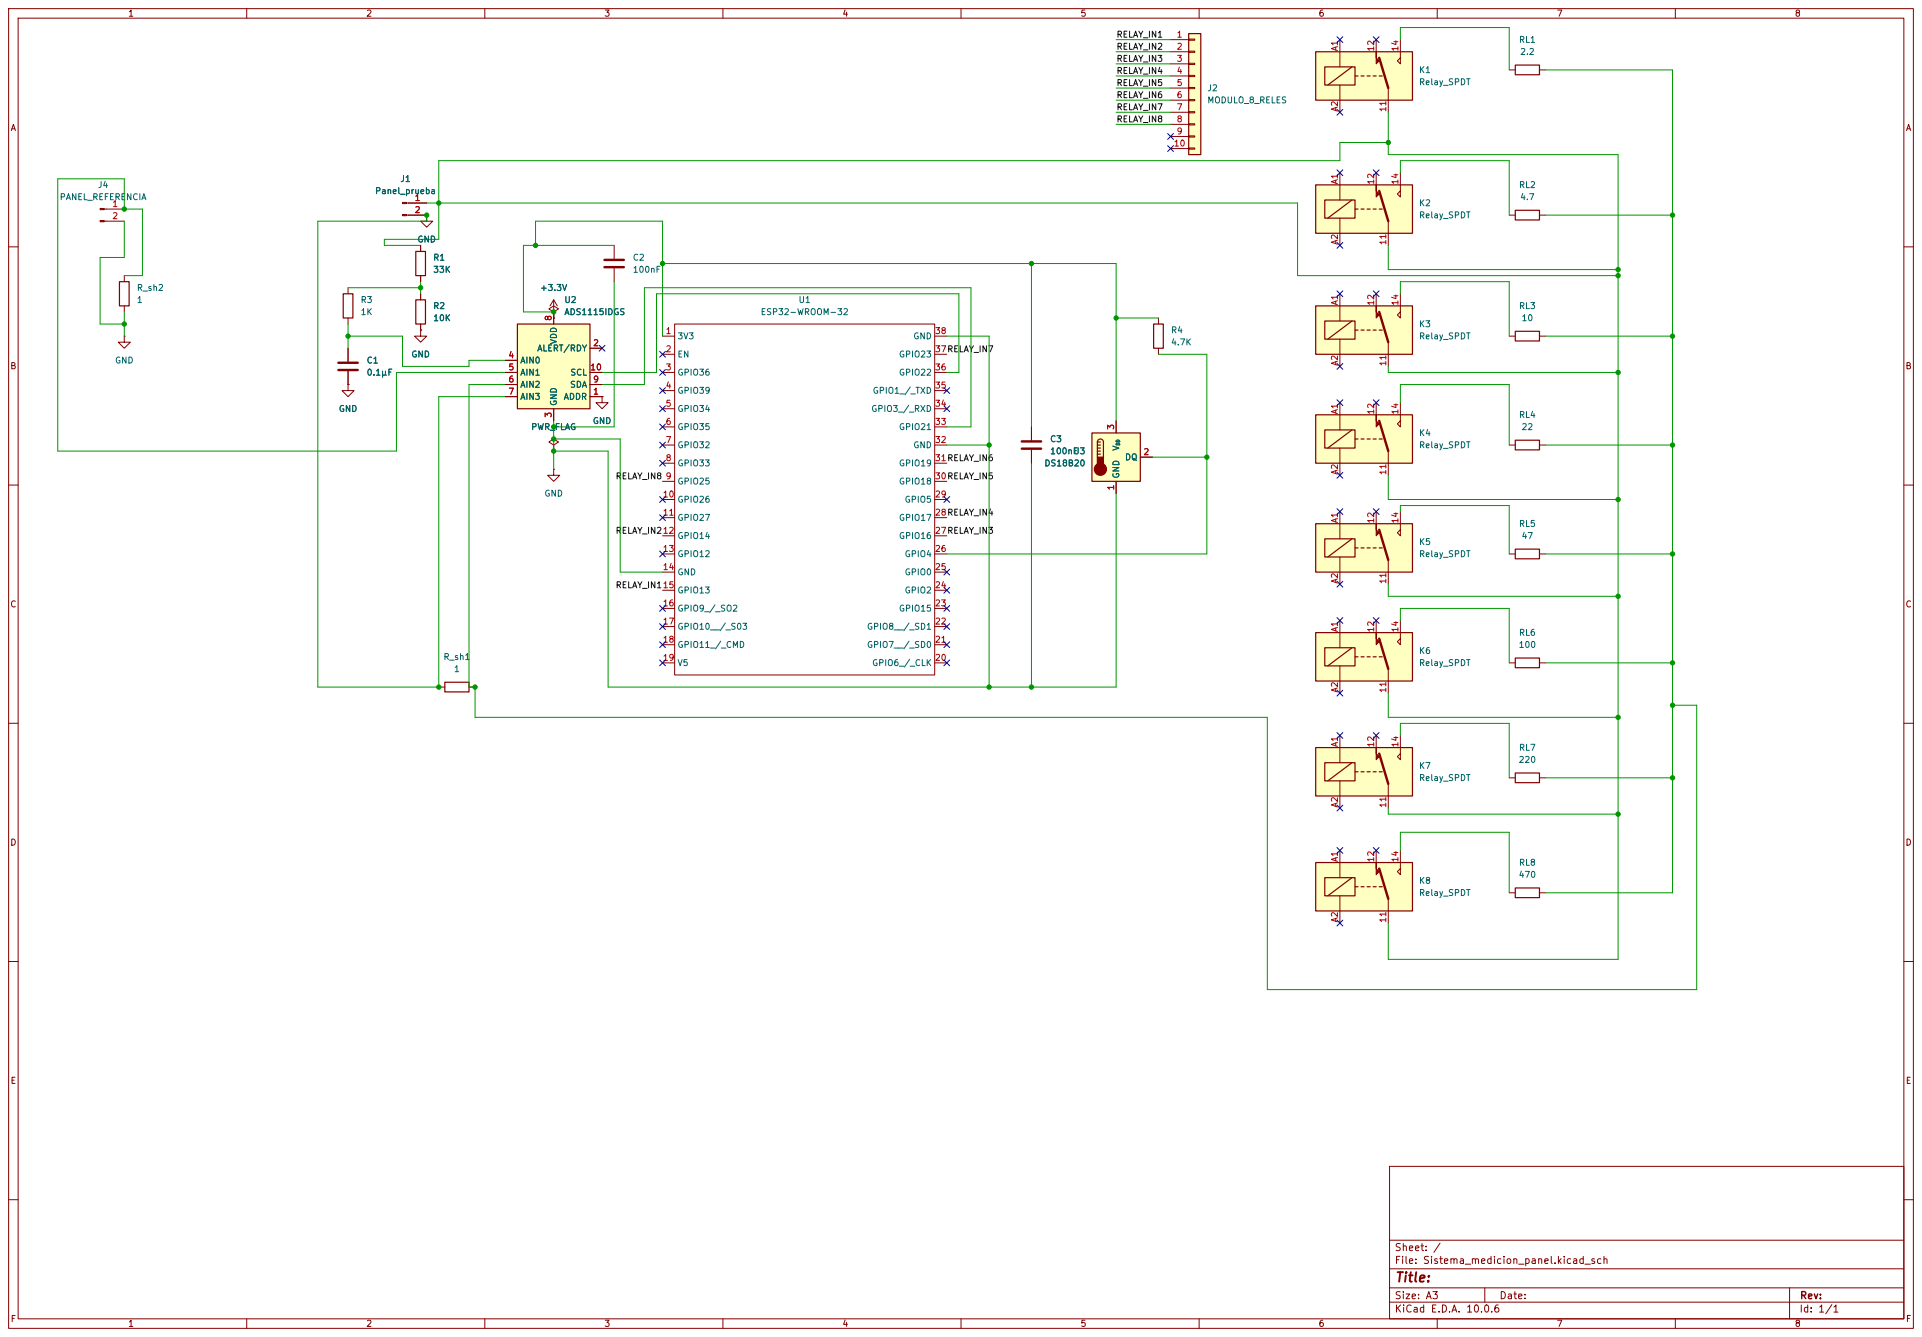
[picture p35: page 1]

Size: A3 | Rev: | F Date:
KiCad E.D.A. 10.0.6 | Id: 1/1
