Joshua203-byte/Pcb/Sistema_medicion_panel_corregido.pdf

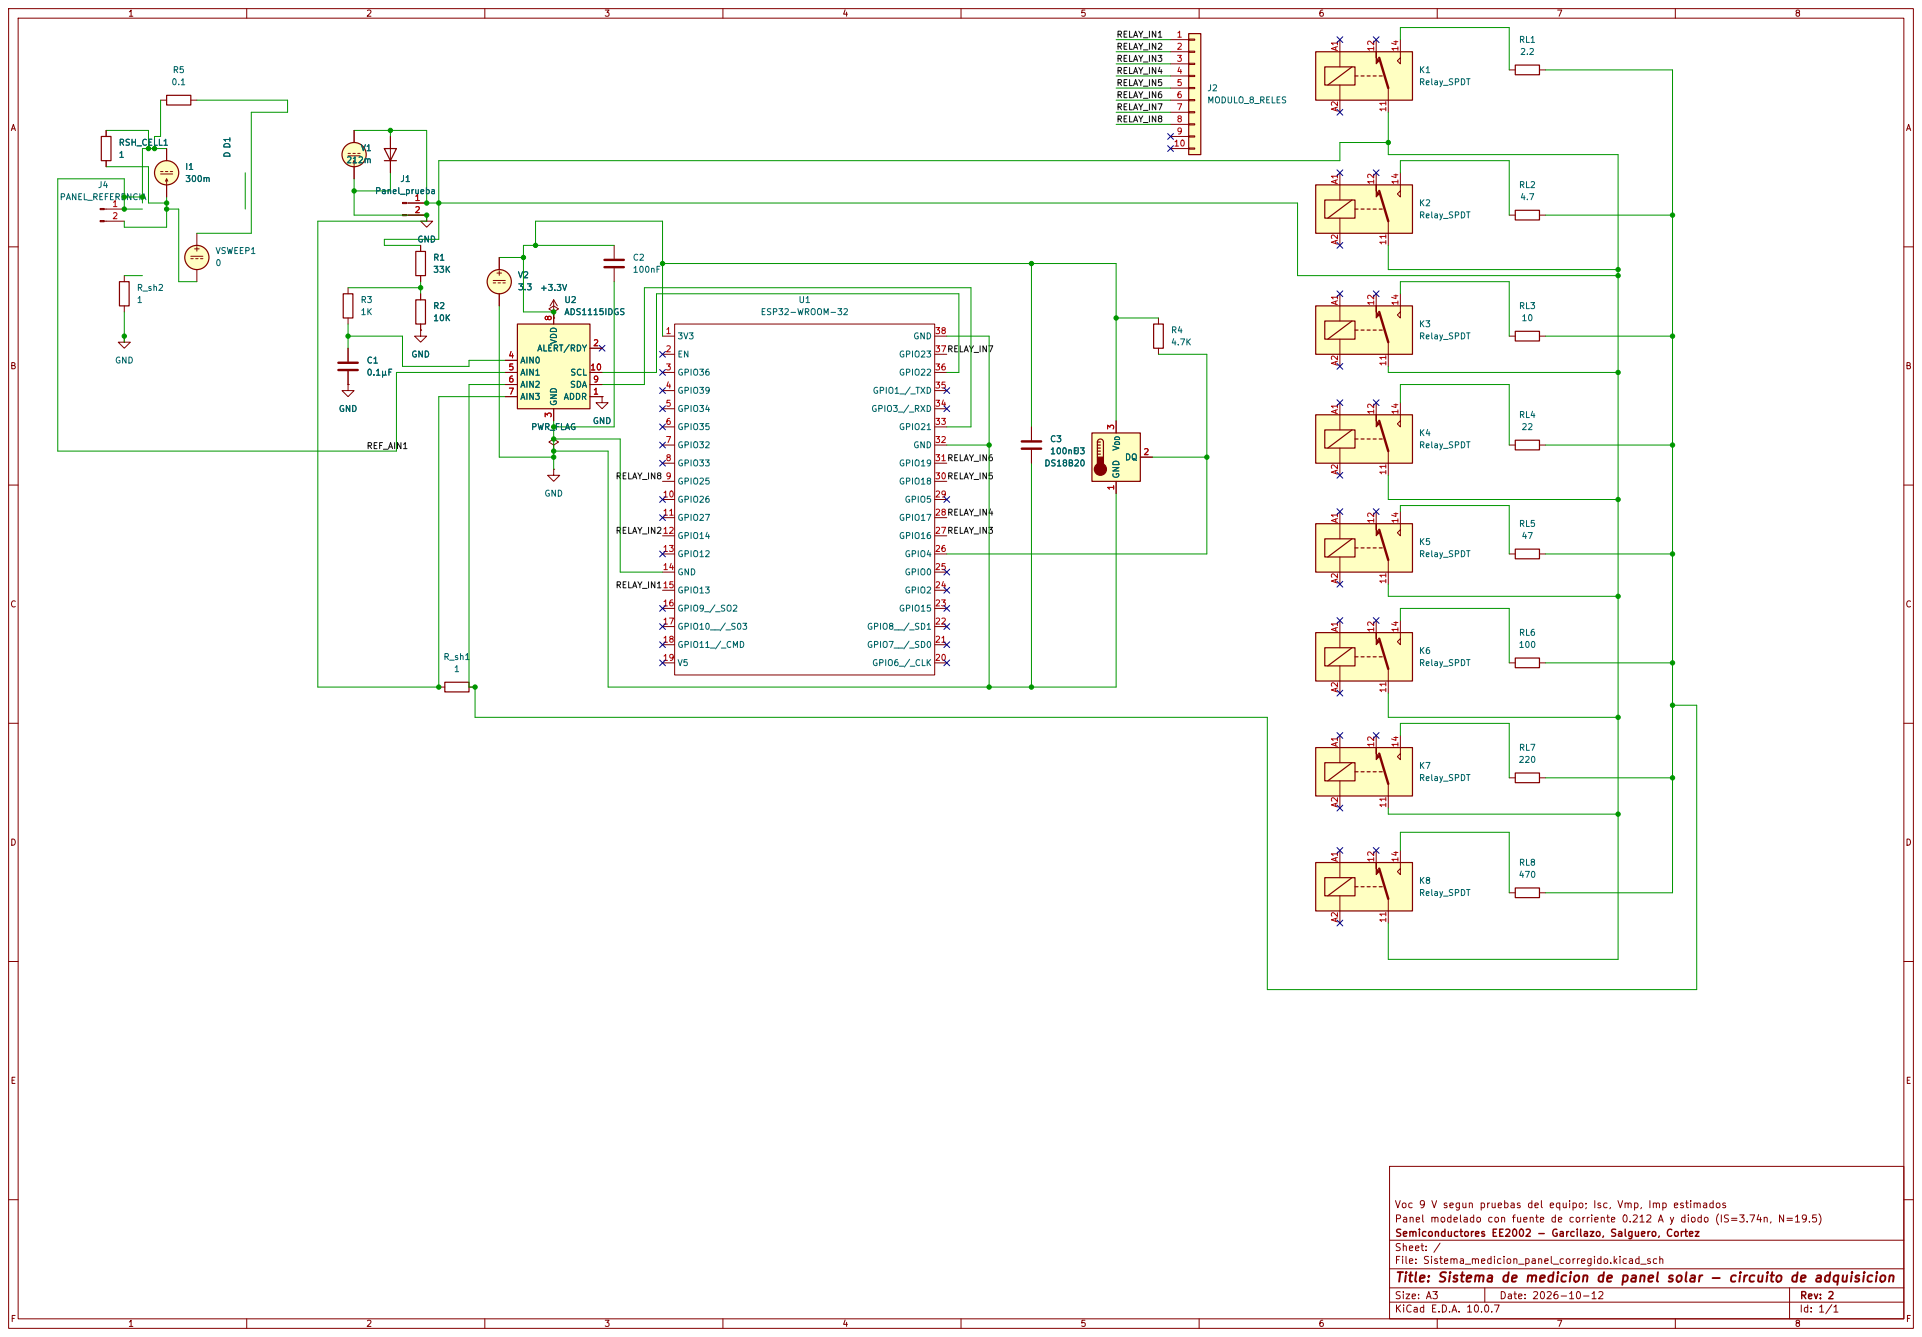
[picture p36: page 1]

Panel modelado con fuente de corriente 0.212 A y diodo (IS=3.74n, N=19.5)
Semiconductores EE2002 - Garcilazo, Salguero, Cortez
Sheet: /
File: Sistema_medicion_panel_corregido.kicad_sch
Title: Sistema de medicion de panel solar - circuito de adquisicion

Size: A3 | Rev: 2 | F Date: 2026-10-12
KiCad E.D.A. 10.0.7 | Id: 1/1
