Joshua203-byte/Pcb/PCB_ESP32_v19_paquete/PCB_ESP32_v19_cobre_1a1.pdf

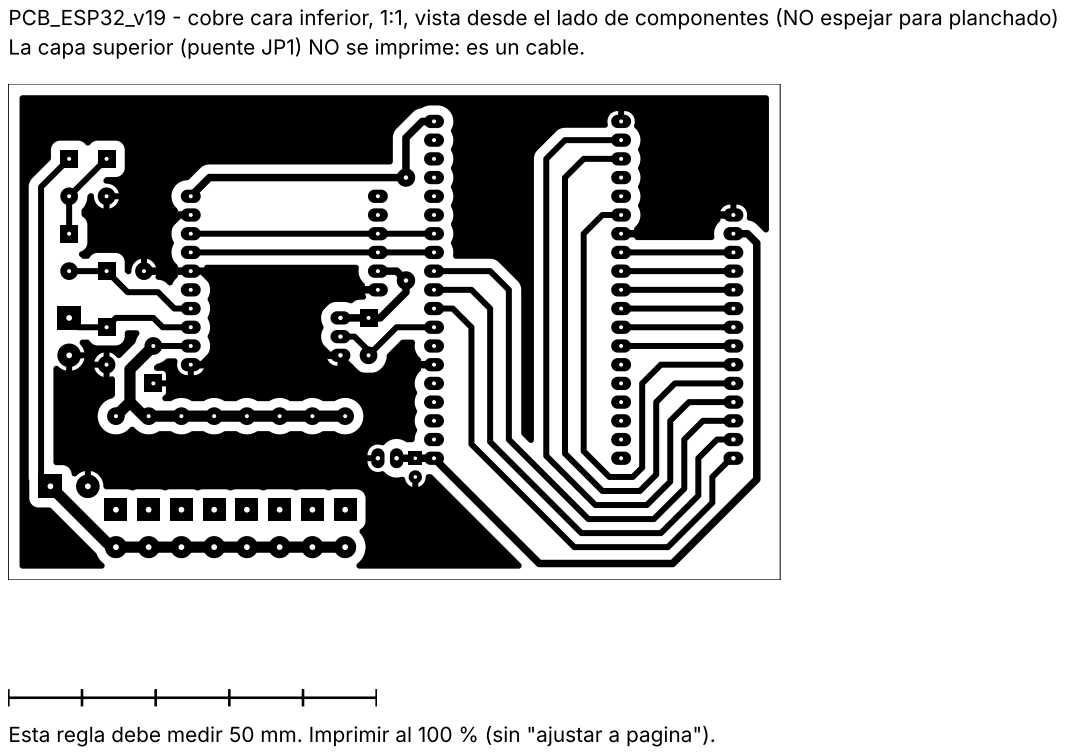
[picture p37: page 1]

PCB_ESP32_v19 - cobre cara inferior, 1:1, vista desde el lado de componentes (NO espejar para planchado)
La capa superior (puente JP1) NO se imprime: es un cable.

Esta regla debe medir 50 mm. Imprimir al 100 % (sin "ajustar a pagina").
