Joshua203-byte/Pcb/Simulacion/fig_sim_iv.pdf

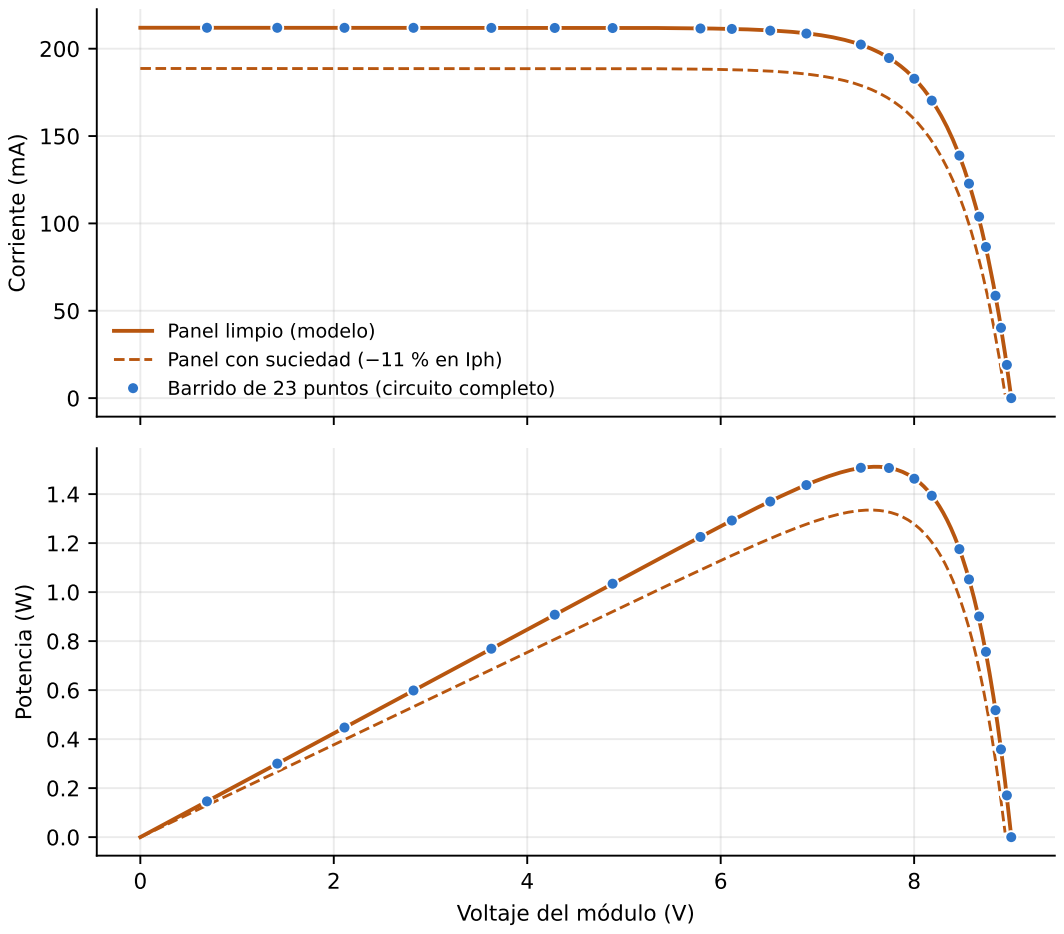
[picture p38: page 1]
Corriente (mA); Potencia (W)

Panel limpio (modelo)
Panel con suciedad (−11 % en Iph)
Barrido de 23 puntos (circuito completo)

Voltaje del módulo (V)
