Joshua203-byte/Pcb/PCB_ESP32_v19_paquete/PCB_ESP32_v19.brd

## EAGLE design PCB_ESP32_v19_paquete/PCB_ESP32_v19.brd (2026-11-04)

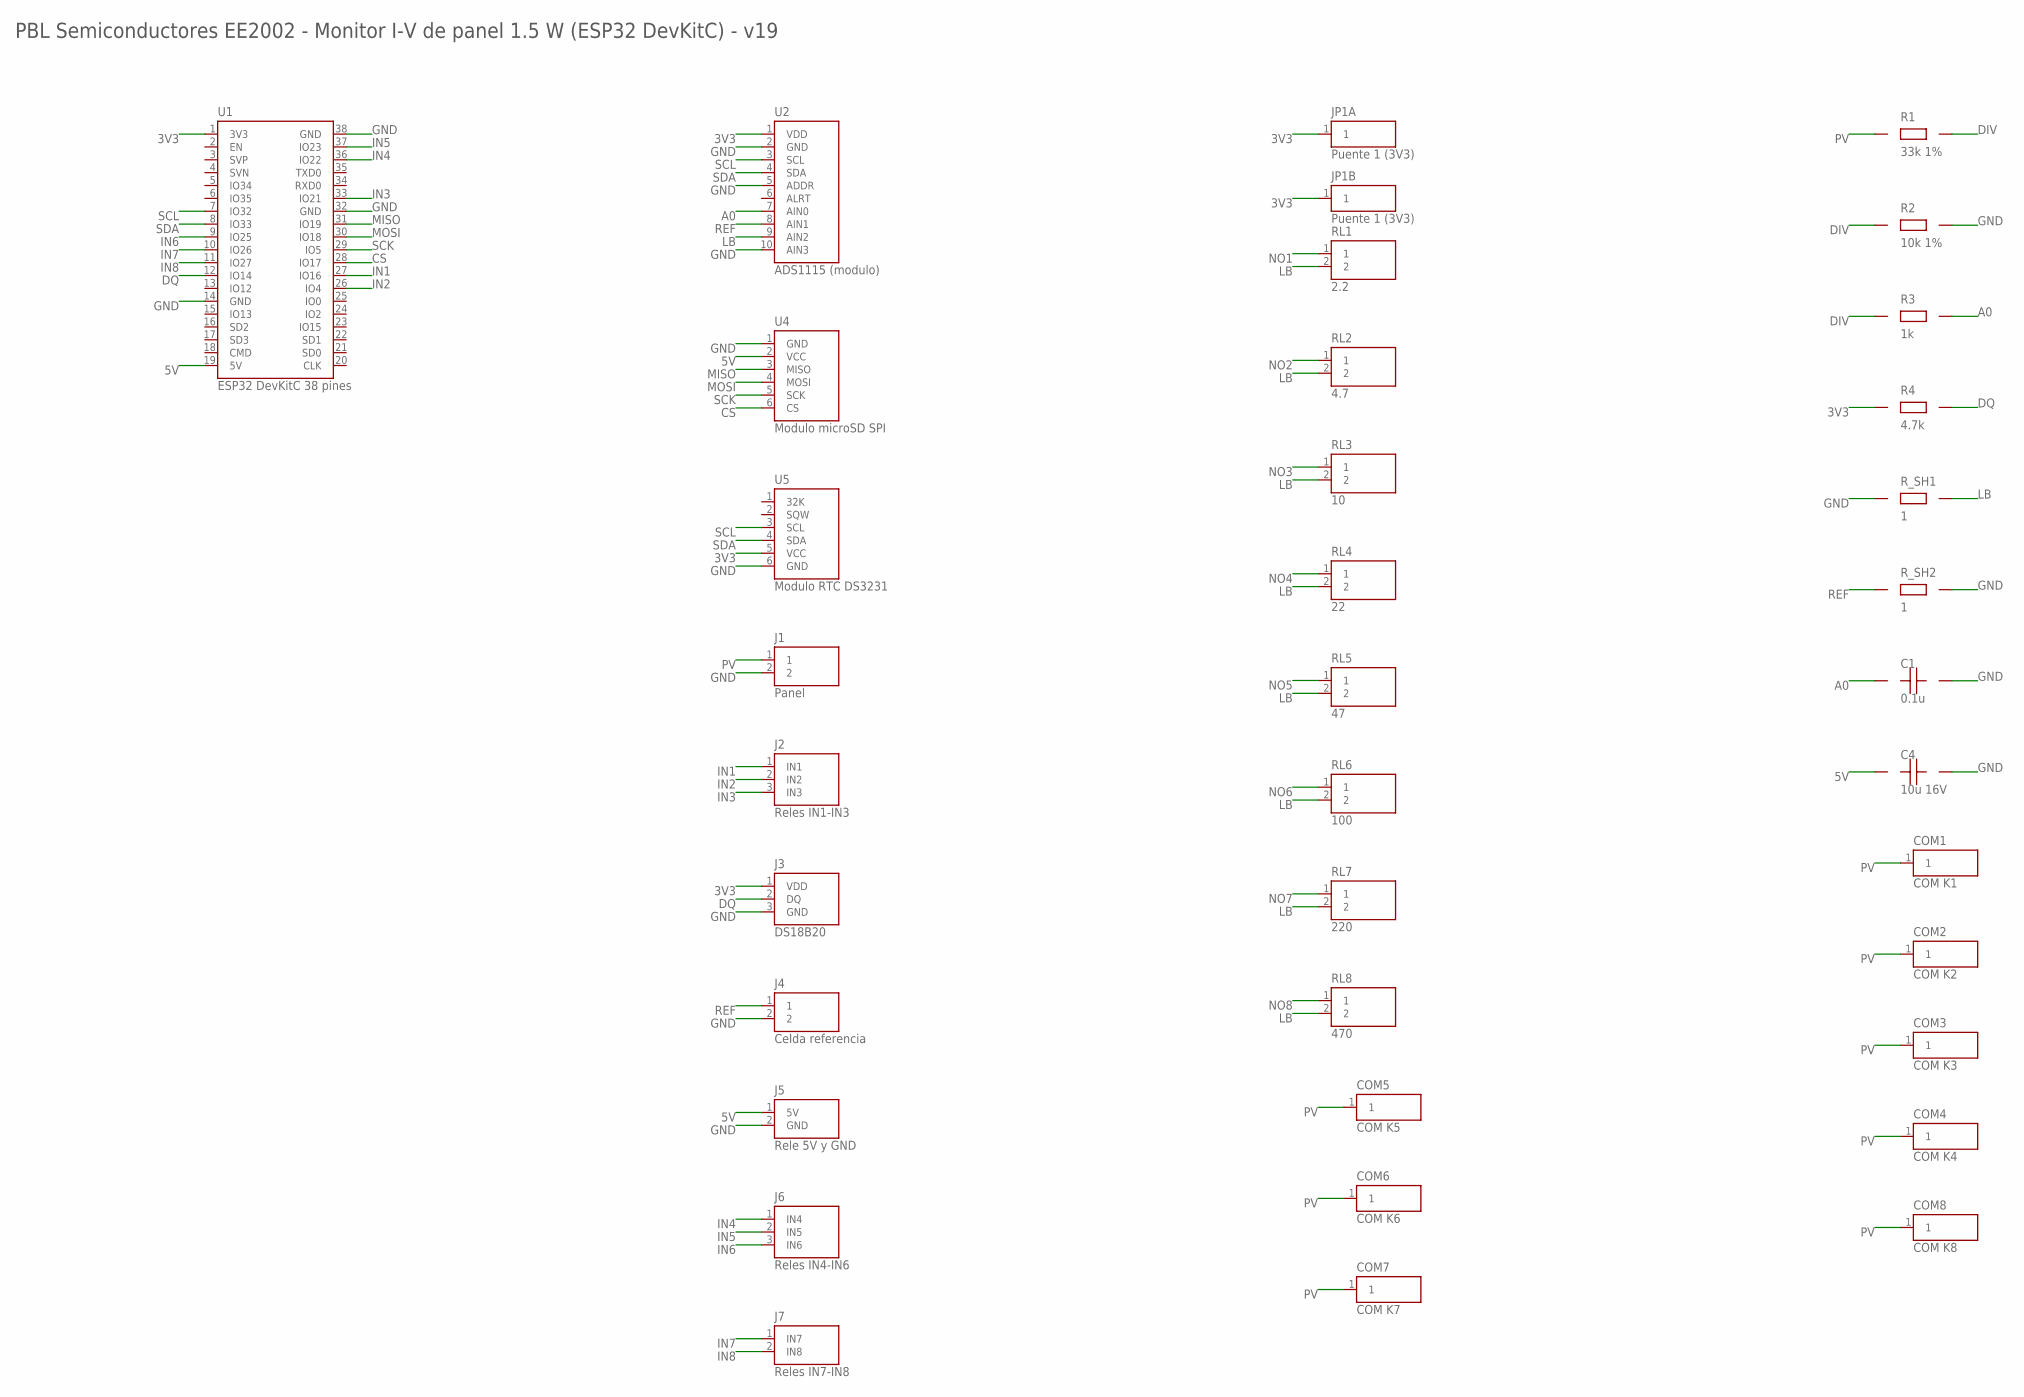
[picture p39: schematic PCB_ESP32_v19.sch]

Parts:
C1: 0.1u; CAP_5MM
C4: 10u 16V; CAP_E_2_54
COM1: COM K1; WIREPAD
COM2: COM K2; WIREPAD
COM3: COM K3; WIREPAD
COM4: COM K4; WIREPAD
COM5: COM K5; WIREPAD
COM6: COM K6; WIREPAD
COM7: COM K7; WIREPAD
COM8: COM K8; WIREPAD
J1: Panel; TERM2_5MM
J2: Reles IN1-IN3; MALE_1X03
J3: DS18B20; MALE_1X03
J4: Celda referencia; TERM2_5MM
J5: Rele 5V y GND; MALE_1X02
J6: Reles IN4-IN6; MALE_1X03
J7: Reles IN7-IN8; MALE_1X02
JP1A, JP1B: Puente 1 (3V3); JPAD
R1: 33k 1%; RES_V
R2: 10k 1%; RES_V
R3: 1k; RES_V
R4: 4.7k; RES_V
RL1: 2.2; RES_H_T
RL2: 4.7; RES_H_T
RL3: 10; RES_H_T
RL4: 22; RES_H_T
RL5: 47; RES_H_T
RL6: 100; RES_H_T
RL7: 220; RES_H_T
RL8: 470; RES_H_T
R_SH1, R_SH2: 1; RES_V
U1: ESP32 DevKitC 38 pines; ESP32_DEVKIT38
U2: ADS1115 (modulo); SOCKET_1X10
U4: Modulo microSD SPI; SOCKET_1X06
U5: Modulo RTC DS3231; SOCKET_1X06

Connections:
3V3: J3.1 (VDD), JP1A.1, JP1B.1, R4.1, U1.1 (3V3), U2.1 (VDD), U5.5 (VCC)
5V: C4.1 (+), J5.1 (5V), U1.19 (5V), U4.2 (VCC)
A0: C1.1, R3.2, U2.7 (AIN0)
CS: U1.28 (IO17), U4.6 (CS)
DIV: R1.2, R2.1, R3.1
DQ: J3.2 (DQ), R4.2, U1.12 (IO14)
GND: C1.2, C4.2 (-), J1.2, J3.3 (GND), J4.2, J5.2 (GND), R2.2, R_SH1.1, R_SH2.2, U1.14 (GND), U1.32 (GND), U1.38 (GND), U2.2 (GND), U2.5 (ADDR), U2.10 (AIN3), U4.1 (GND), U5.6 (GND)
IN1: J2.1 (IN1), U1.27 (IO16)
IN2: J2.2 (IN2), U1.26 (IO4)
IN3: J2.3 (IN3), U1.33 (IO21)
IN4: J6.1 (IN4), U1.36 (IO22)
IN5: J6.2 (IN5), U1.37 (IO23)
IN6: J6.3 (IN6), U1.9 (IO25)
IN7: J7.1 (IN7), U1.10 (IO26)
IN8: J7.2 (IN8), U1.11 (IO27)
LB: RL1.2, RL2.2, RL3.2, RL4.2, RL5.2, RL6.2, RL7.2, RL8.2, R_SH1.2, U2.9 (AIN2)
MISO: U1.31 (IO19), U4.3 (MISO)
MOSI: U1.30 (IO18), U4.4 (MOSI)
NO1: RL1.1
NO2: RL2.1
NO3: RL3.1
NO4: RL4.1
NO5: RL5.1
NO6: RL6.1
NO7: RL7.1
NO8: RL8.1
PV: COM1.1, COM2.1, COM3.1, COM4.1, COM5.1, COM6.1, COM7.1, COM8.1, J1.1, R1.1
REF: J4.1, R_SH2.1, U2.8 (AIN1)
SCK: U1.29 (IO5), U4.5 (SCK)
SCL: U1.7 (IO32), U2.3 (SCL), U5.3 (SCL)
SDA: U1.8 (IO33), U2.4 (SDA), U5.4 (SDA)

Notes on the sheet:
PBL Semiconductores EE2002 - Monitor I-V de panel 1.5 W (ESP32 DevKitC) - v19

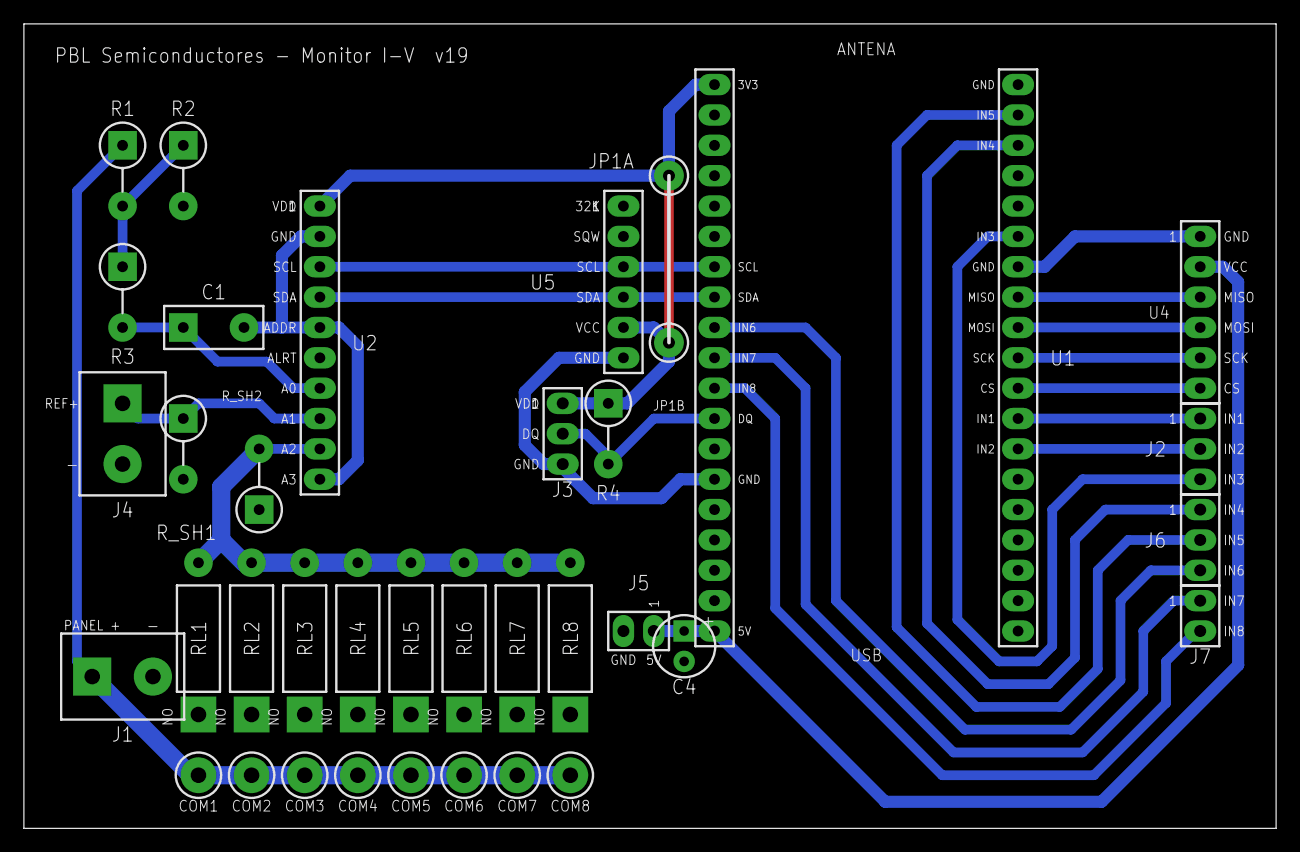
[picture p40: board PCB_ESP32_v19.brd from above]

Board: 2 copper layers, 104.8 x 67.3 mm, 37 parts (0 on the bottom side), 23 nets.
